samd-atlantis/A-14329-RG-Atlantis-Modem/hardware/easyeda/plug-labels-board-3d.png

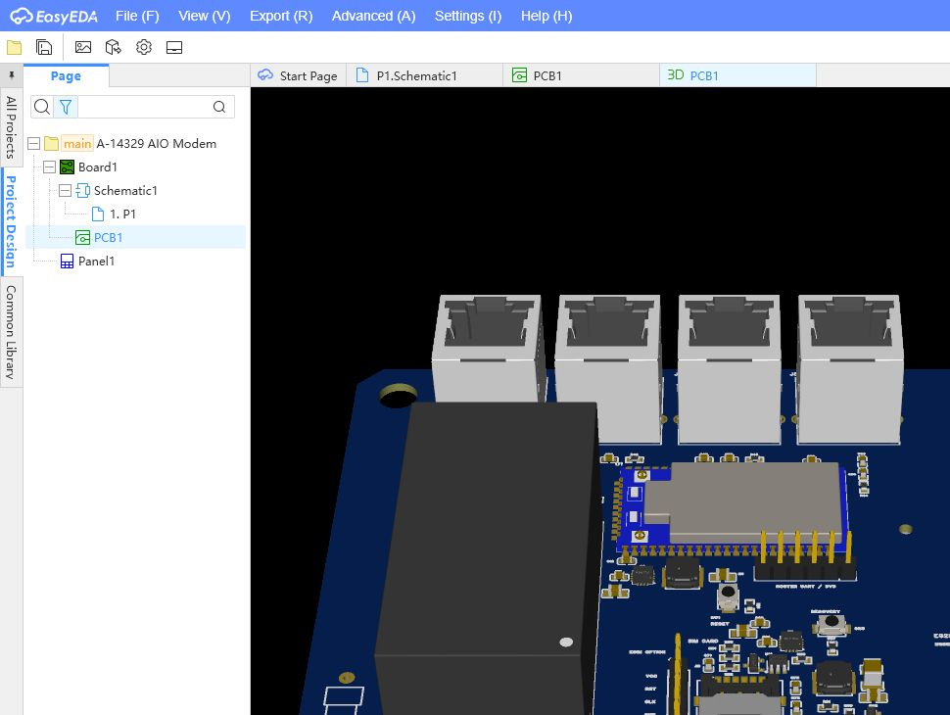
hardware/easyeda/plug-labels-board-3d.png
