samd-atlantis/A-14329-RG-Atlantis-Modem/hardware/rev-a/references/hlk-p11.png

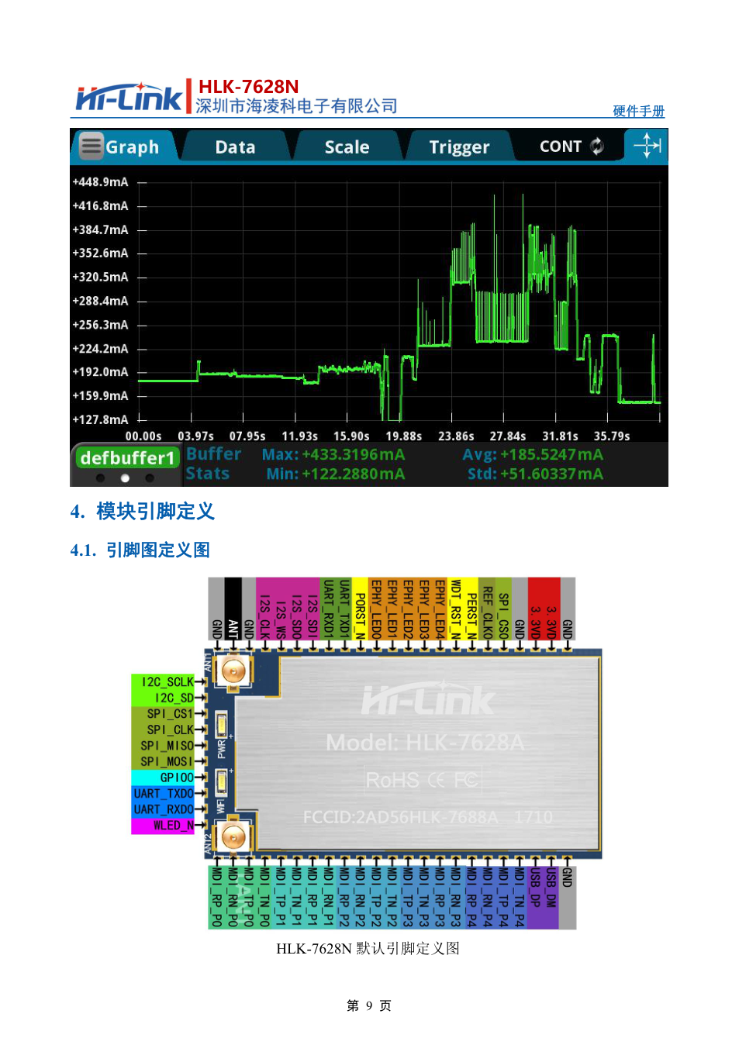
hardware/rev-a/references/hlk-p11.png
