samd-atlantis/A-14329-RG-Atlantis-Modem/firmware/preview/dashboard.png

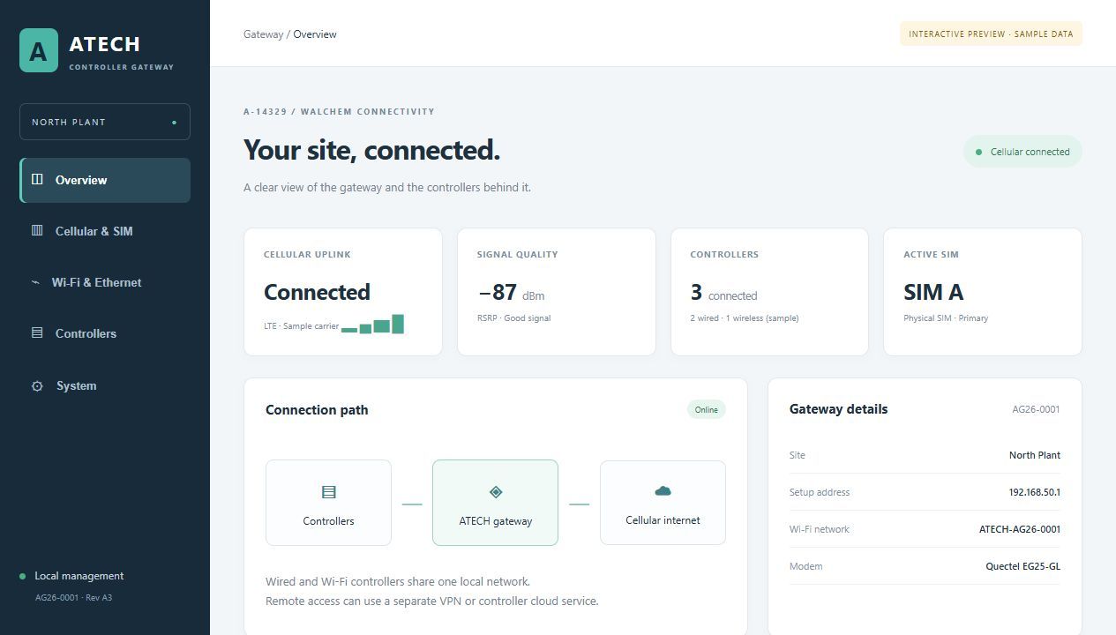
firmware/preview/dashboard.png
