samd-atlantis/A-14329-RG-Atlantis-Modem/hardware/easyeda/C3131-drawing.png

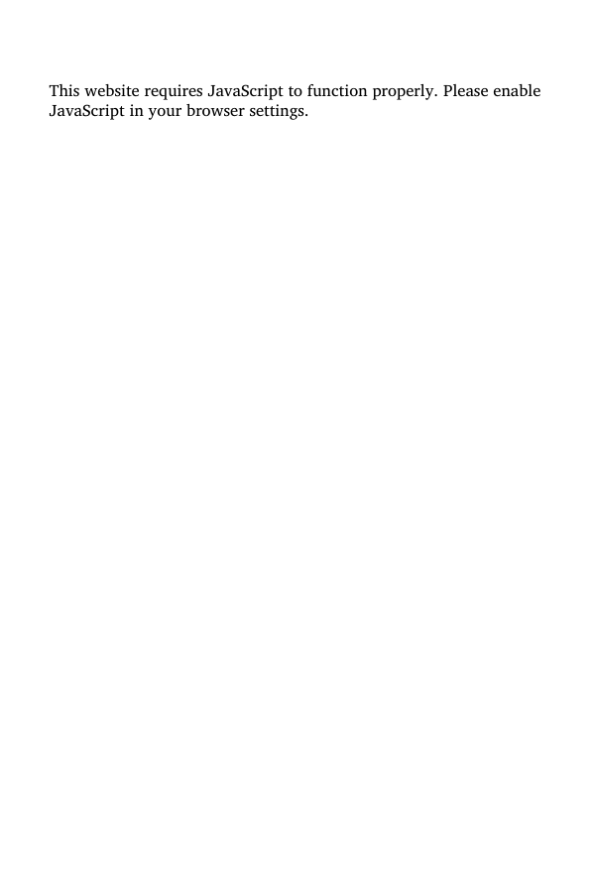
hardware/easyeda/C3131-drawing.png
