samd-atlantis/A-14329-RG-Atlantis-Modem/hardware/easyeda/C5187469-page2.png

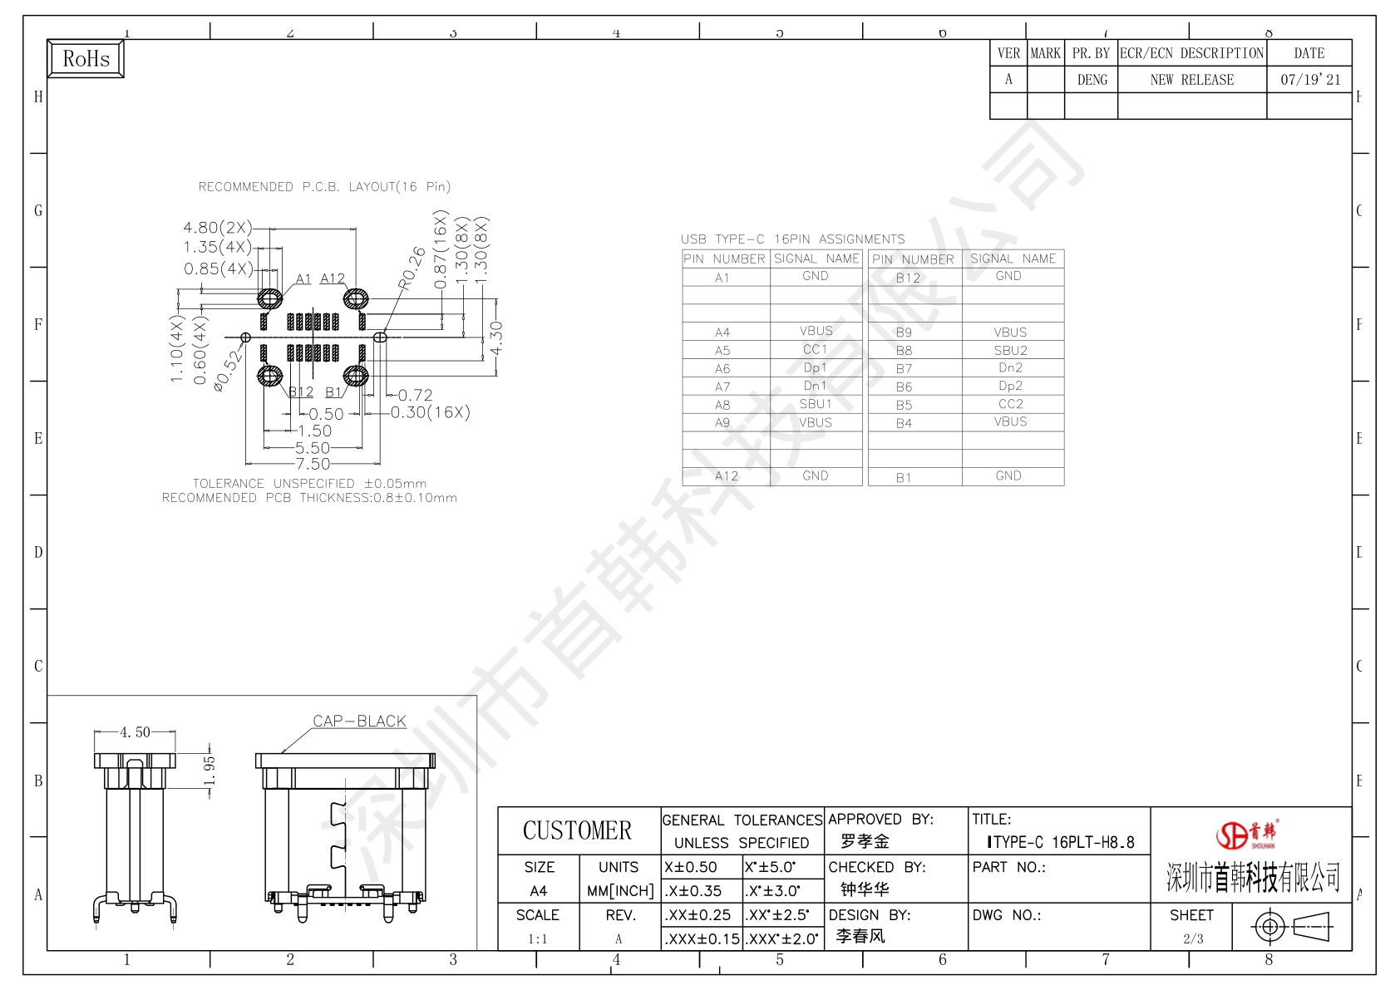
hardware/easyeda/C5187469-page2.png
