samd-atlantis/A-14329-RG-Atlantis-Modem/hardware/easyeda/C32713015-page1.png

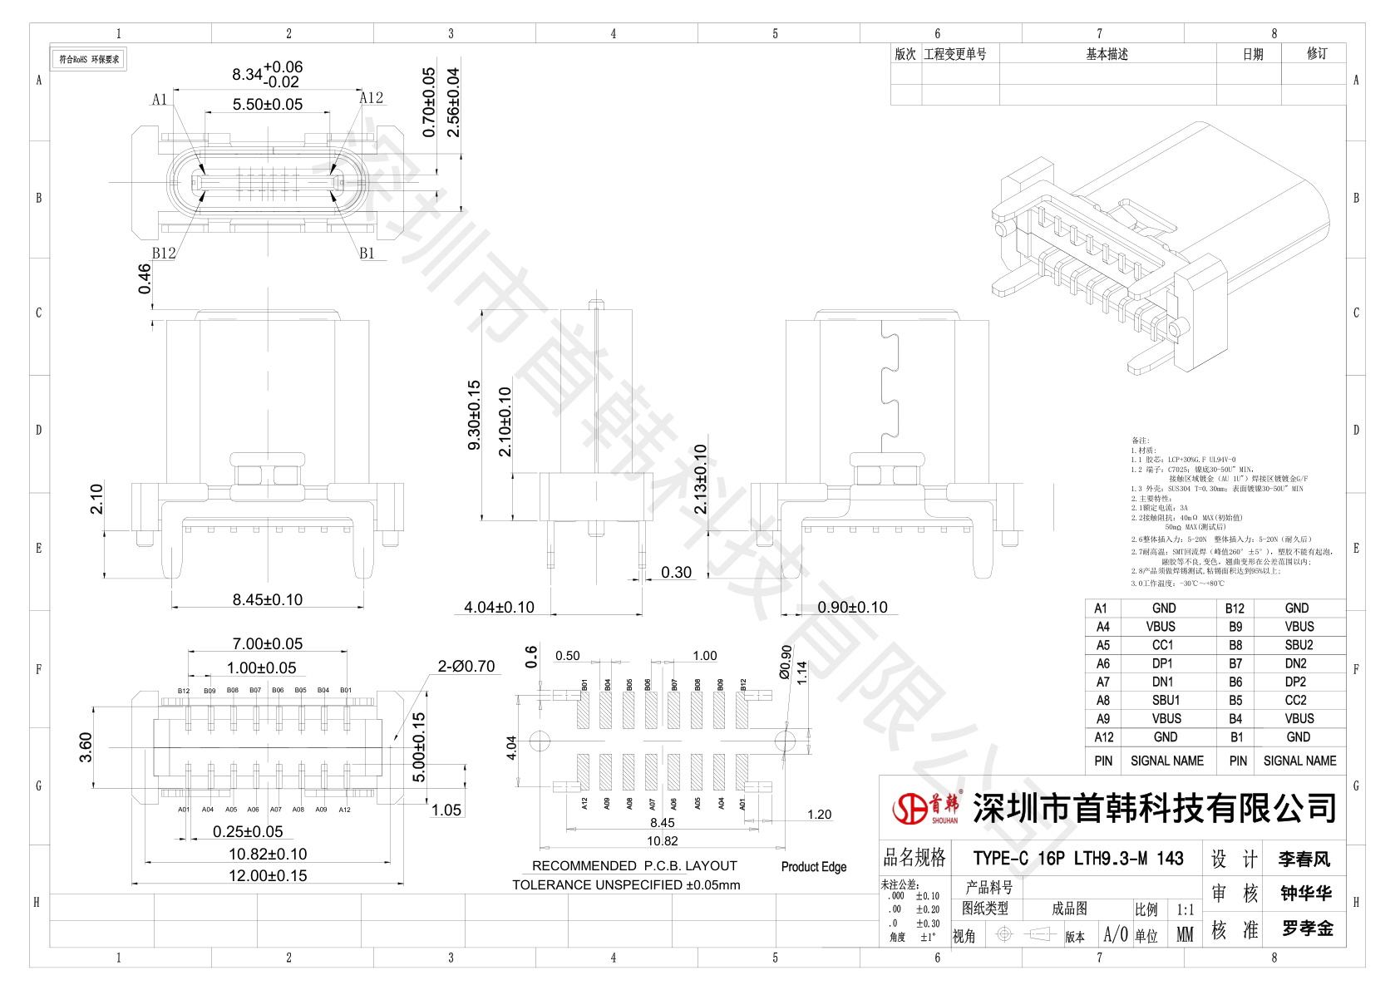
hardware/easyeda/C32713015-page1.png
