samd-atlantis/A-14329-RG-Atlantis-Modem/hardware/easyeda/C51912230-page1.png

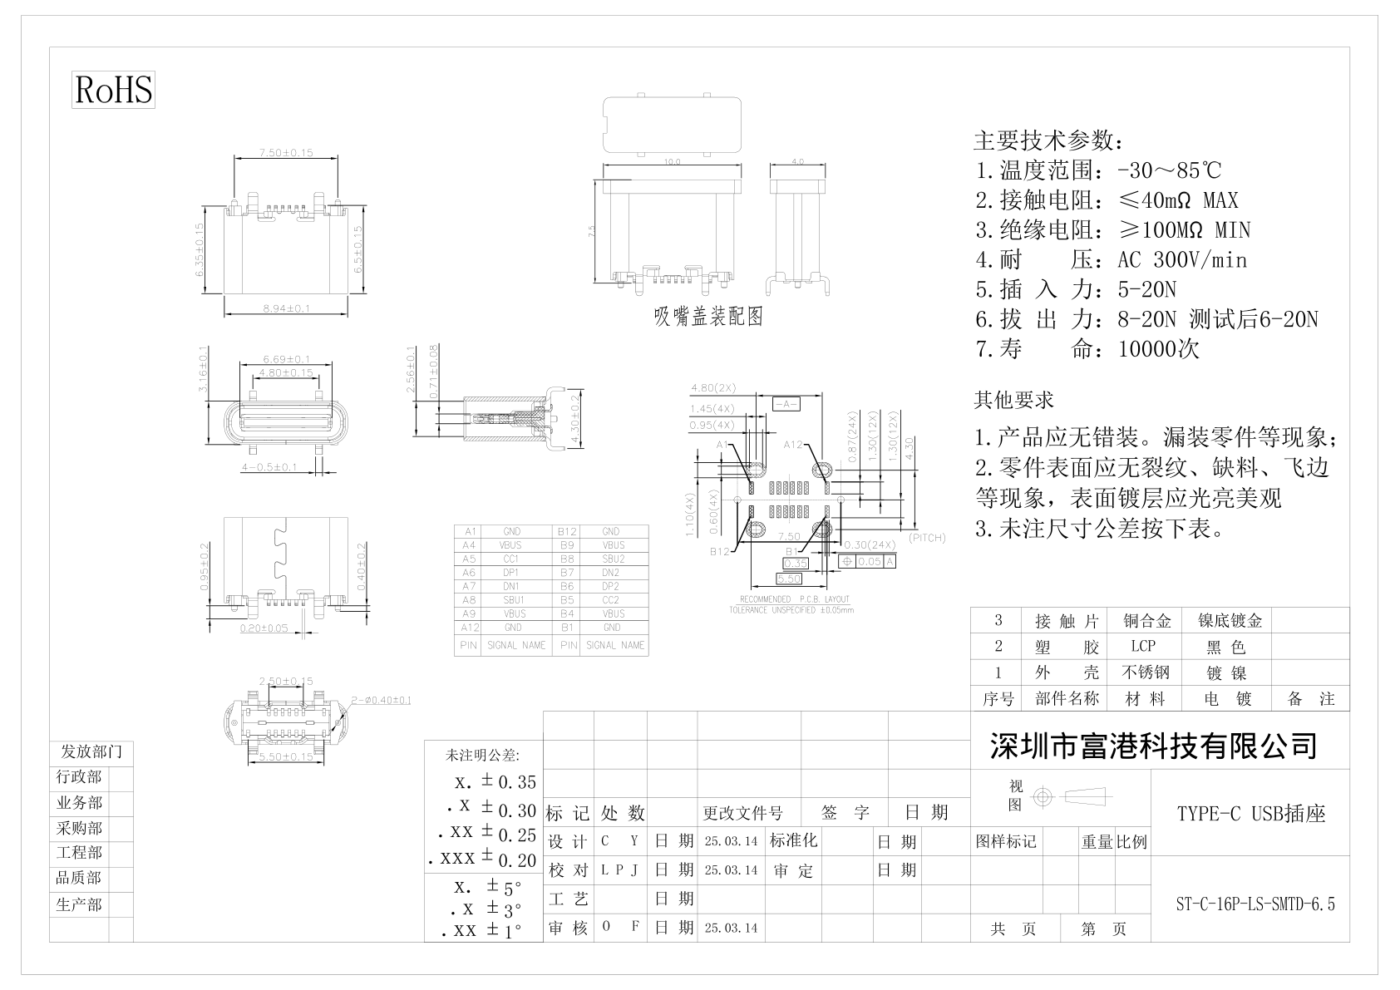
hardware/easyeda/C51912230-page1.png
