samd-atlantis/A-14329-RG-Atlantis-Modem/hardware/easyeda/drc-final42.png

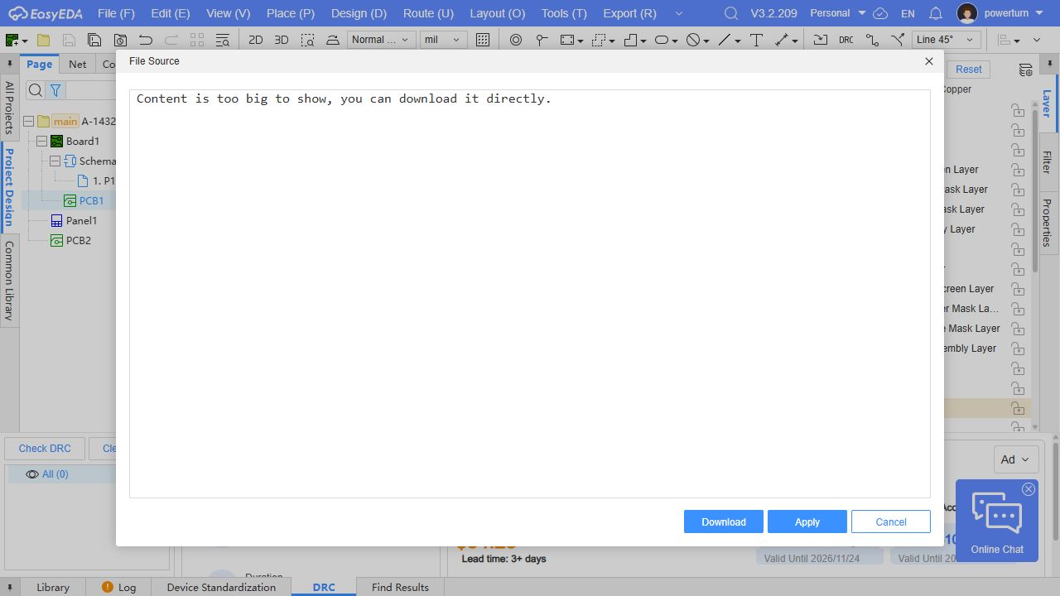
hardware/easyeda/drc-final42.png
