samd-atlantis/A-14329-RG-Atlantis-Modem/hardware/easyeda/drc-final43.png

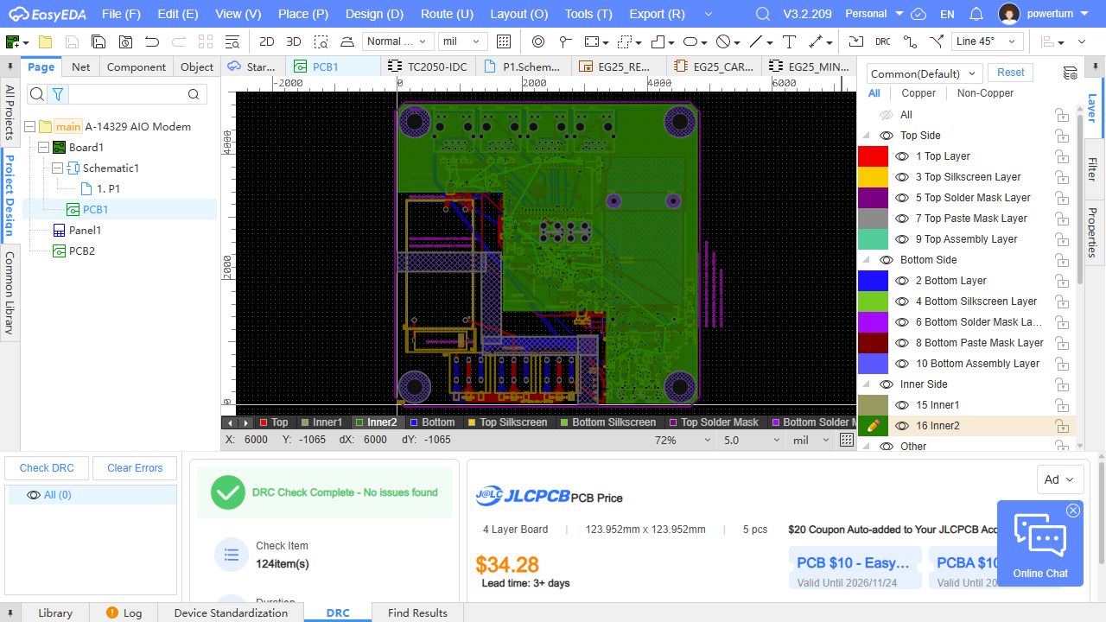
hardware/easyeda/drc-final43.png
