samd-atlantis/A-14329-RG-Atlantis-Modem/hardware/easyeda/dual-usbc-placement.png

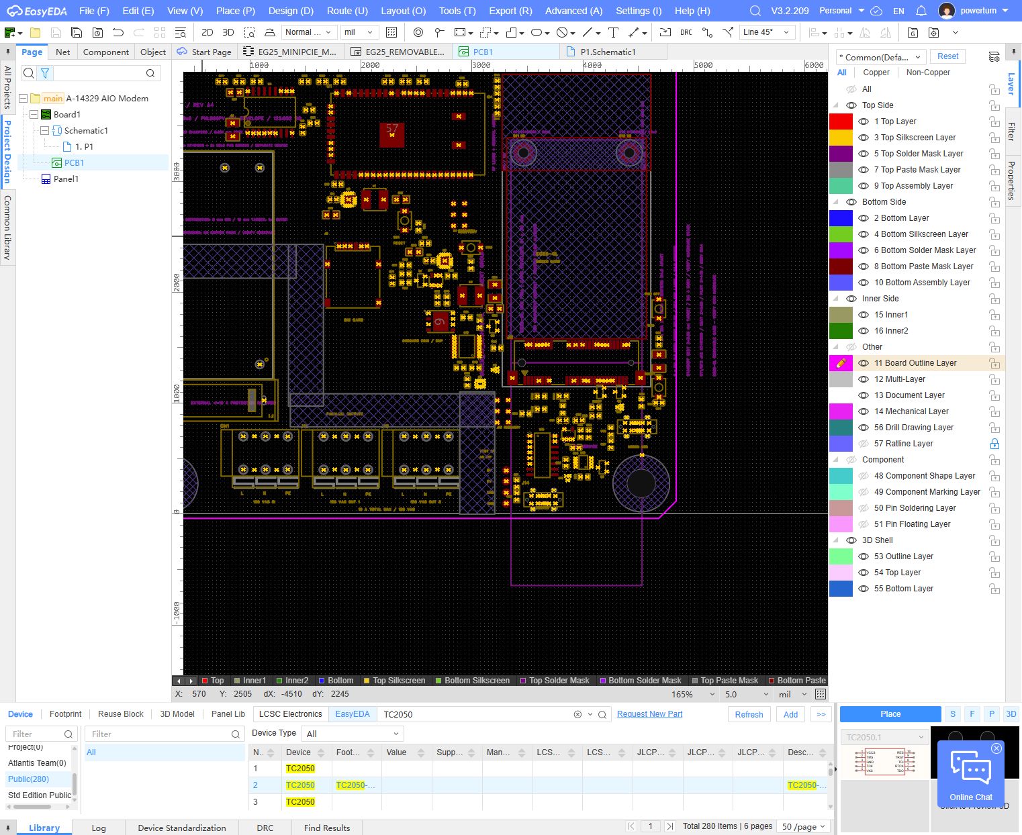
hardware/easyeda/dual-usbc-placement.png
