samd-atlantis/A-14329-RG-Atlantis-Modem/hardware/easyeda/ethernet-schematic-proof.png

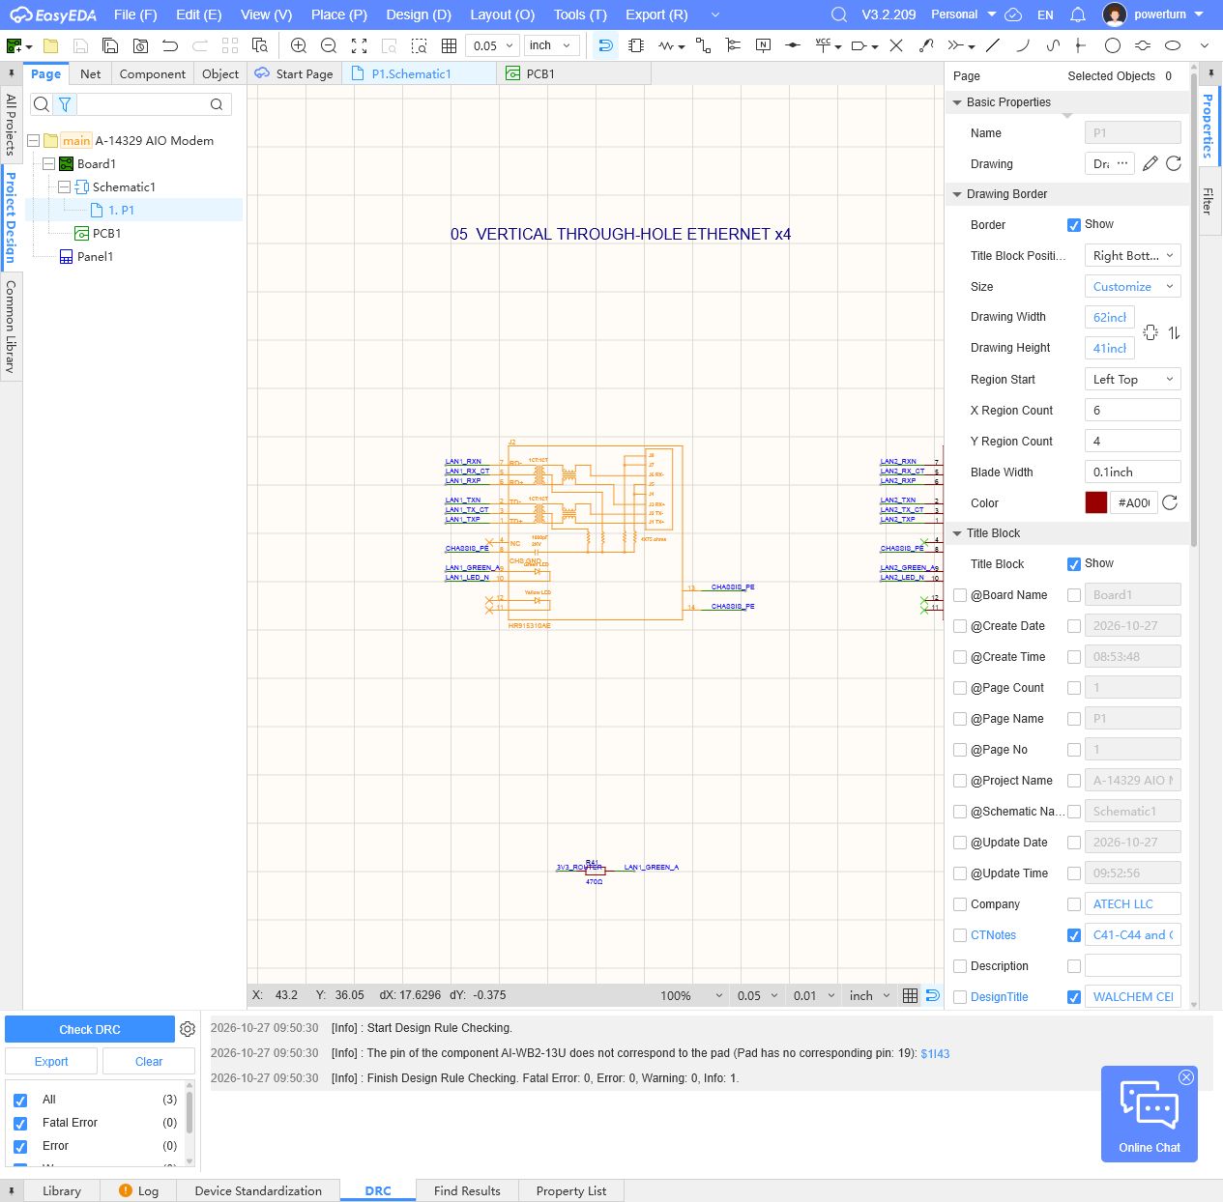
hardware/easyeda/ethernet-schematic-proof.png
