samd-atlantis/A-14329-RG-Atlantis-Modem/hardware/easyeda/hammond-a4-board-3d.png

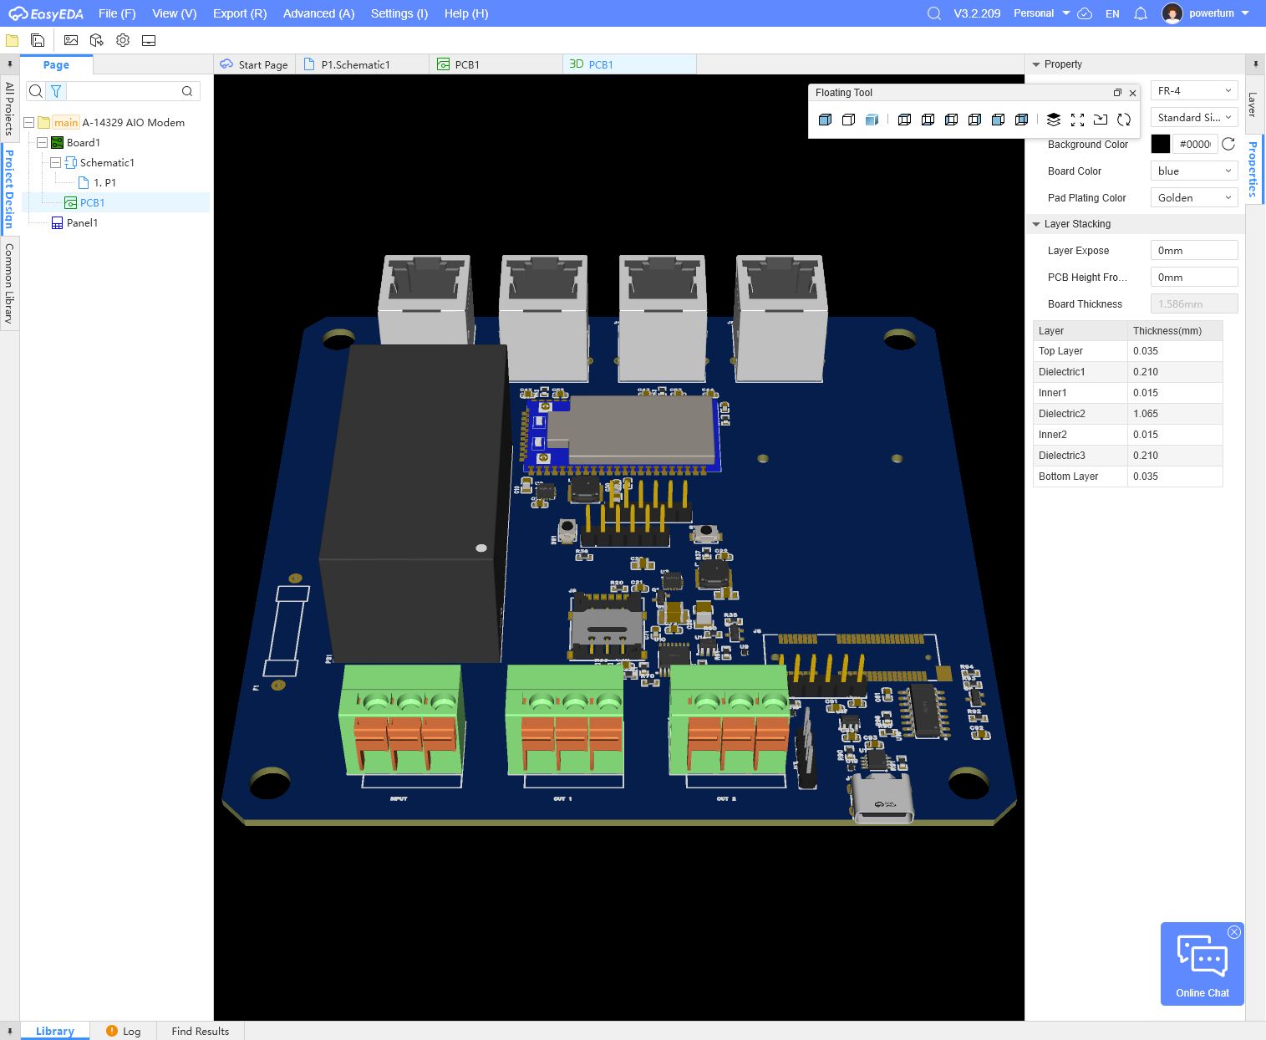
hardware/easyeda/hammond-a4-board-3d.png
