samd-atlantis/A-14329-RG-Atlantis-Modem/hardware/easyeda/hlk-center-tap-reference48.png

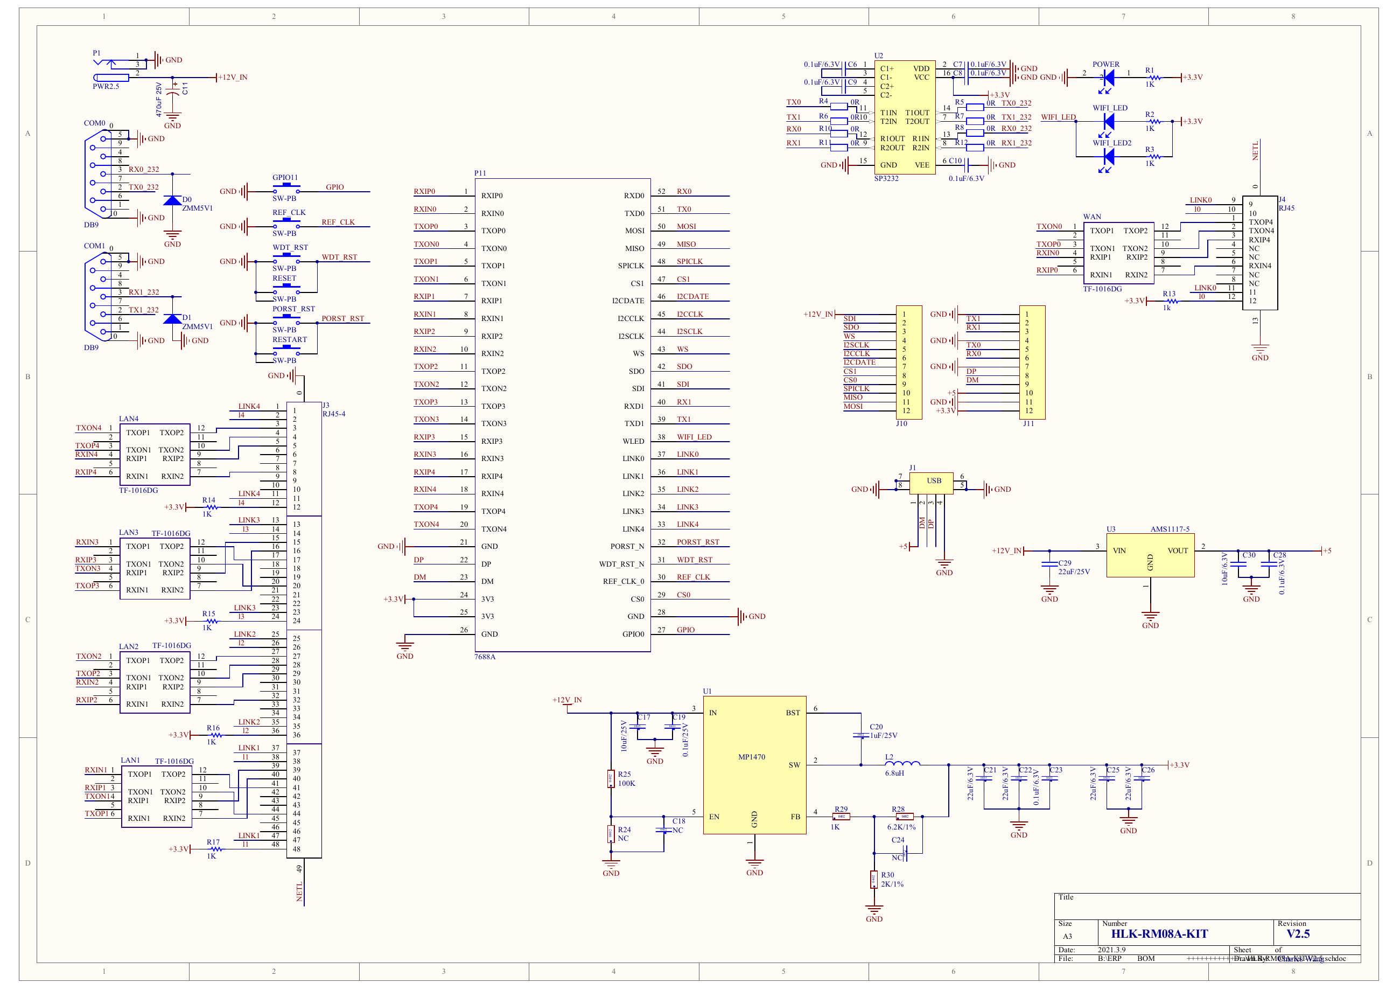
hardware/easyeda/hlk-center-tap-reference48.png
