samd-atlantis/A-14329-RG-Atlantis-Modem/hardware/easyeda/HR915310AE-review48.png

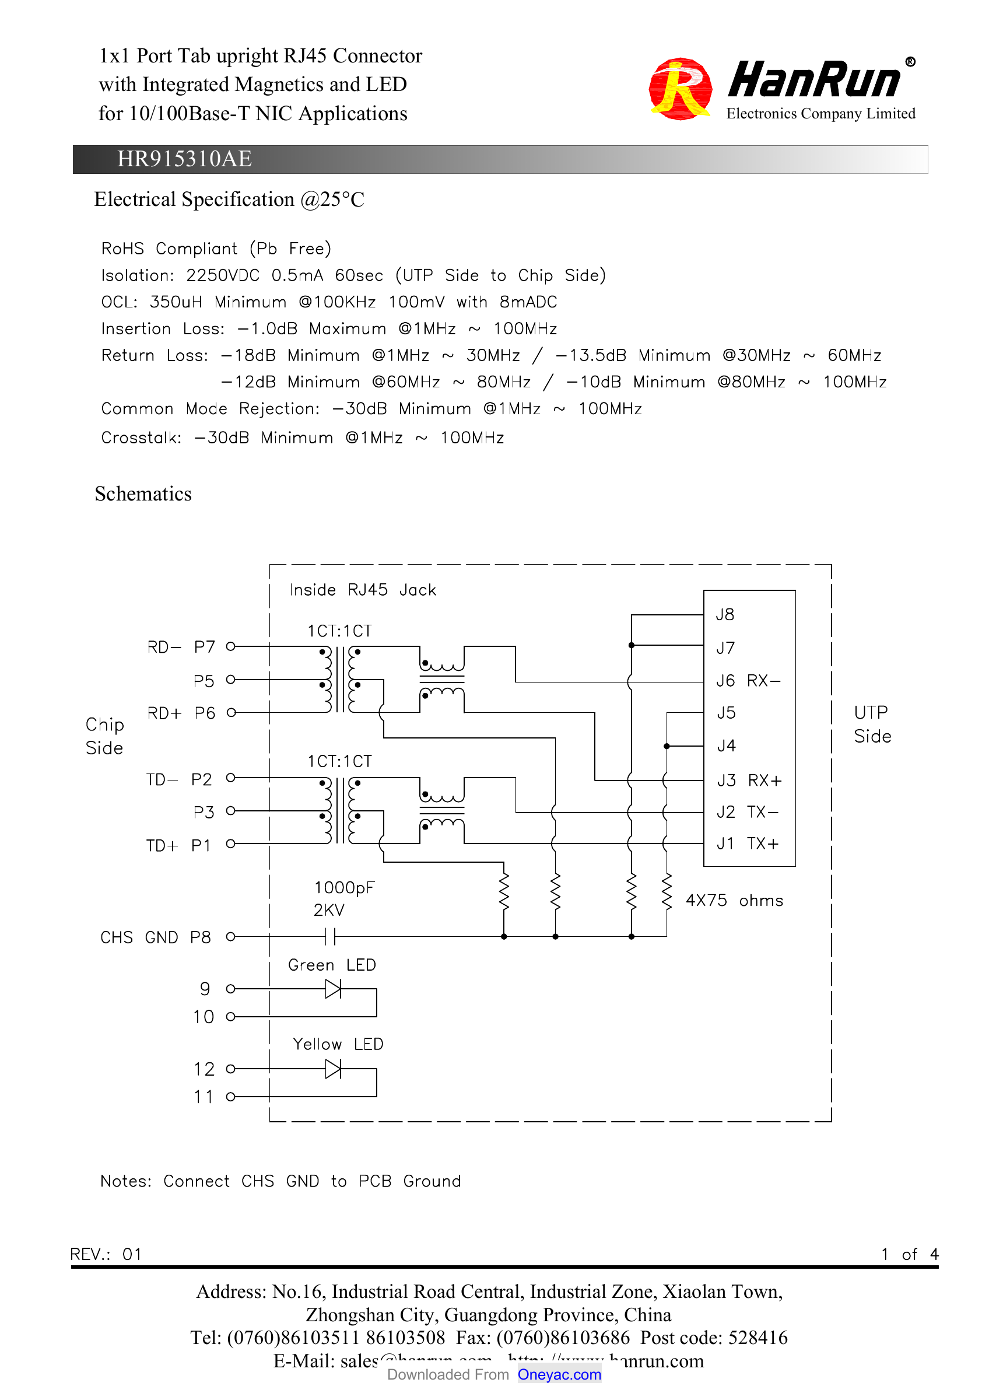
hardware/easyeda/HR915310AE-review48.png
