samd-atlantis/A-14329-RG-Atlantis-Modem/hardware/easyeda/impedance-jlc-7628-calculator.png

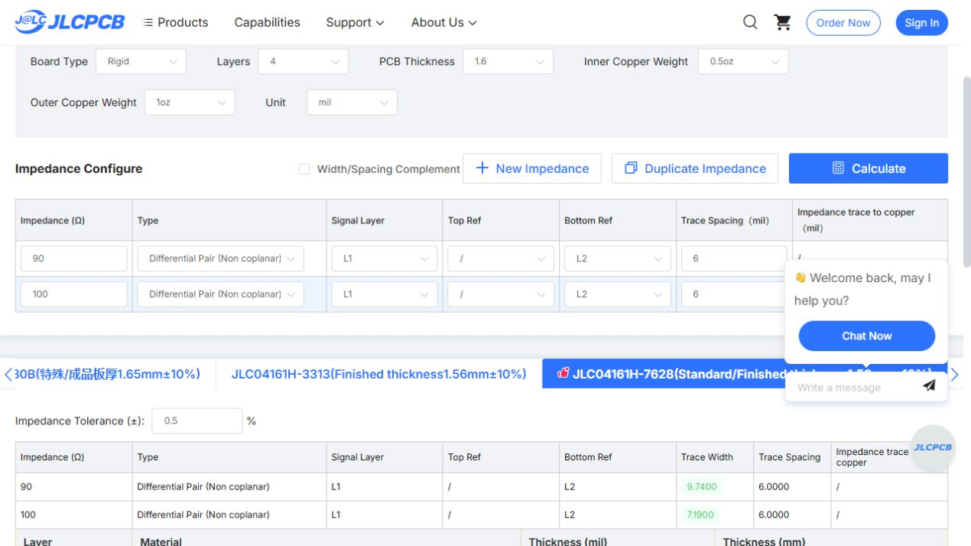
hardware/easyeda/impedance-jlc-7628-calculator.png
