samd-atlantis/A-14329-RG-Atlantis-Modem/hardware/easyeda/integra-6x6-outline.png

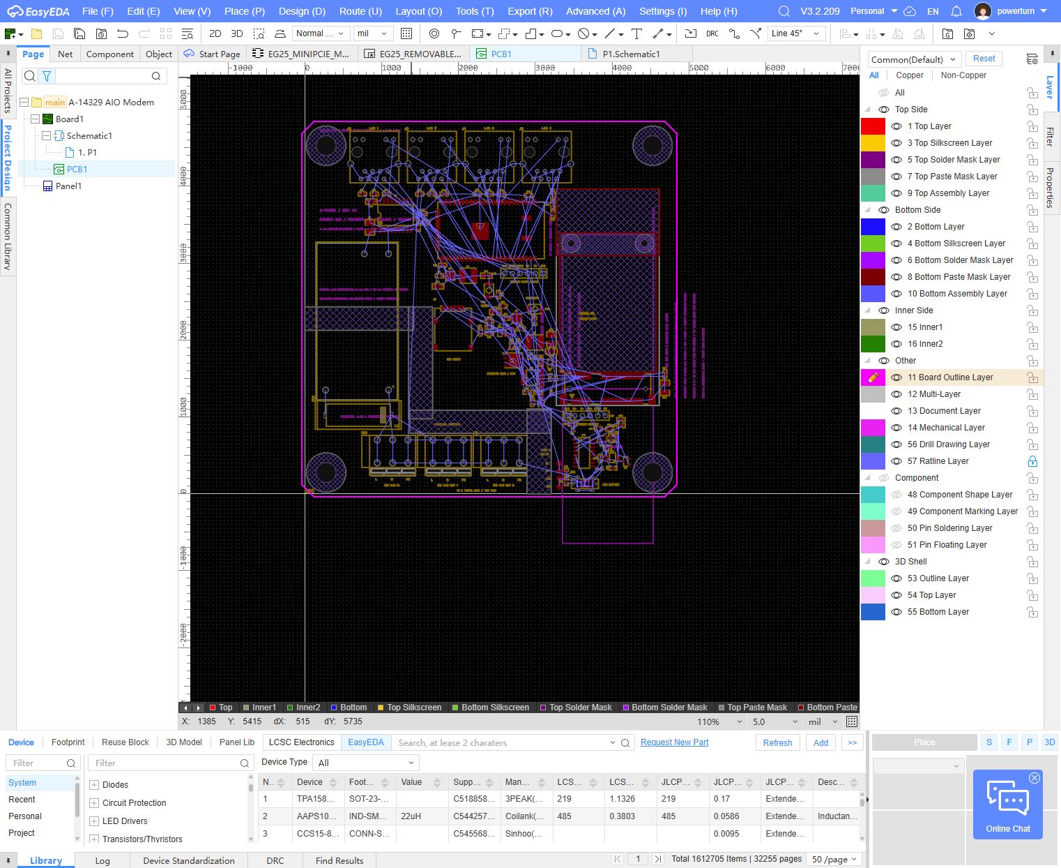
hardware/easyeda/integra-6x6-outline.png
