samd-atlantis/A-14329-RG-Atlantis-Modem/hardware/easyeda/JAE-MM60-E1-drawing.png

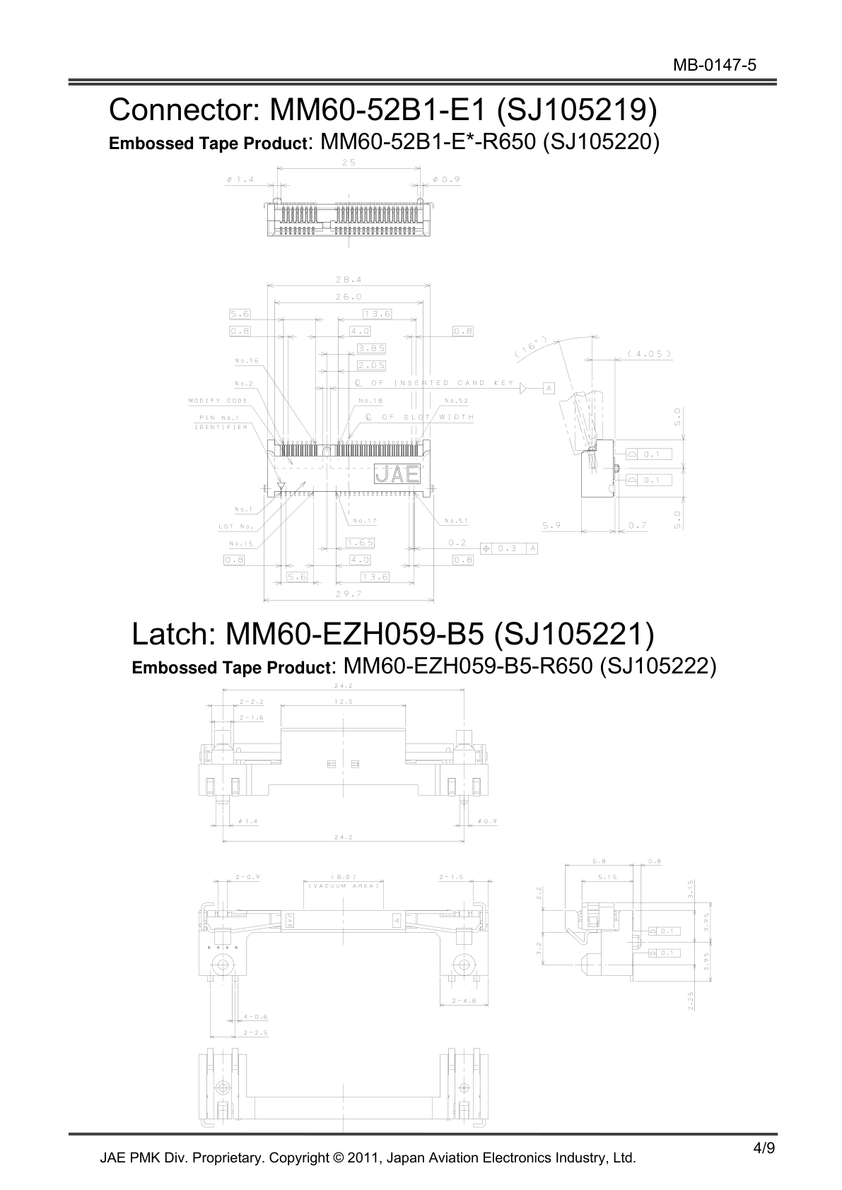
hardware/easyeda/JAE-MM60-E1-drawing.png
