samd-atlantis/A-14329-RG-Atlantis-Modem/hardware/easyeda/jae-mm60-p4.png

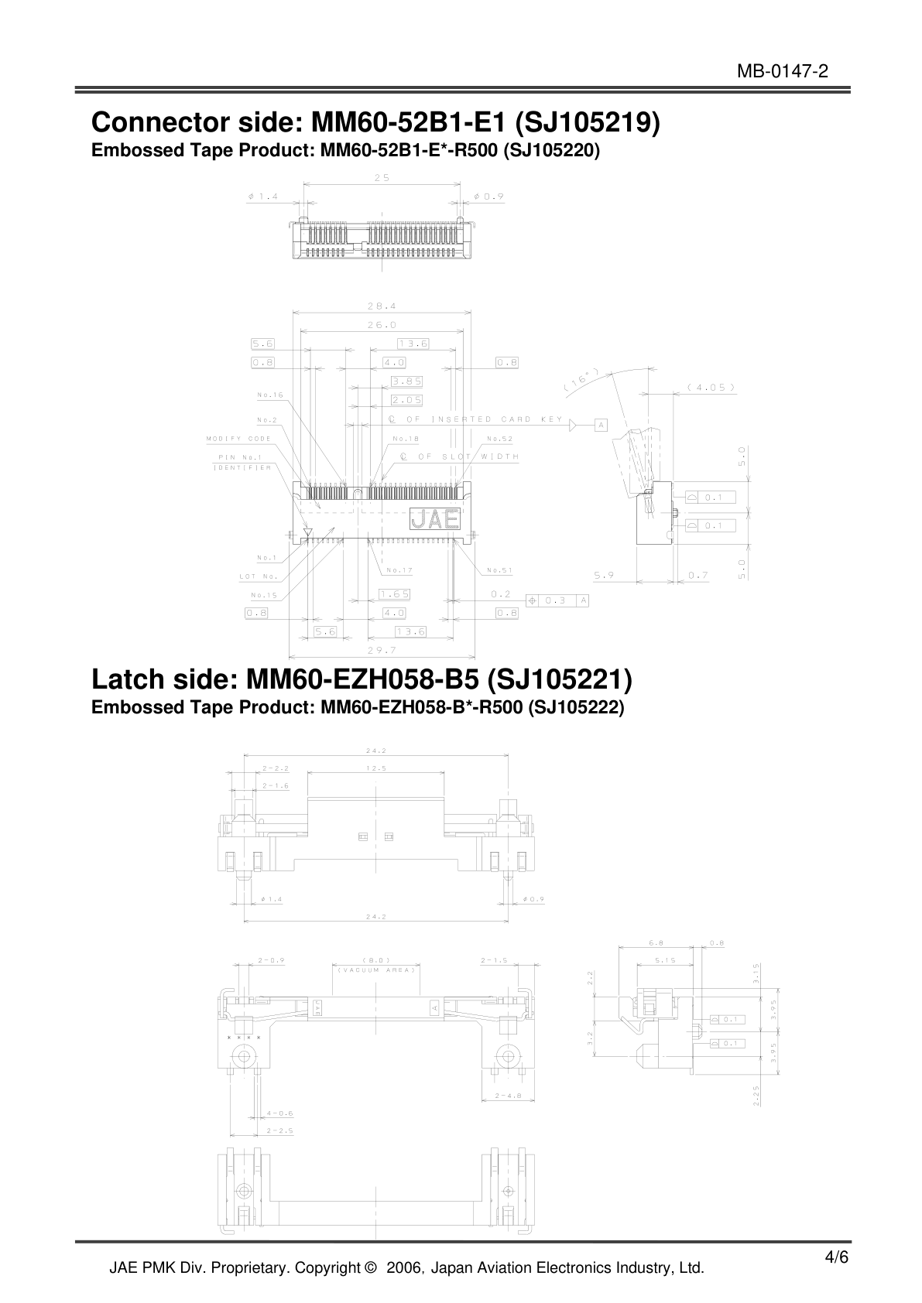
hardware/easyeda/jae-mm60-p4.png
