samd-atlantis/A-14329-RG-Atlantis-Modem/hardware/easyeda/JAE-NT4-drawing.png

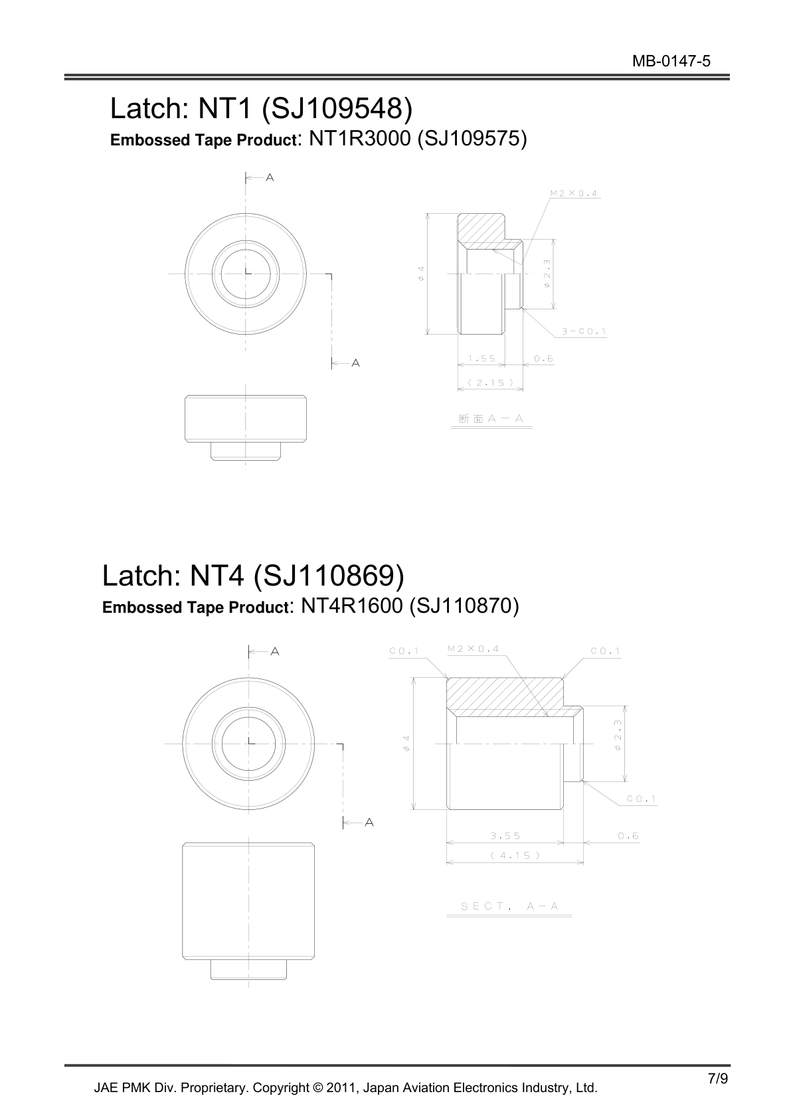
hardware/easyeda/JAE-NT4-drawing.png
