samd-atlantis/A-14329-RG-Atlantis-Modem/hardware/easyeda/jae-seating-detail.png

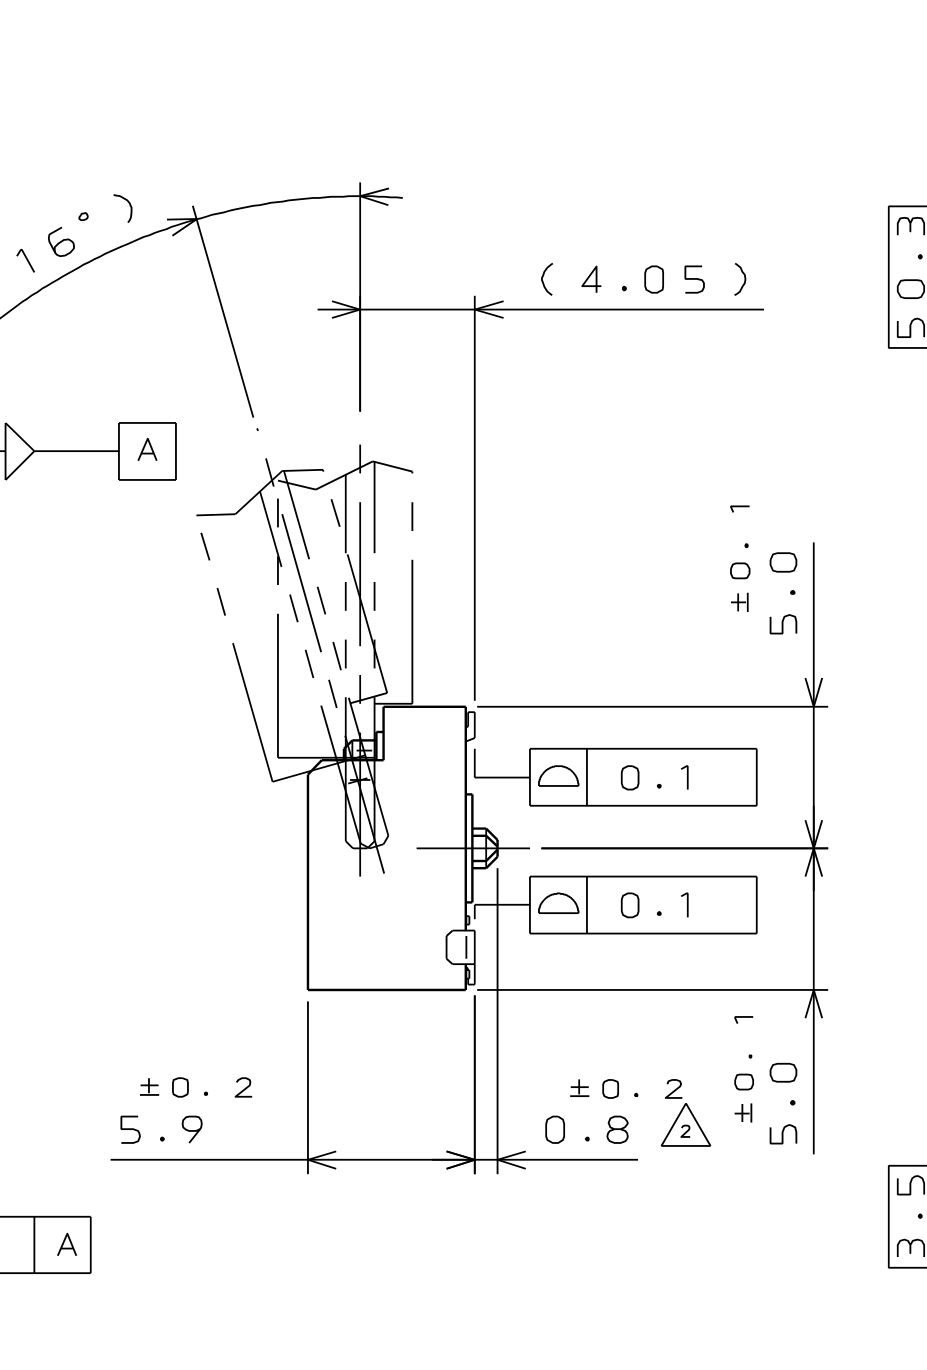
hardware/easyeda/jae-seating-detail.png
