samd-atlantis/A-14329-RG-Atlantis-Modem/hardware/easyeda/mff2-p7.png

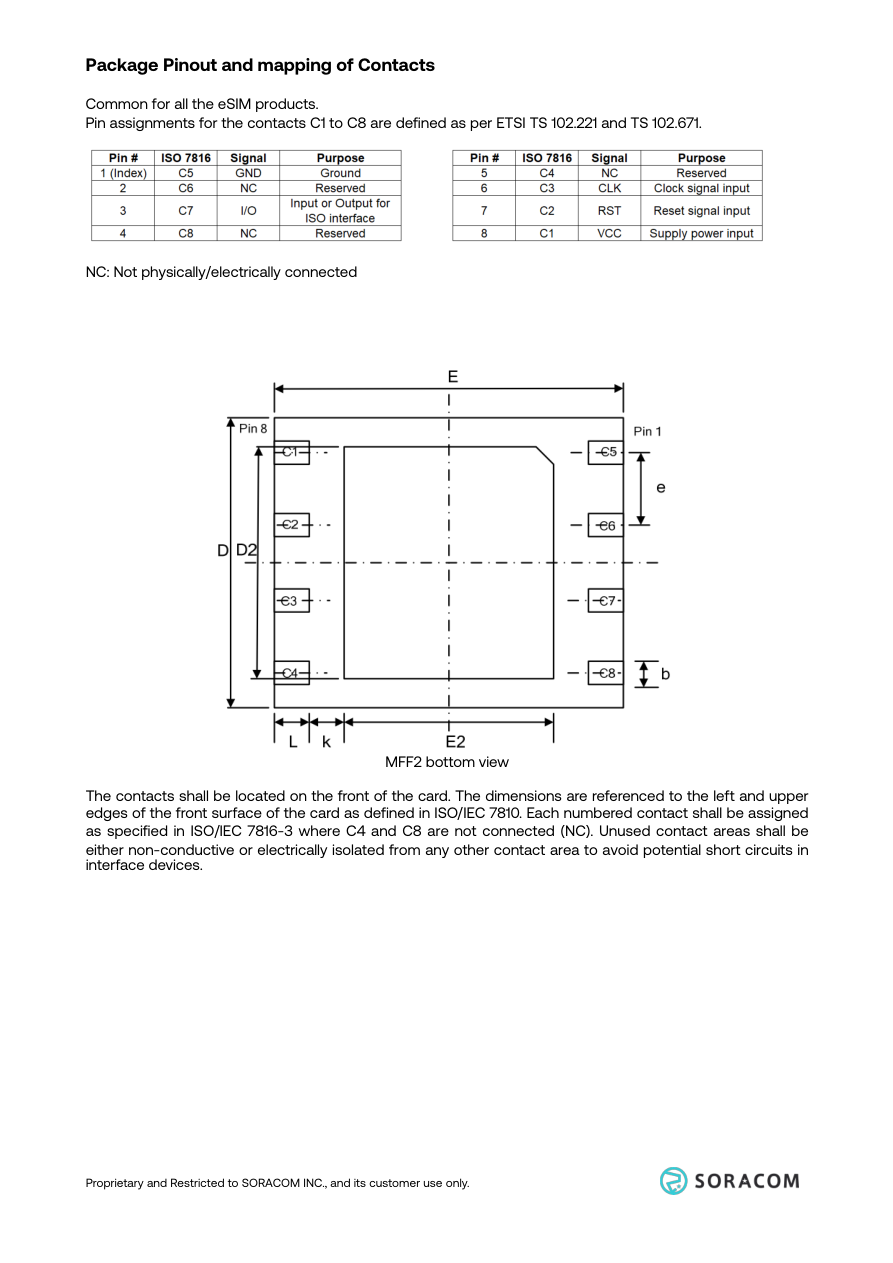
hardware/easyeda/mff2-p7.png
