samd-atlantis/A-14329-RG-Atlantis-Modem/hardware/easyeda/modem-height-corrected46.png

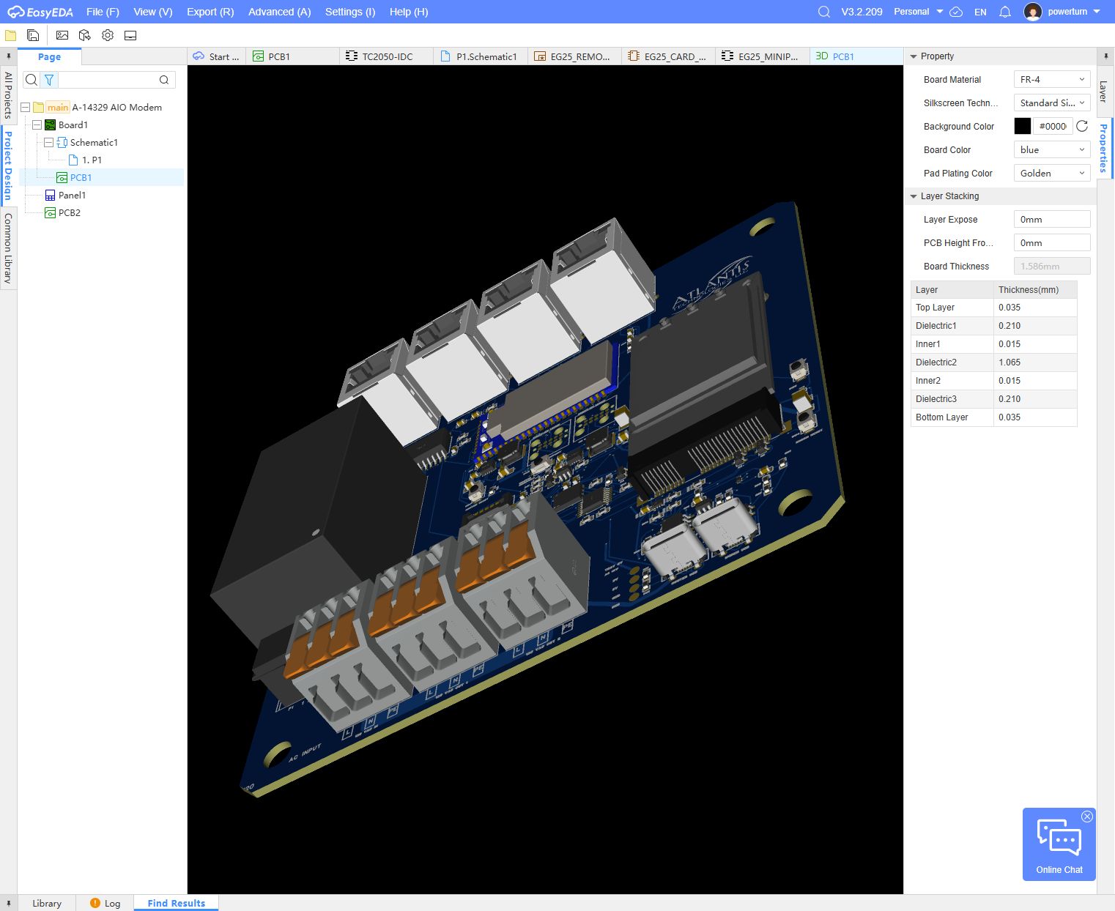
hardware/easyeda/modem-height-corrected46.png
