samd-atlantis/A-14329-RG-Atlantis-Modem/hardware/easyeda/modem-holder-models-corrected-3d.png

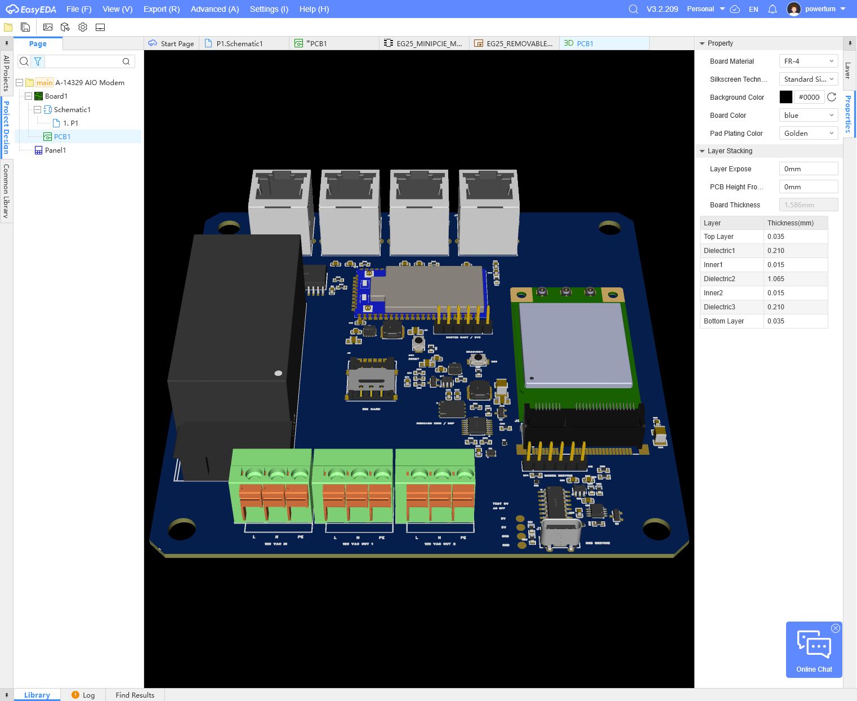
hardware/easyeda/modem-holder-models-corrected-3d.png
