samd-atlantis/A-14329-RG-Atlantis-Modem/hardware/easyeda/modem-mechanical-proof.png

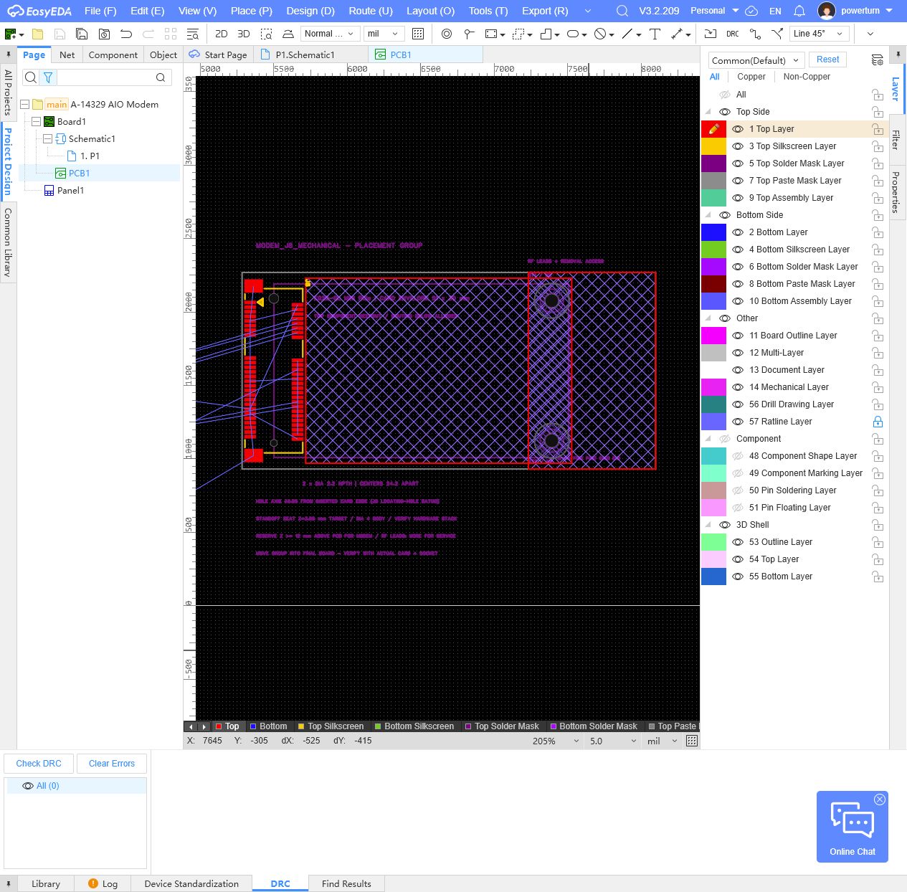
hardware/easyeda/modem-mechanical-proof.png
