samd-atlantis/A-14329-RG-Atlantis-Modem/hardware/easyeda/modem-recovery-controls-schematic.png

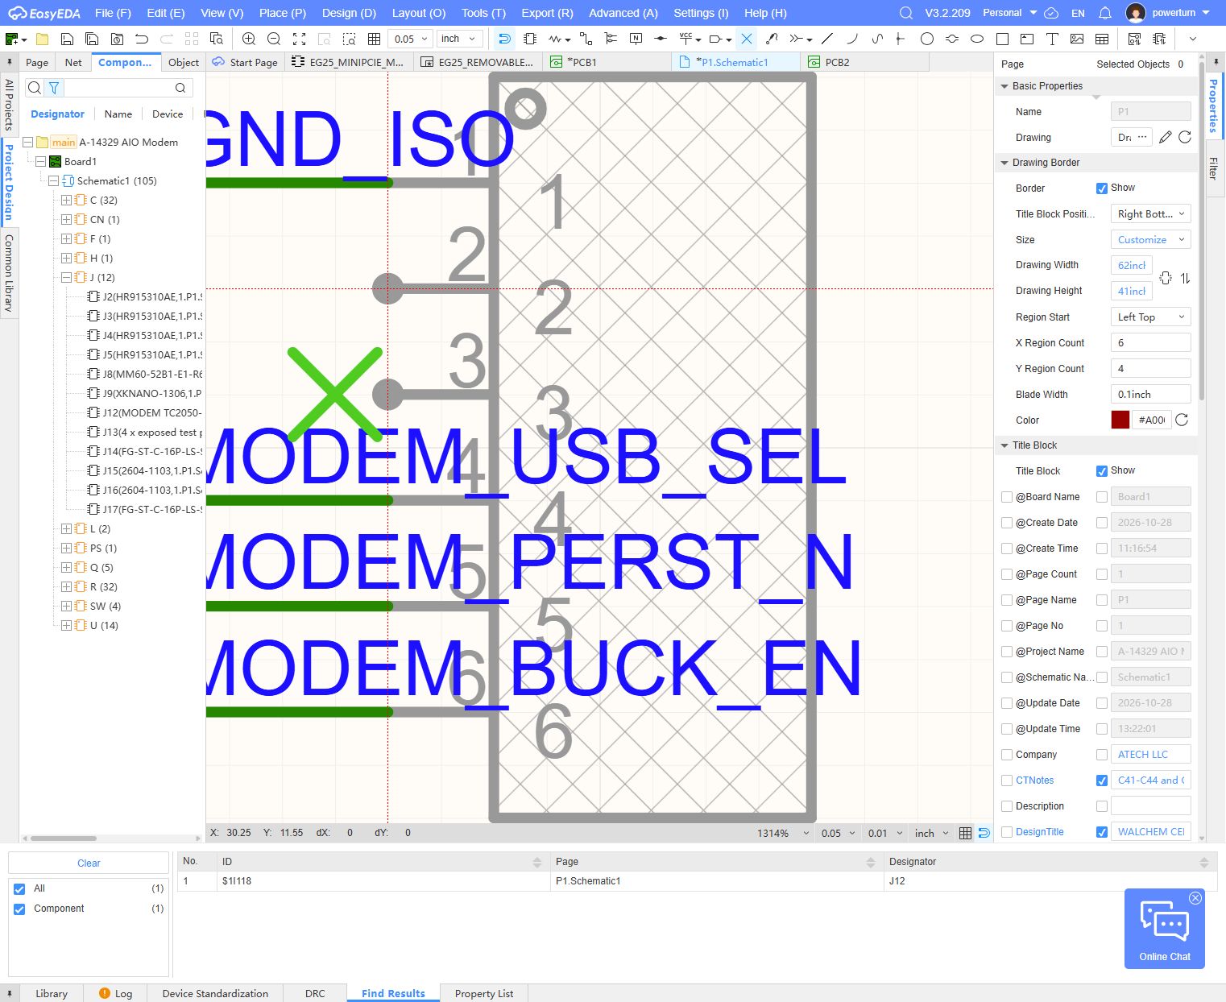
hardware/easyeda/modem-recovery-controls-schematic.png
