samd-atlantis/A-14329-RG-Atlantis-Modem/hardware/easyeda/modem-socket-rotation-corrected44.png

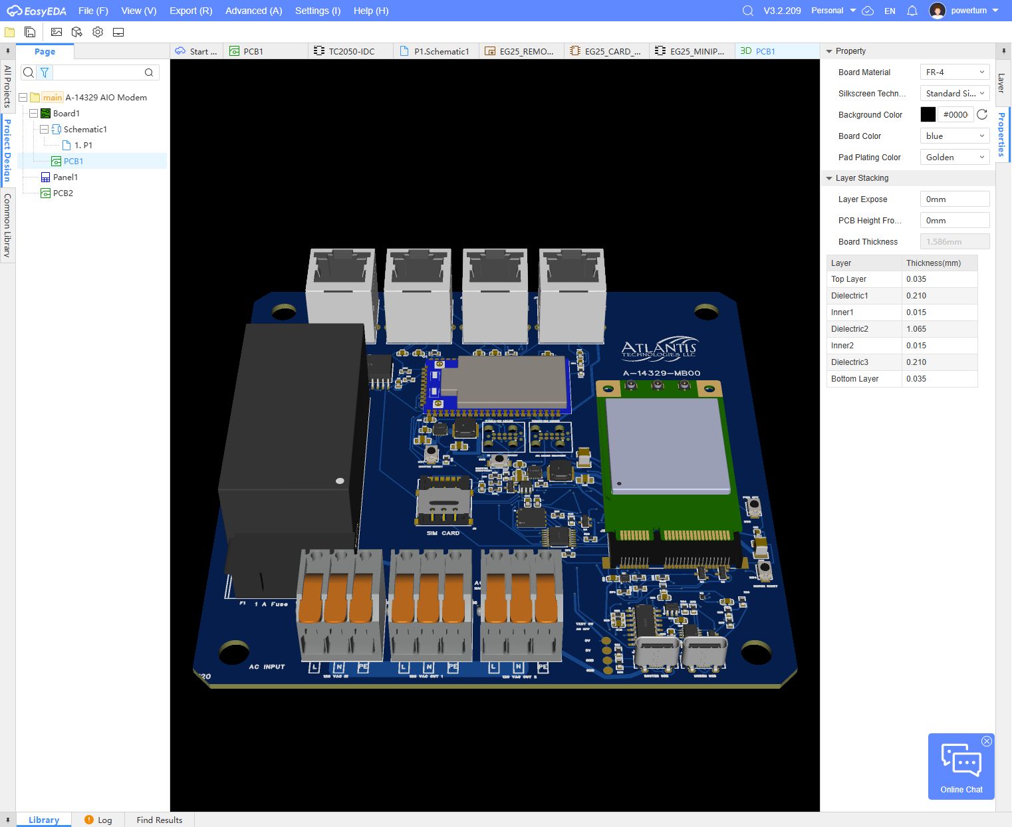
hardware/easyeda/modem-socket-rotation-corrected44.png
