samd-atlantis/A-14329-RG-Atlantis-Modem/hardware/easyeda/Omega2S-reference48-1.png

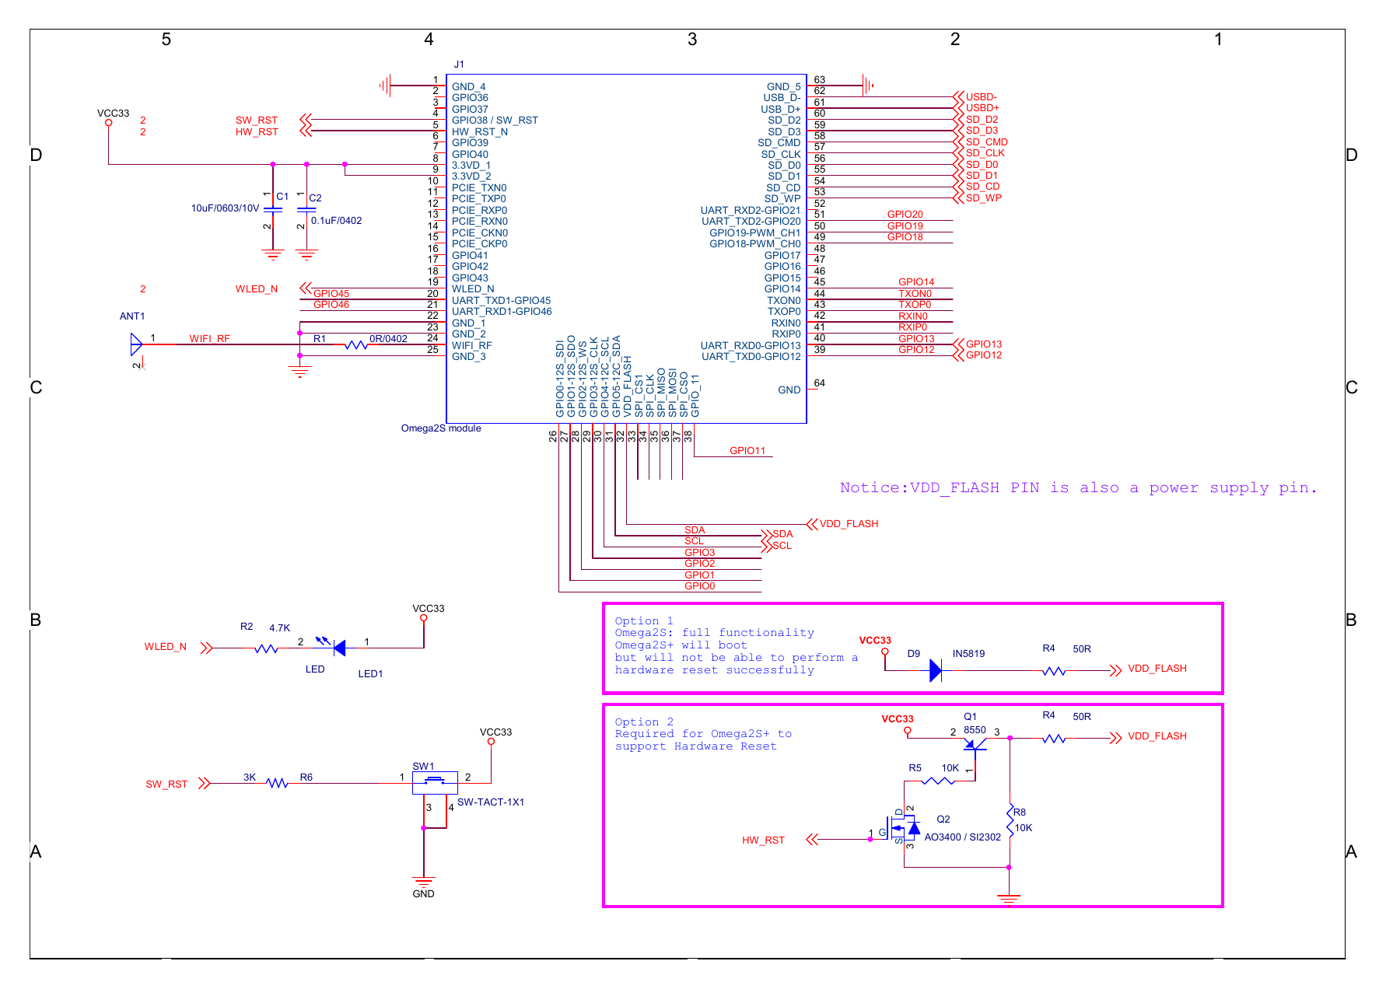
hardware/easyeda/Omega2S-reference48-1.png
