samd-atlantis/A-14329-RG-Atlantis-Modem/hardware/easyeda/plug-labels-proof.png

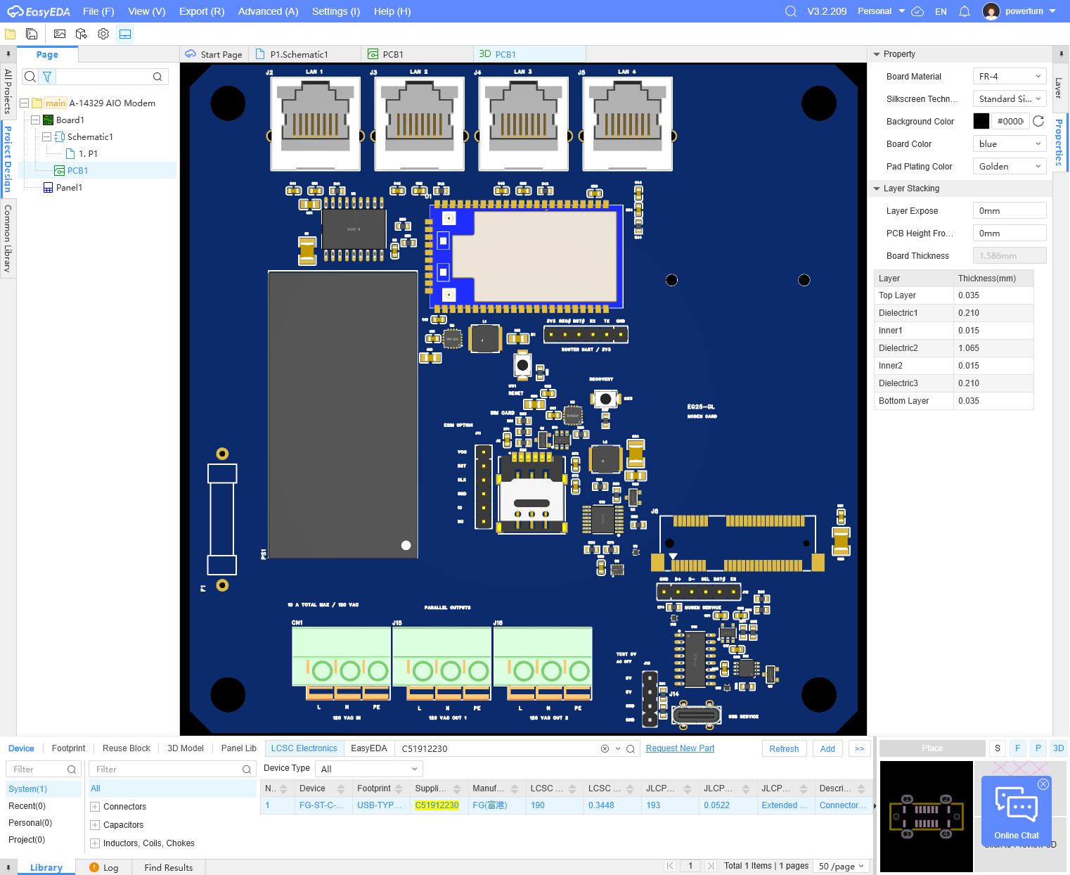
hardware/easyeda/plug-labels-proof.png
