samd-atlantis/A-14329-RG-Atlantis-Modem/hardware/easyeda/plug-labels-top-view.png

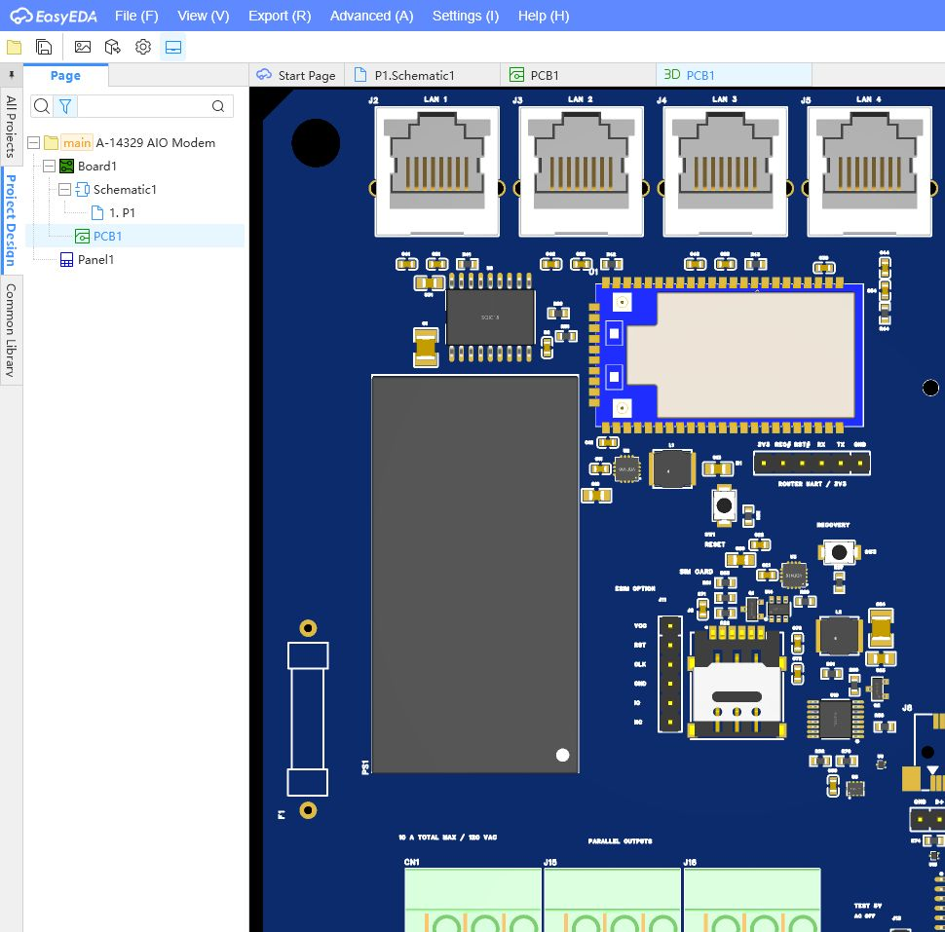
hardware/easyeda/plug-labels-top-view.png
