samd-atlantis/A-14329-RG-Atlantis-Modem/hardware/easyeda/production-routing-rules.png

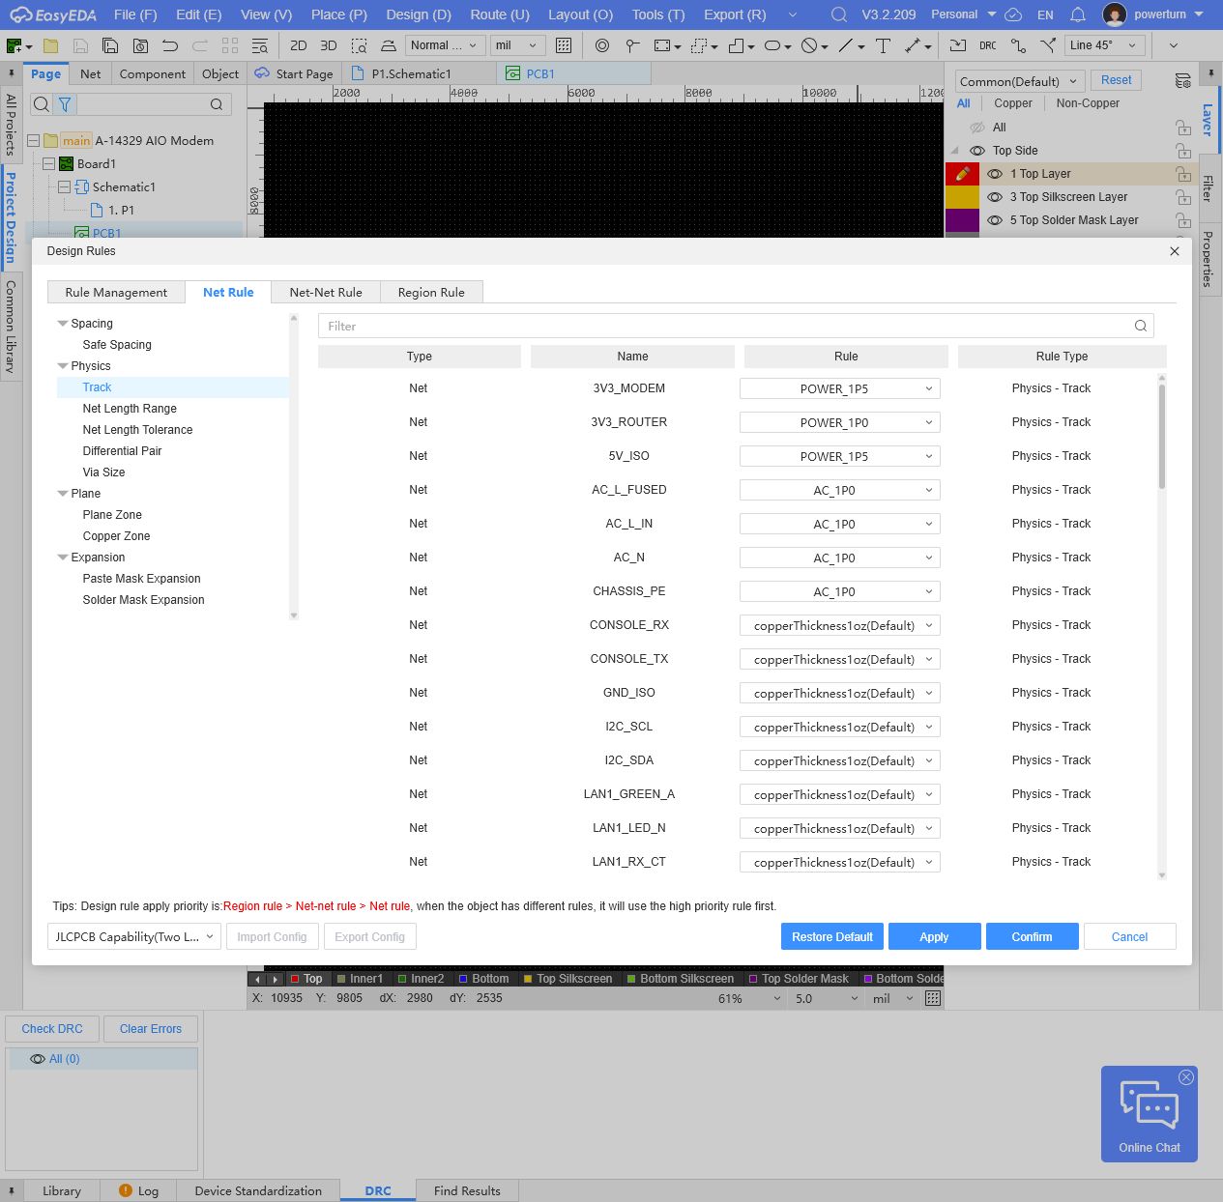
hardware/easyeda/production-routing-rules.png
