samd-atlantis/A-14329-RG-Atlantis-Modem/hardware/easyeda/quectel-mech-p53.png

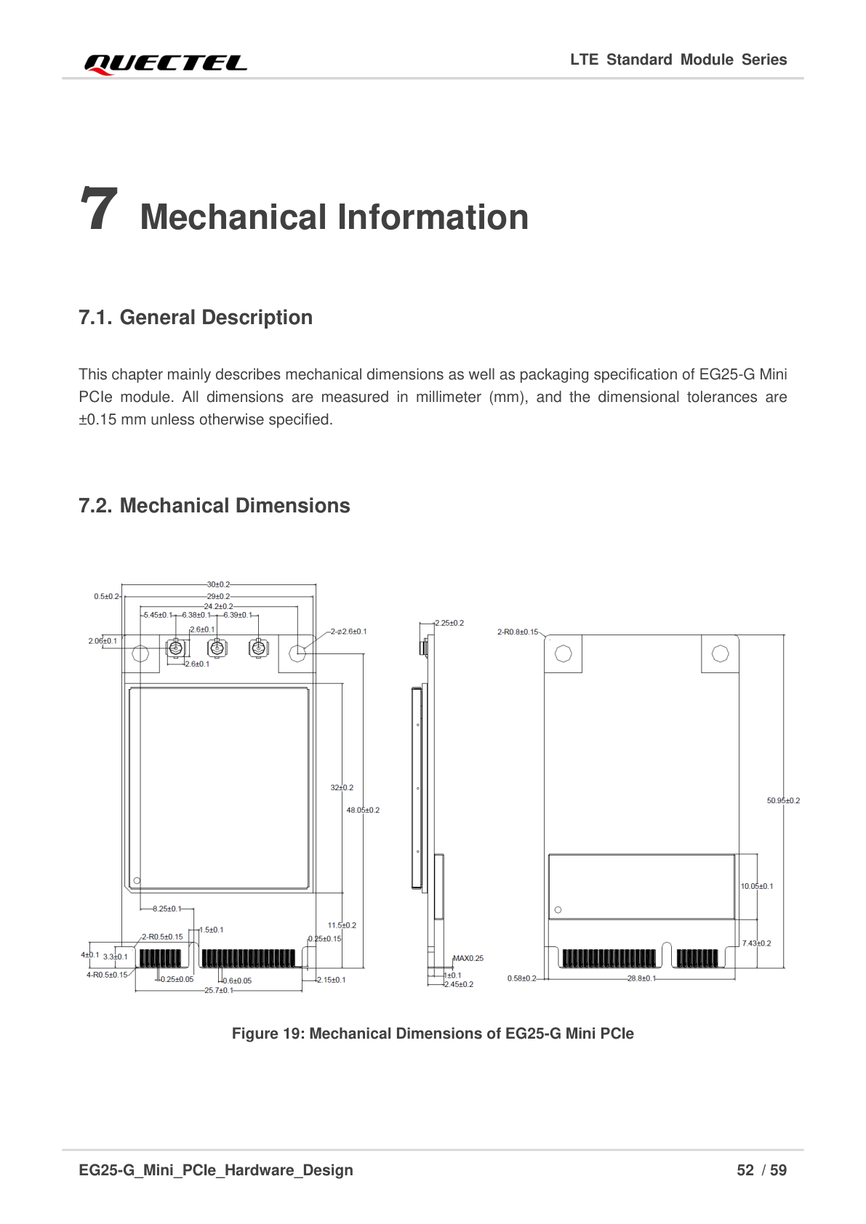
hardware/easyeda/quectel-mech-p53.png
