samd-atlantis/A-14329-RG-Atlantis-Modem/hardware/easyeda/quectel-mech-p54.png

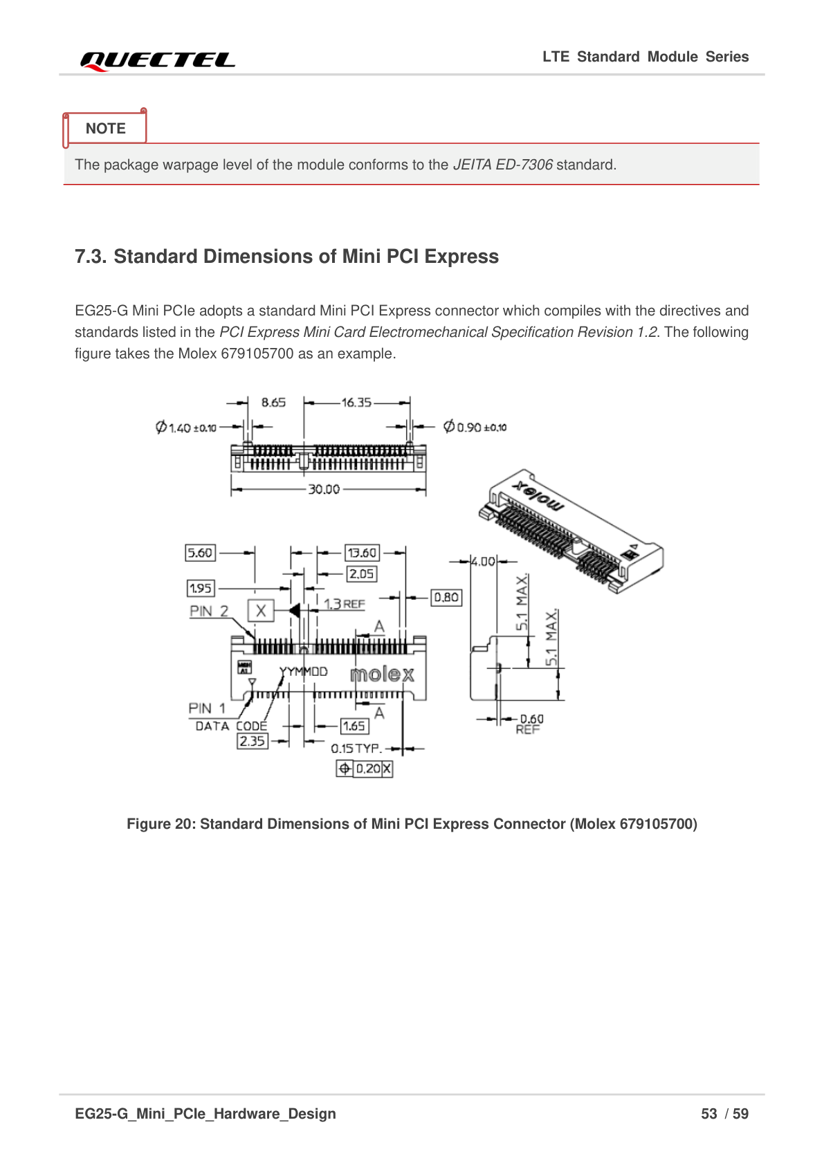
hardware/easyeda/quectel-mech-p54.png
