samd-atlantis/A-14329-RG-Atlantis-Modem/hardware/easyeda/routing-pass1-final.png

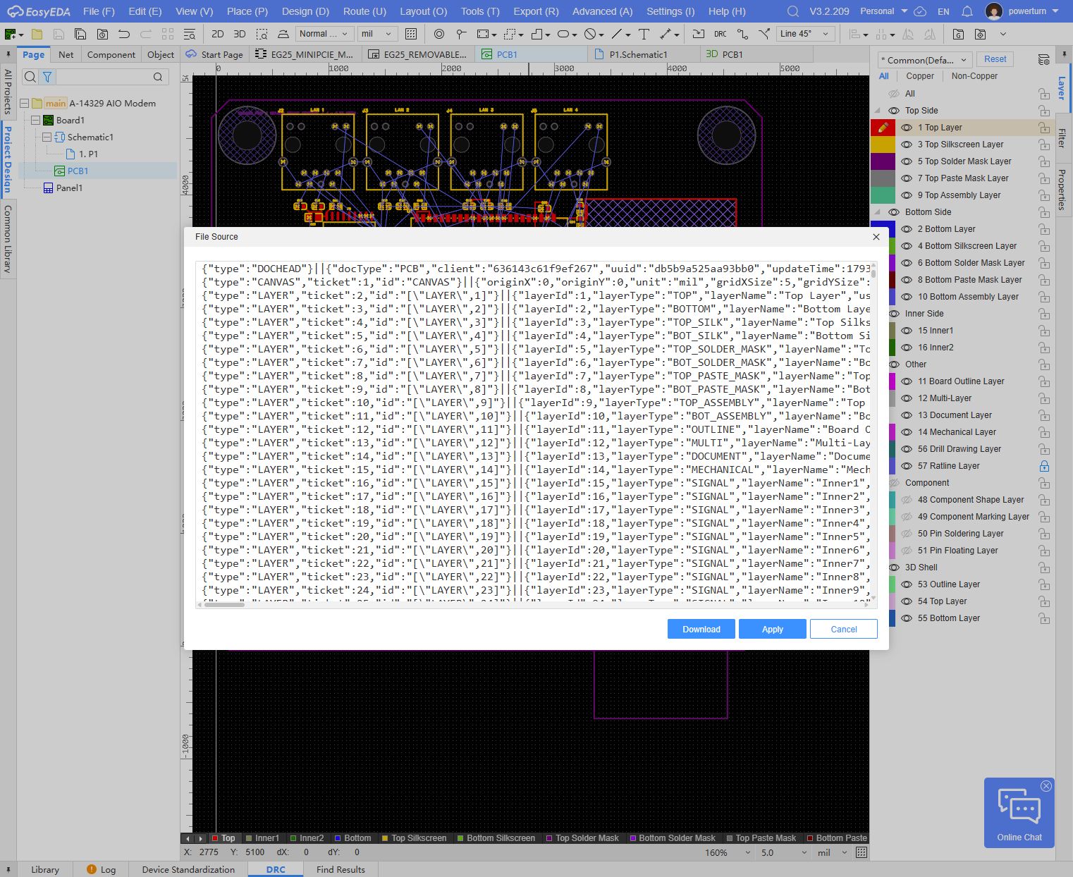
hardware/easyeda/routing-pass1-final.png
