samd-atlantis/A-14329-RG-Atlantis-Modem/hardware/easyeda/routing-pass3-board.png

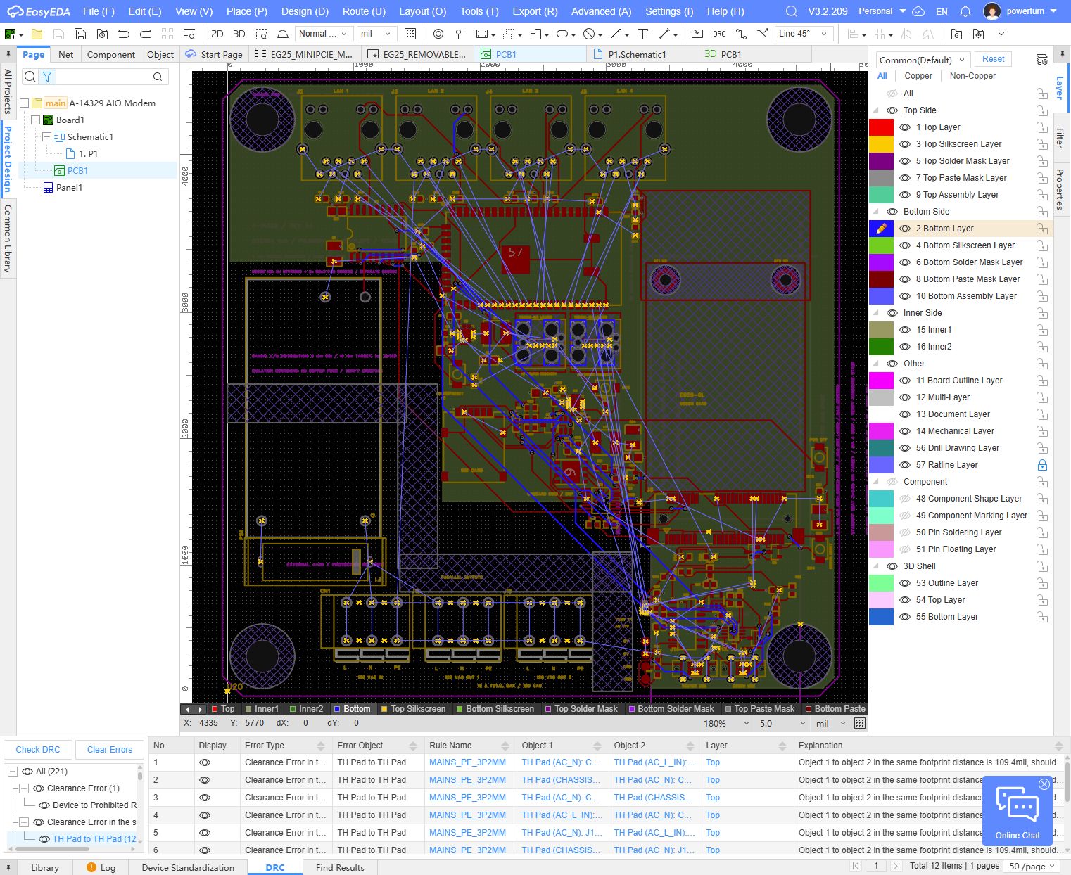
hardware/easyeda/routing-pass3-board.png
