samd-atlantis/A-14329-RG-Atlantis-Modem/hardware/easyeda/sj105219-p1.png

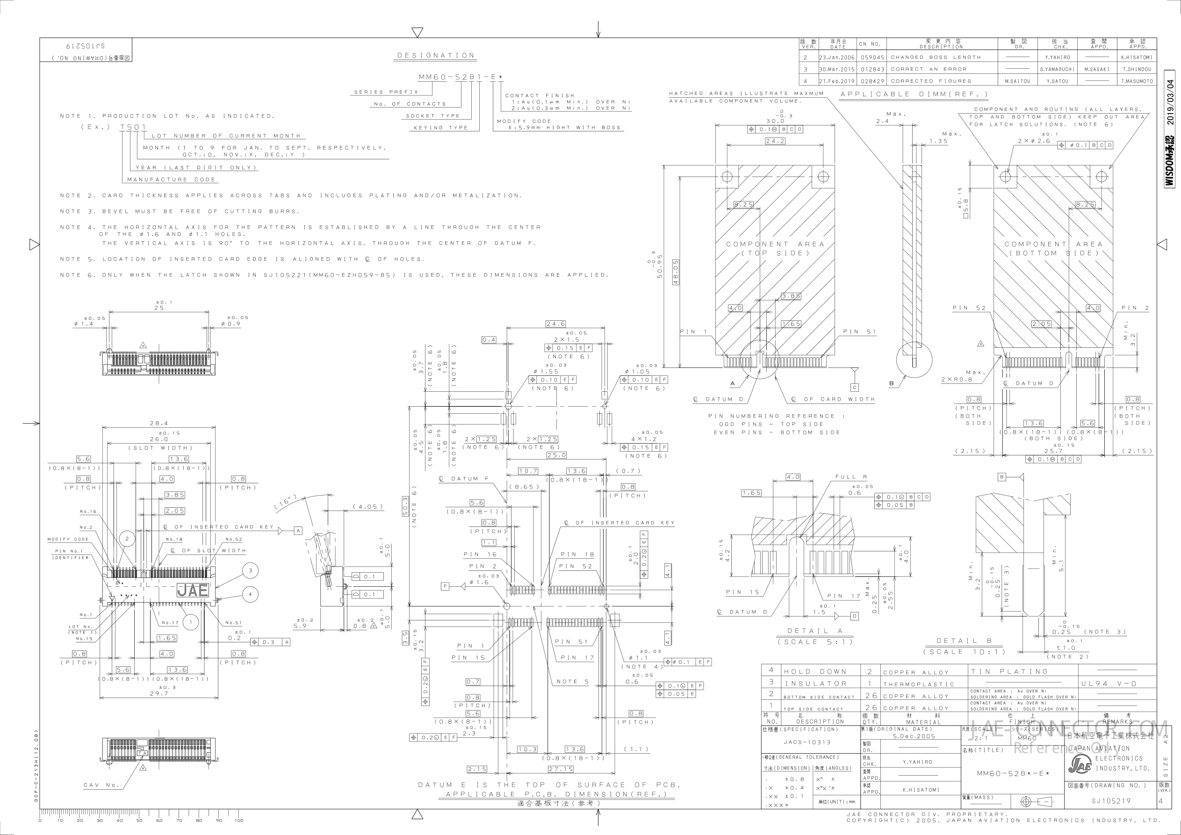
hardware/easyeda/sj105219-p1.png
