samd-atlantis/A-14329-RG-Atlantis-Modem/hardware/easyeda/tc2050-device-labels.png

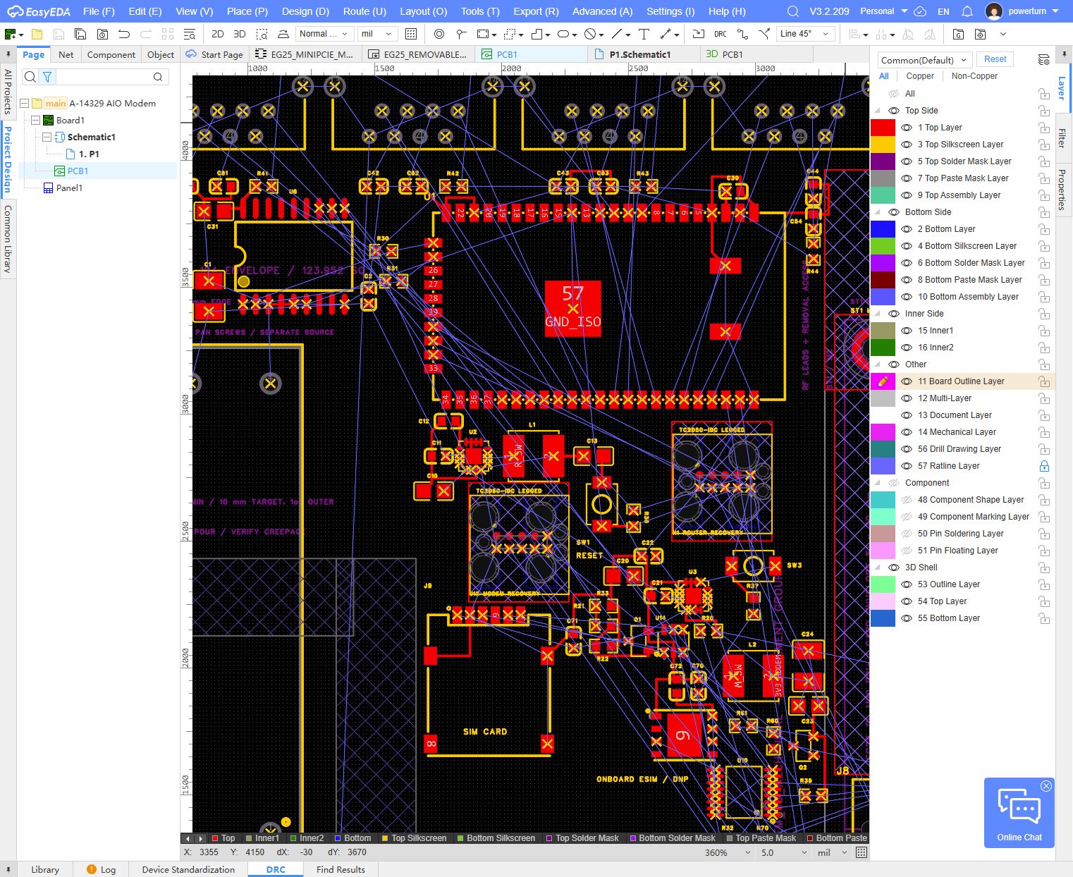
hardware/easyeda/tc2050-device-labels.png
