samd-atlantis/A-14329-RG-Atlantis-Modem/hardware/easyeda/tc2050-groups.png

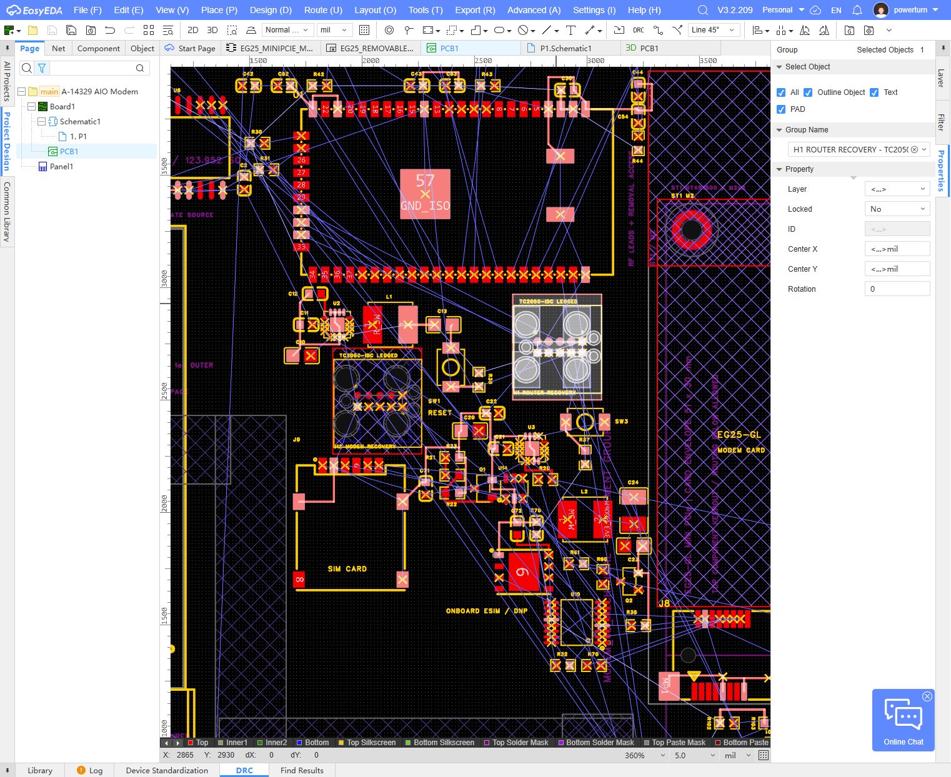
hardware/easyeda/tc2050-groups.png
