samd-atlantis/A-14329-RG-Atlantis-Modem/hardware/easyeda/usb-host-pair-placed.png

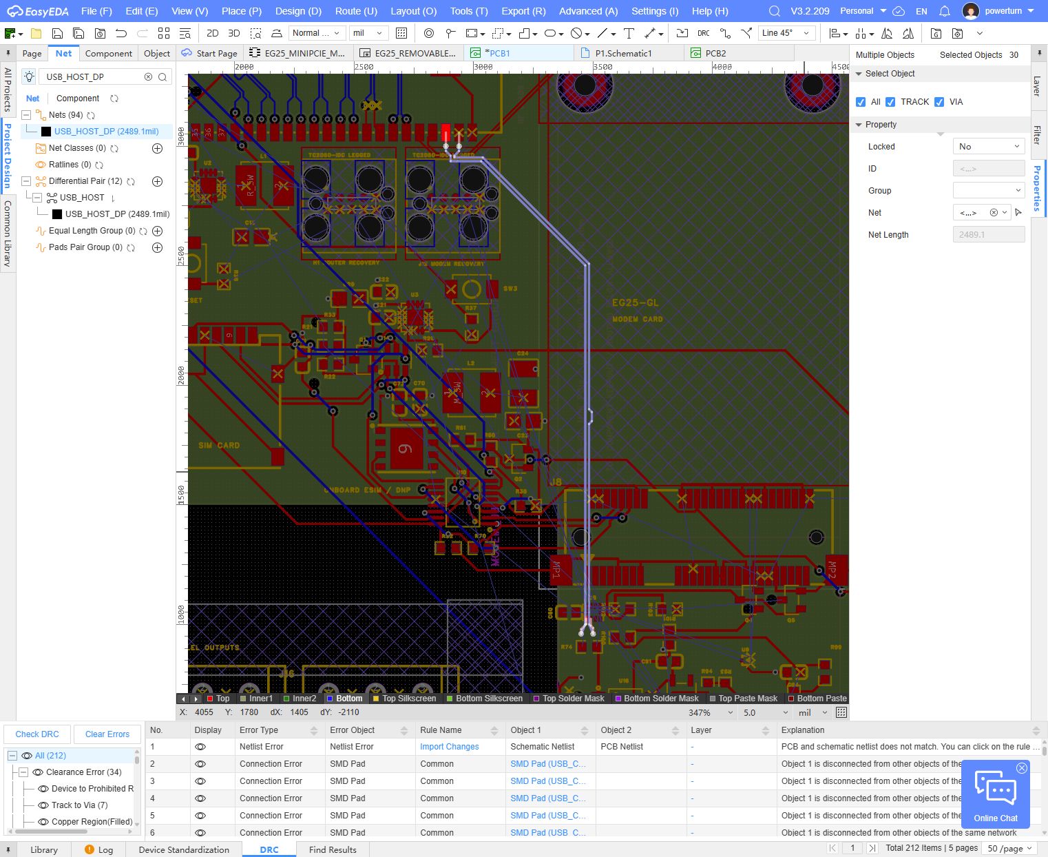
hardware/easyeda/usb-host-pair-placed.png
