samd-atlantis/A-14329-RG-Atlantis-Modem/hardware/easyeda/usb-modem-pair-placed.png

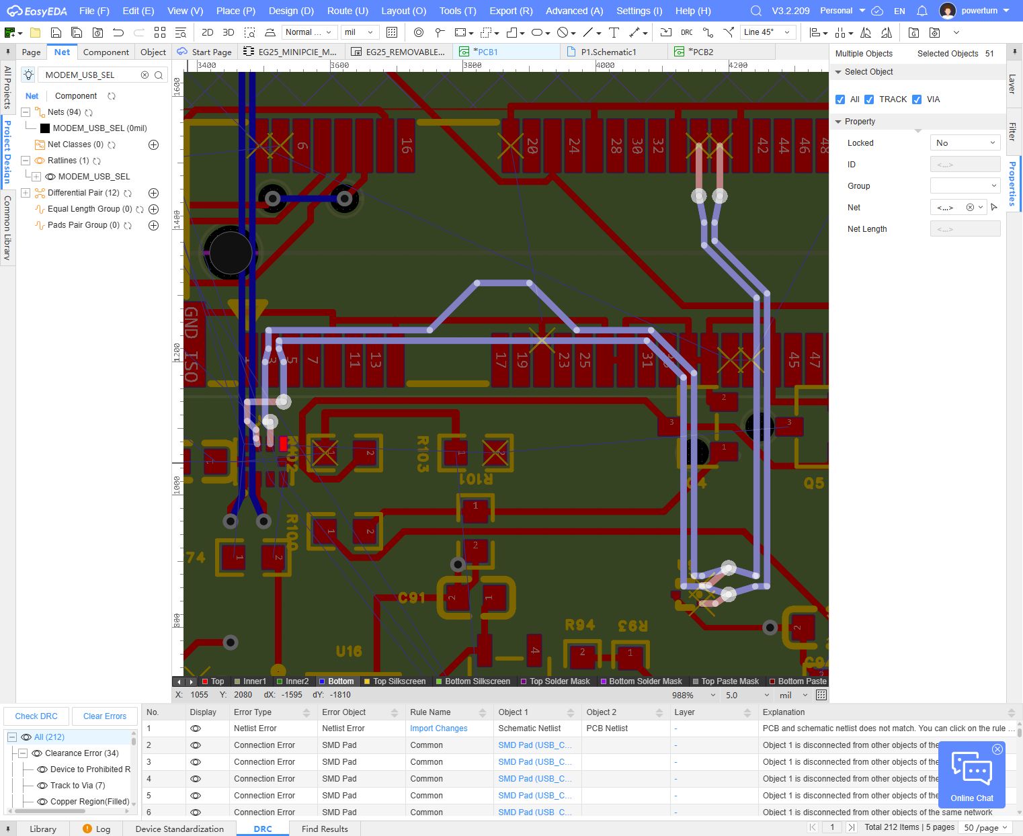
hardware/easyeda/usb-modem-pair-placed.png
