samd-atlantis/A-14329-RG-Atlantis-Modem/hardware/easyeda/usb-service-pair-placed.png

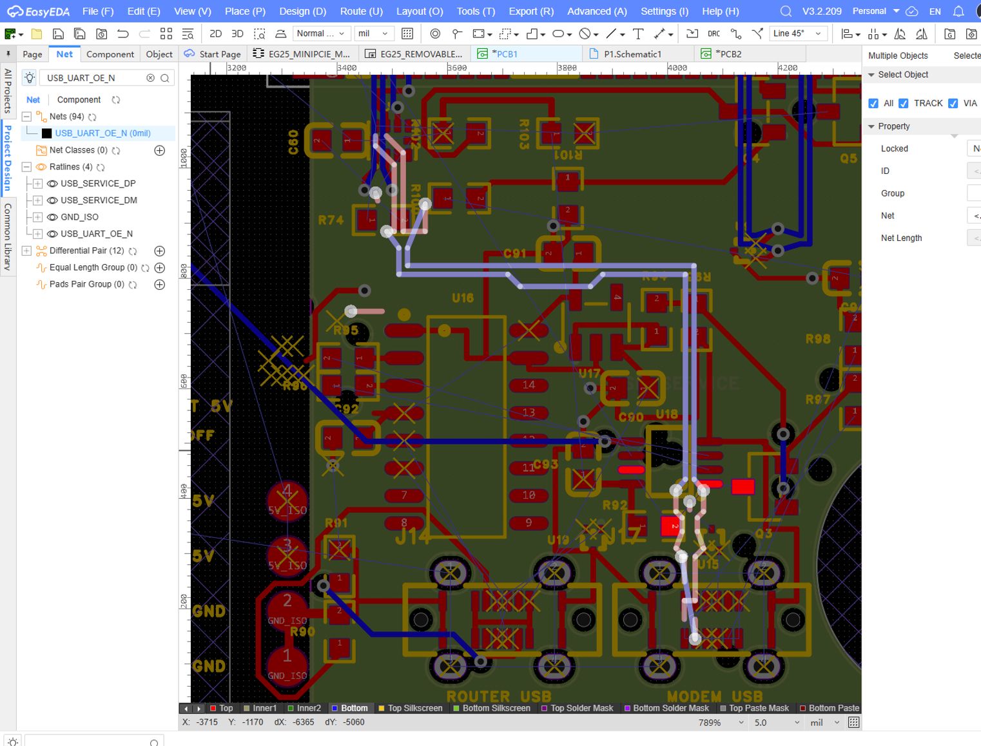
hardware/easyeda/usb-service-pair-placed.png
