samd-atlantis/A-14329-RG-Atlantis-Modem/hardware/enclosure/PCJ664NL-page1.png

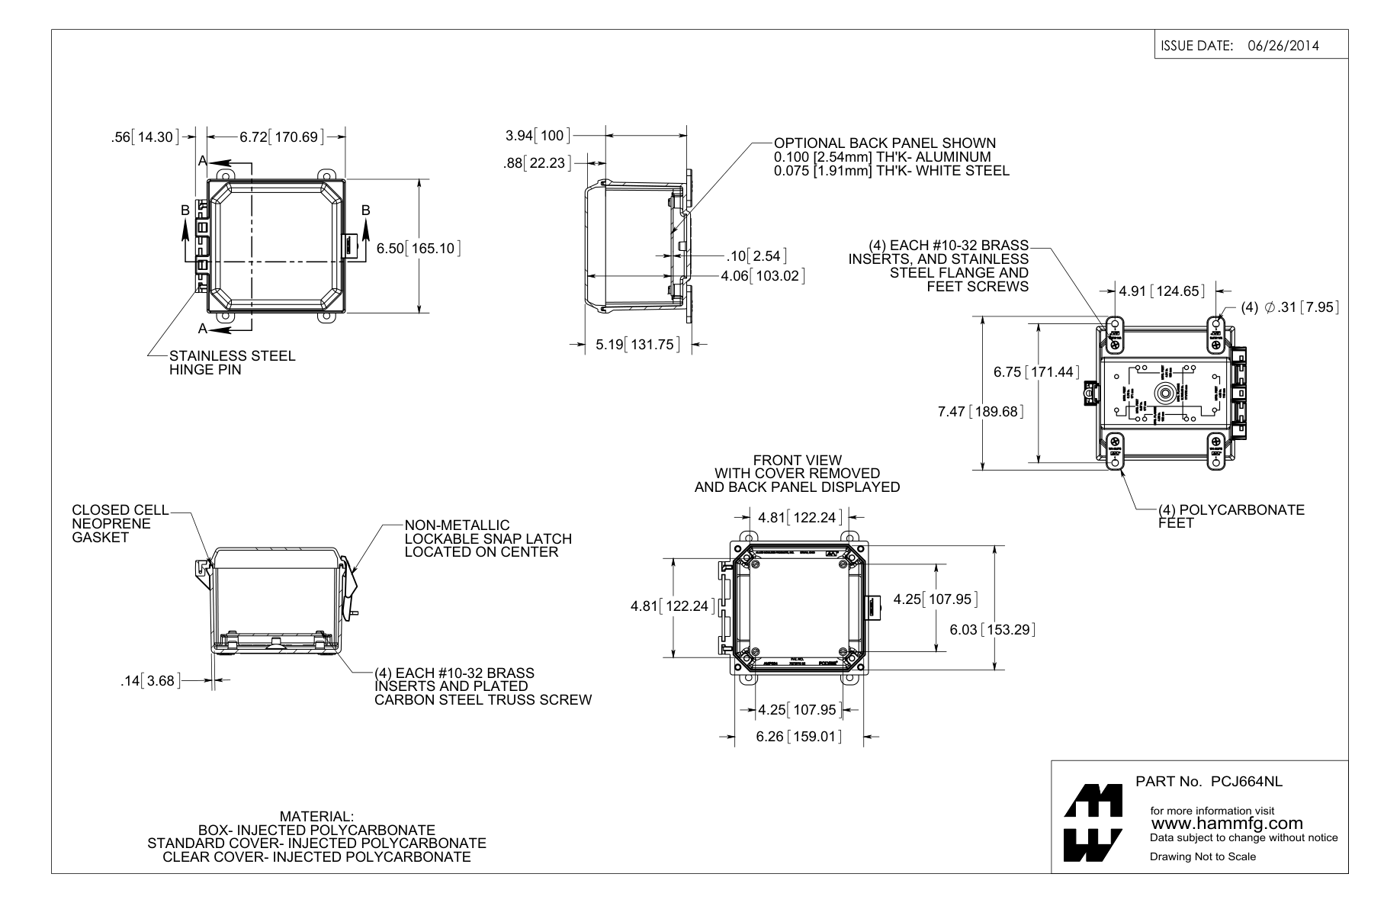
hardware/enclosure/PCJ664NL-page1.png
