samd-atlantis/A-14329-RG-Atlantis-Modem/hardware/enclosure/PCJR0505.png

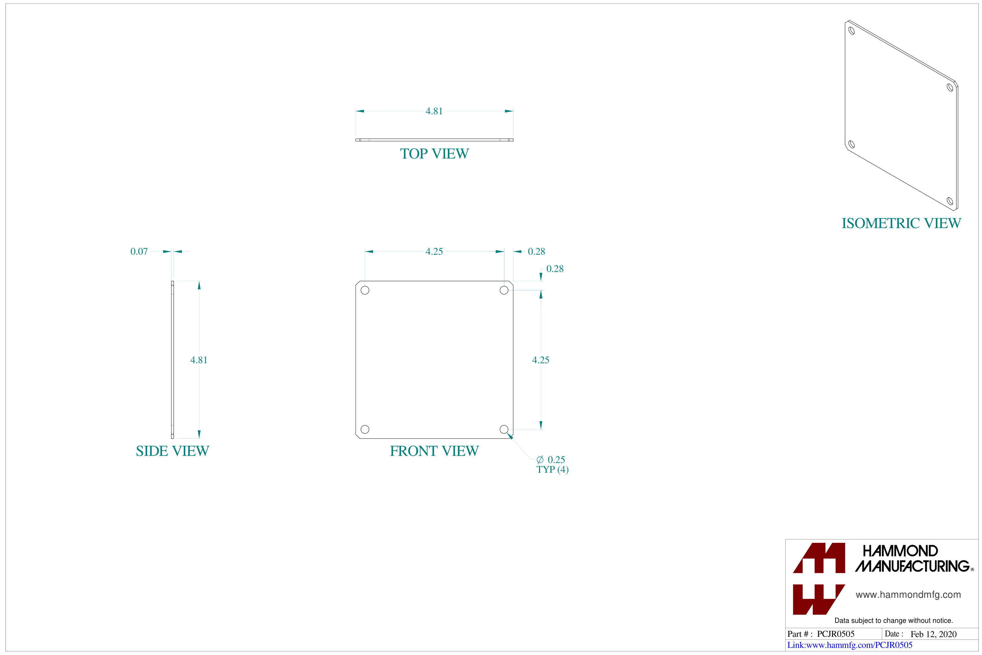
hardware/enclosure/PCJR0505.png
