samd-atlantis/A-14329-RG-Atlantis-Modem/hardware/releases/A-14329-MB00/drc-zero.png

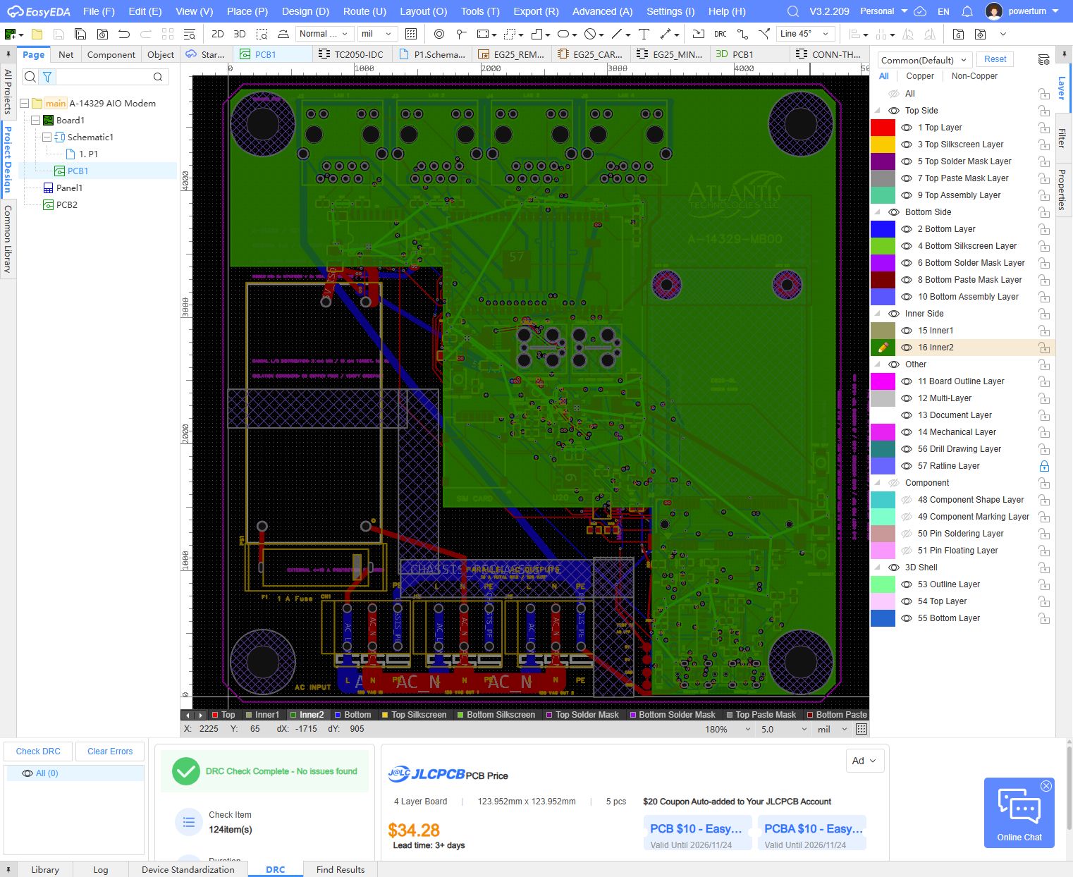
hardware/releases/A-14329-MB00/drc-zero.png
