samd-atlantis/A-14329-RG-Atlantis-Modem/hardware/rev-a/kicad/exports/walchem_gateway-01 - 120 VAC input and isolated 5 V supply.png

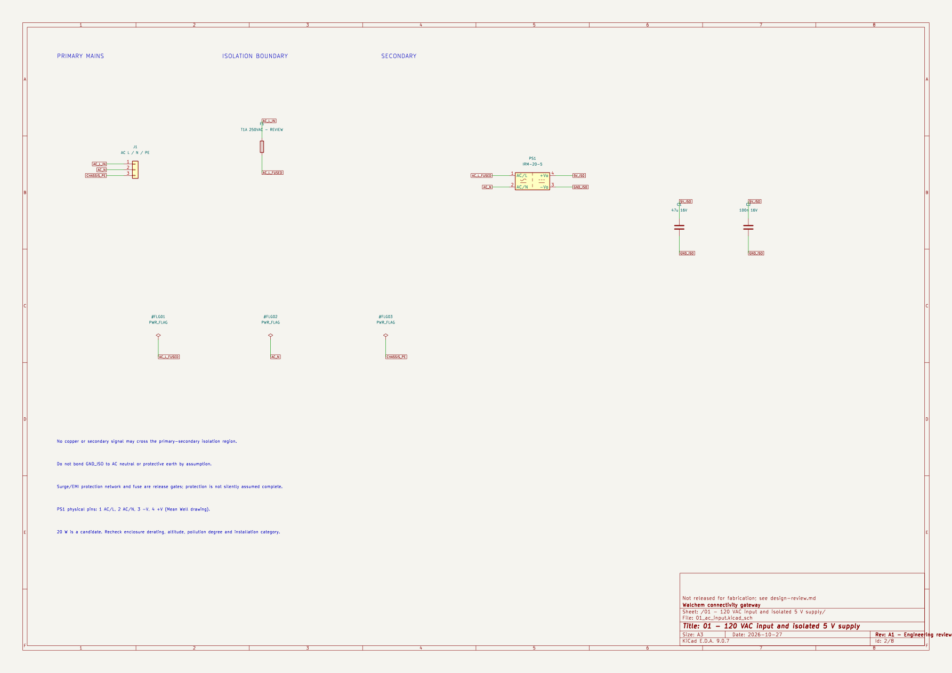
hardware/rev-a/kicad/exports/walchem_gateway-01 - 120 VAC input and isolated 5 V supply.png
