samd-atlantis/A-14329-RG-Atlantis-Modem/hardware/rev-a/kicad/exports/walchem_gateway-02 - Separate 3.3 V router and modem supplies.png

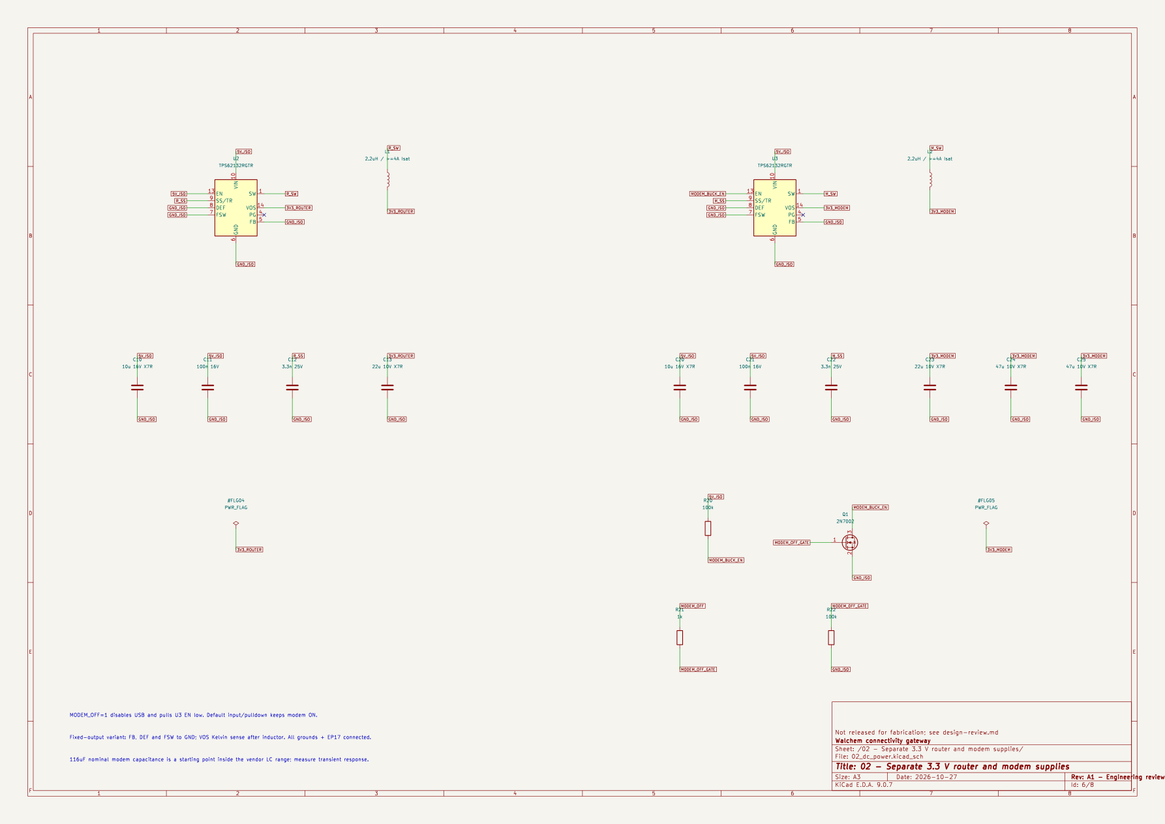
hardware/rev-a/kicad/exports/walchem_gateway-02 - Separate 3.3 V router and modem supplies.png
