samd-atlantis/A-14329-RG-Atlantis-Modem/hardware/rev-a/kicad/exports/walchem_gateway-03 - Router module and I2C management.png

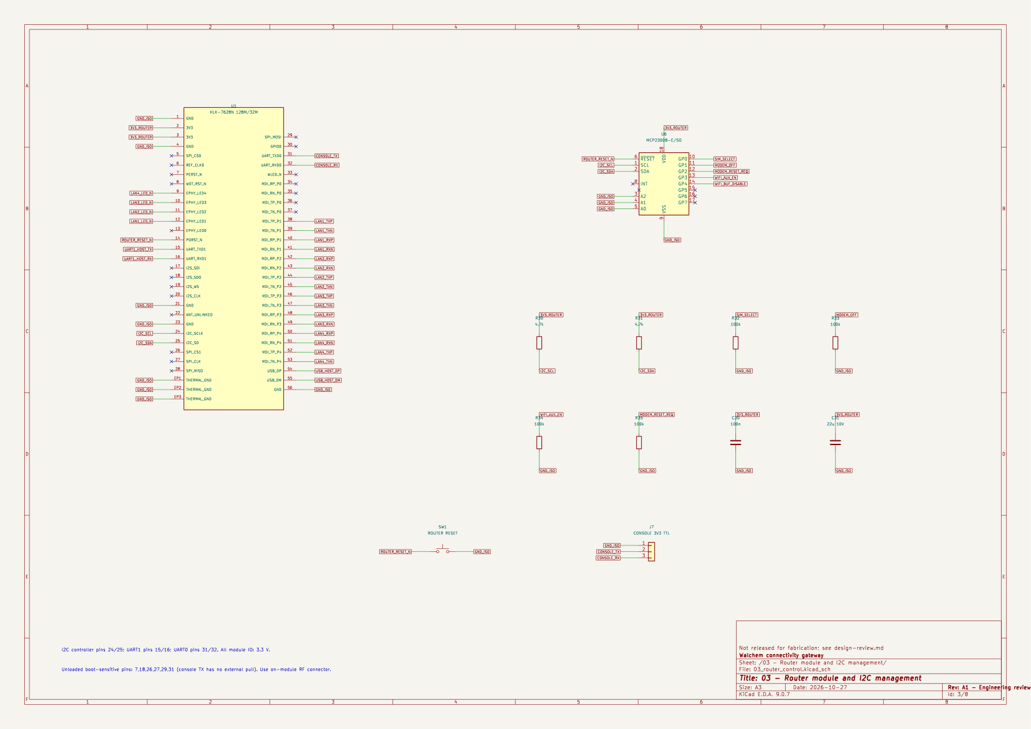
hardware/rev-a/kicad/exports/walchem_gateway-03 - Router module and I2C management.png
