samd-atlantis/A-14329-RG-Atlantis-Modem/hardware/rev-a/kicad/exports/walchem_gateway-04 - Four 10_100 LAN ports with integrated magnetics.png

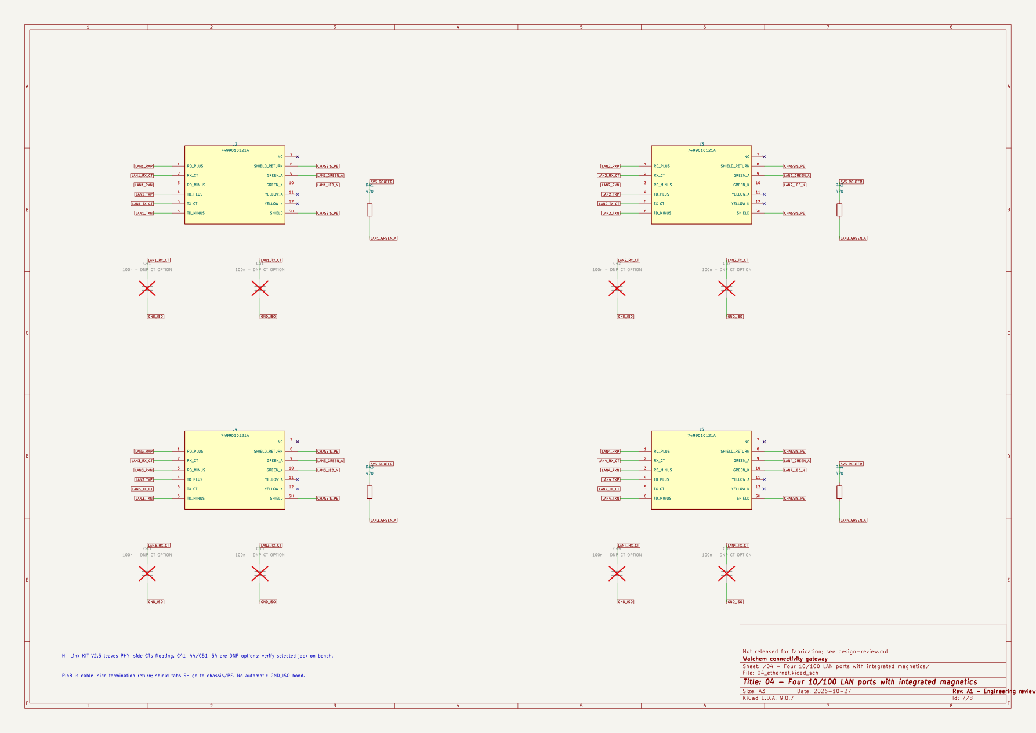
hardware/rev-a/kicad/exports/walchem_gateway-04 - Four 10_100 LAN ports with integrated magnetics.png
