samd-atlantis/A-14329-RG-Atlantis-Modem/hardware/rev-a/kicad/exports/walchem_gateway-05 - EG25-GL socket, USB isolation and reset.png

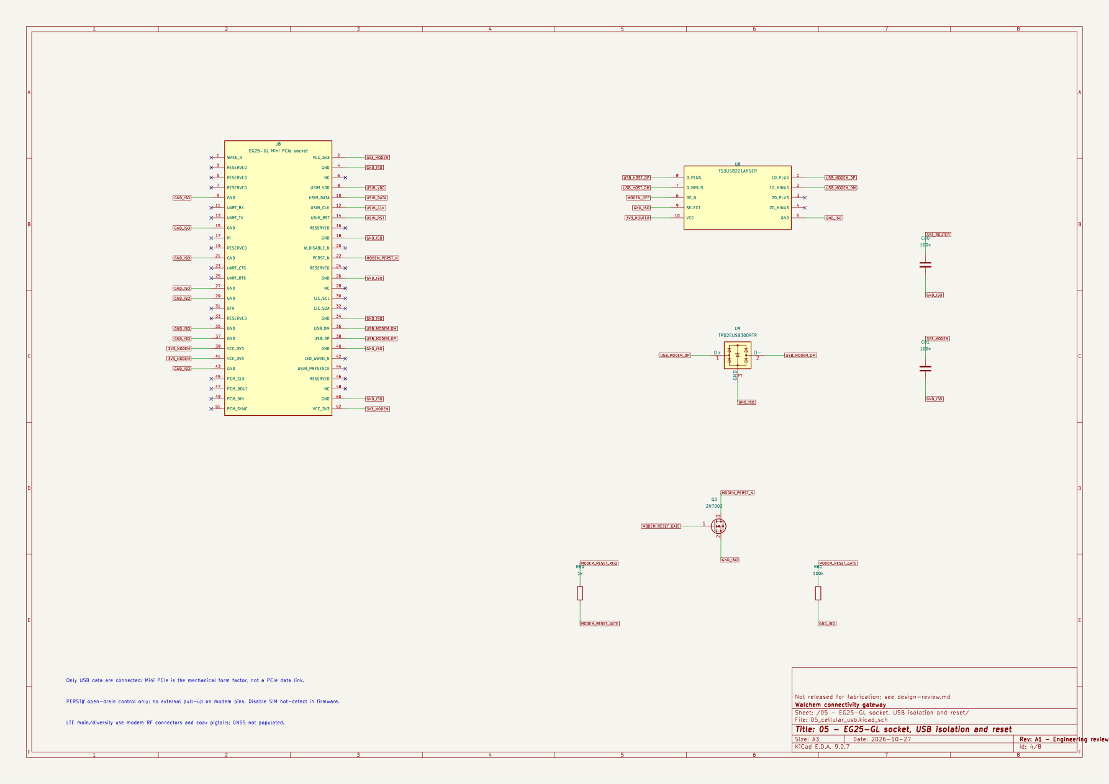
hardware/rev-a/kicad/exports/walchem_gateway-05 - EG25-GL socket, USB isolation and reset.png
