samd-atlantis/A-14329-RG-Atlantis-Modem/hardware/rev-a/kicad/exports/walchem_gateway-06 - Switched physical SIM and eUICC (one active).png

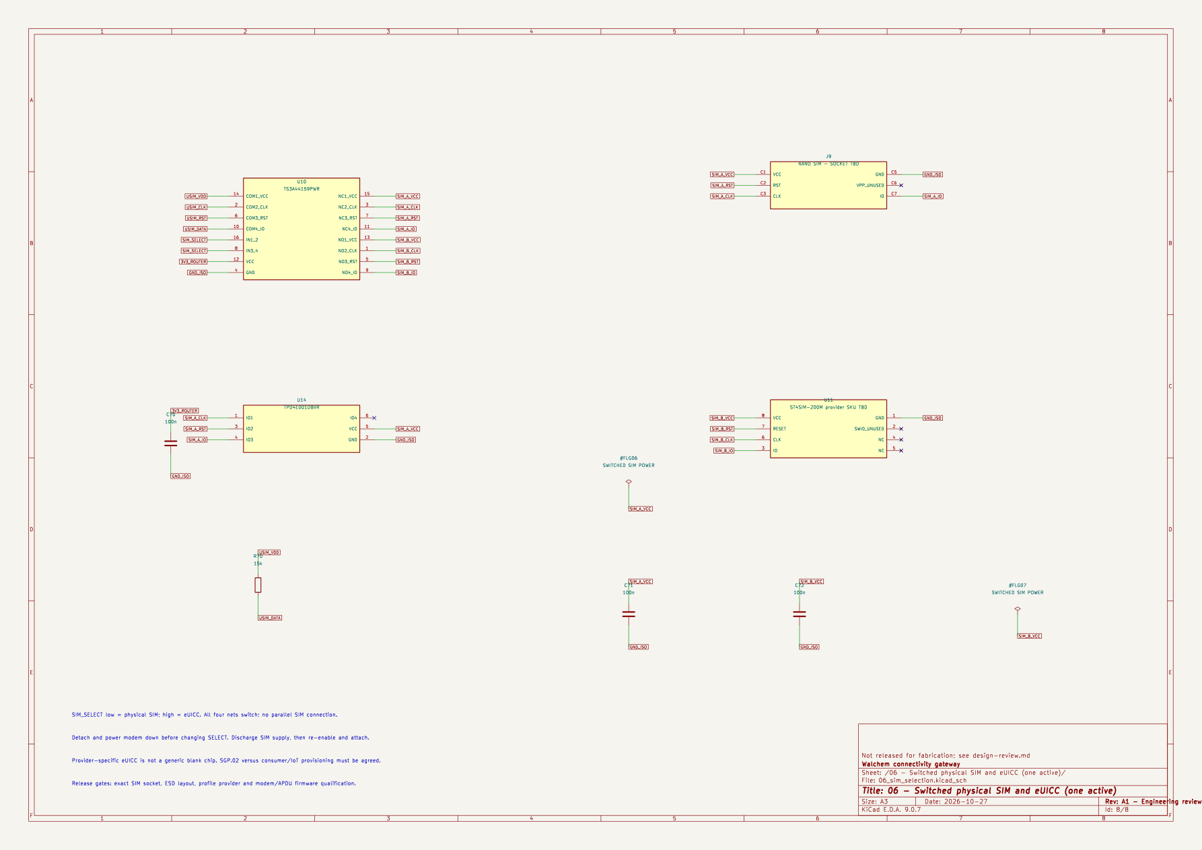
hardware/rev-a/kicad/exports/walchem_gateway-06 - Switched physical SIM and eUICC (one active).png
