samd-atlantis/A-14329-RG-Atlantis-Modem/hardware/rev-a/kicad/exports/walchem_gateway-07 - Ai-WB2-13 Wi-Fi_BLE and isolated UART.png

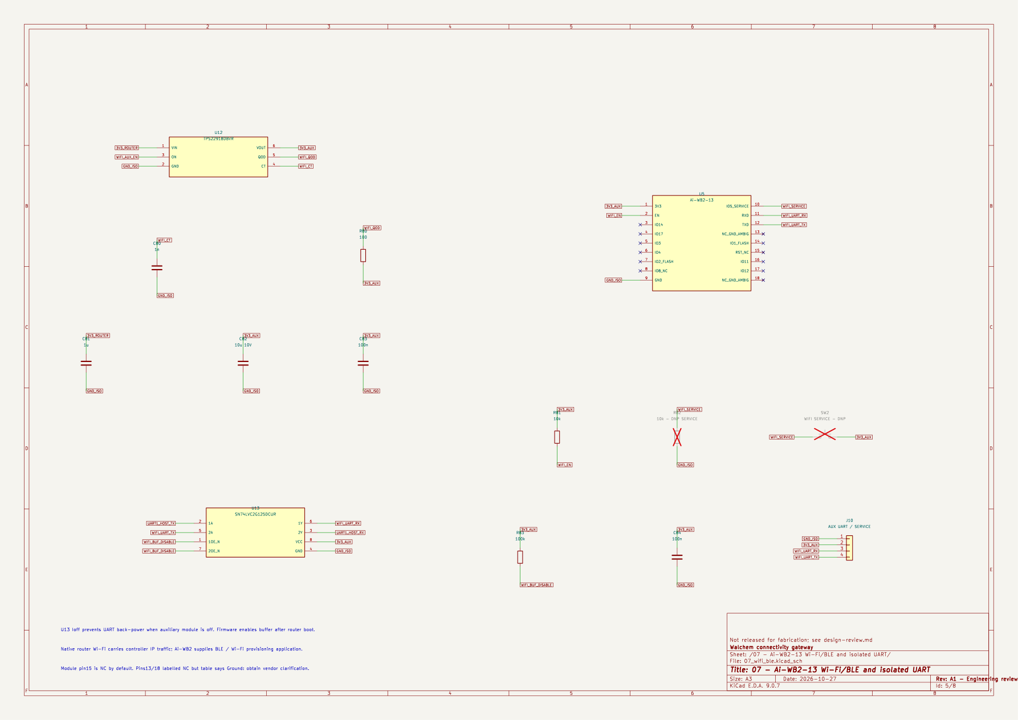
hardware/rev-a/kicad/exports/walchem_gateway-07 - Ai-WB2-13 Wi-Fi_BLE and isolated UART.png
