samd-atlantis/A-14329-RG-Atlantis-Modem/hardware/rev-a/kicad/exports/walchem_gateway.png

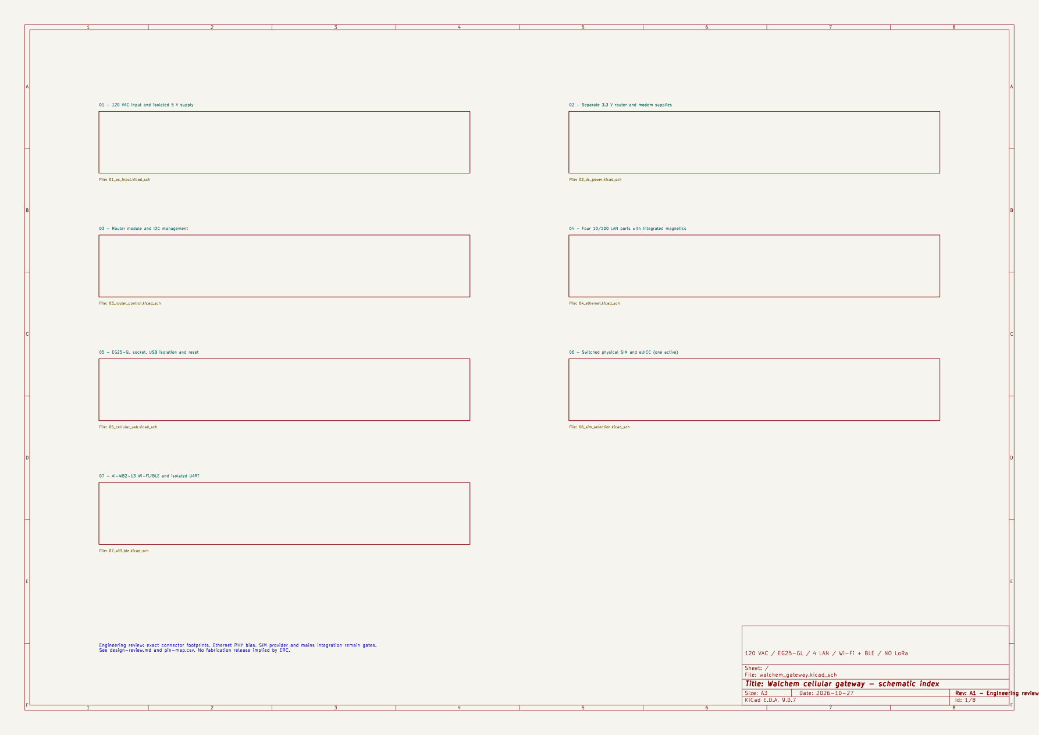
hardware/rev-a/kicad/exports/walchem_gateway.png
