samd-atlantis/A-14329-RG-Atlantis-Modem/hardware/rev-a/references/acdc-dimensions.png

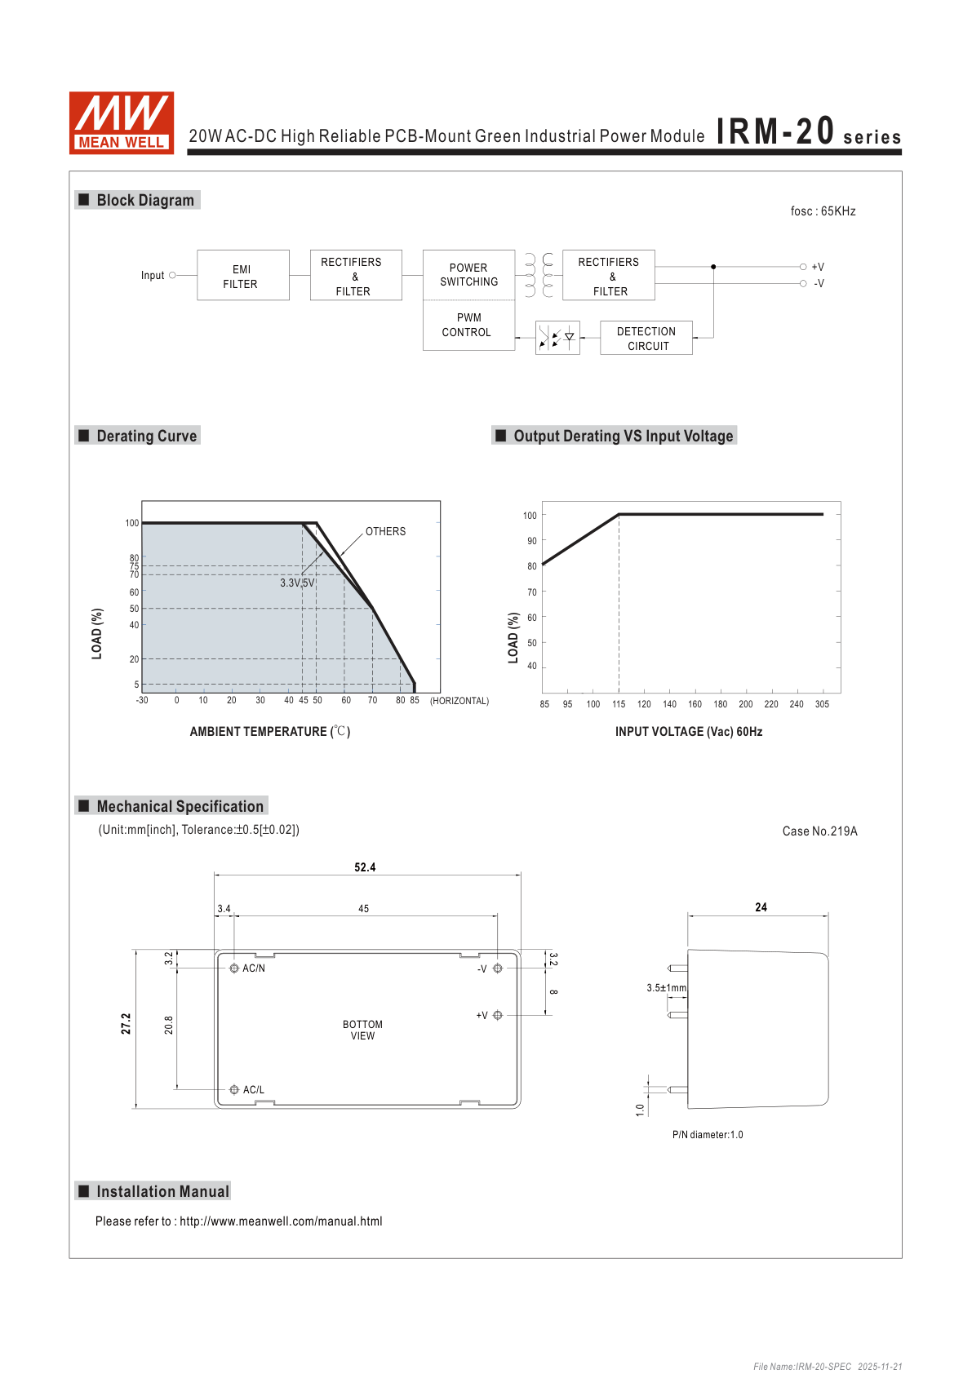
hardware/rev-a/references/acdc-dimensions.png
