samd-atlantis/A-14329-RG-Atlantis-Modem/hardware/rev-a/references/acdc-p2.png

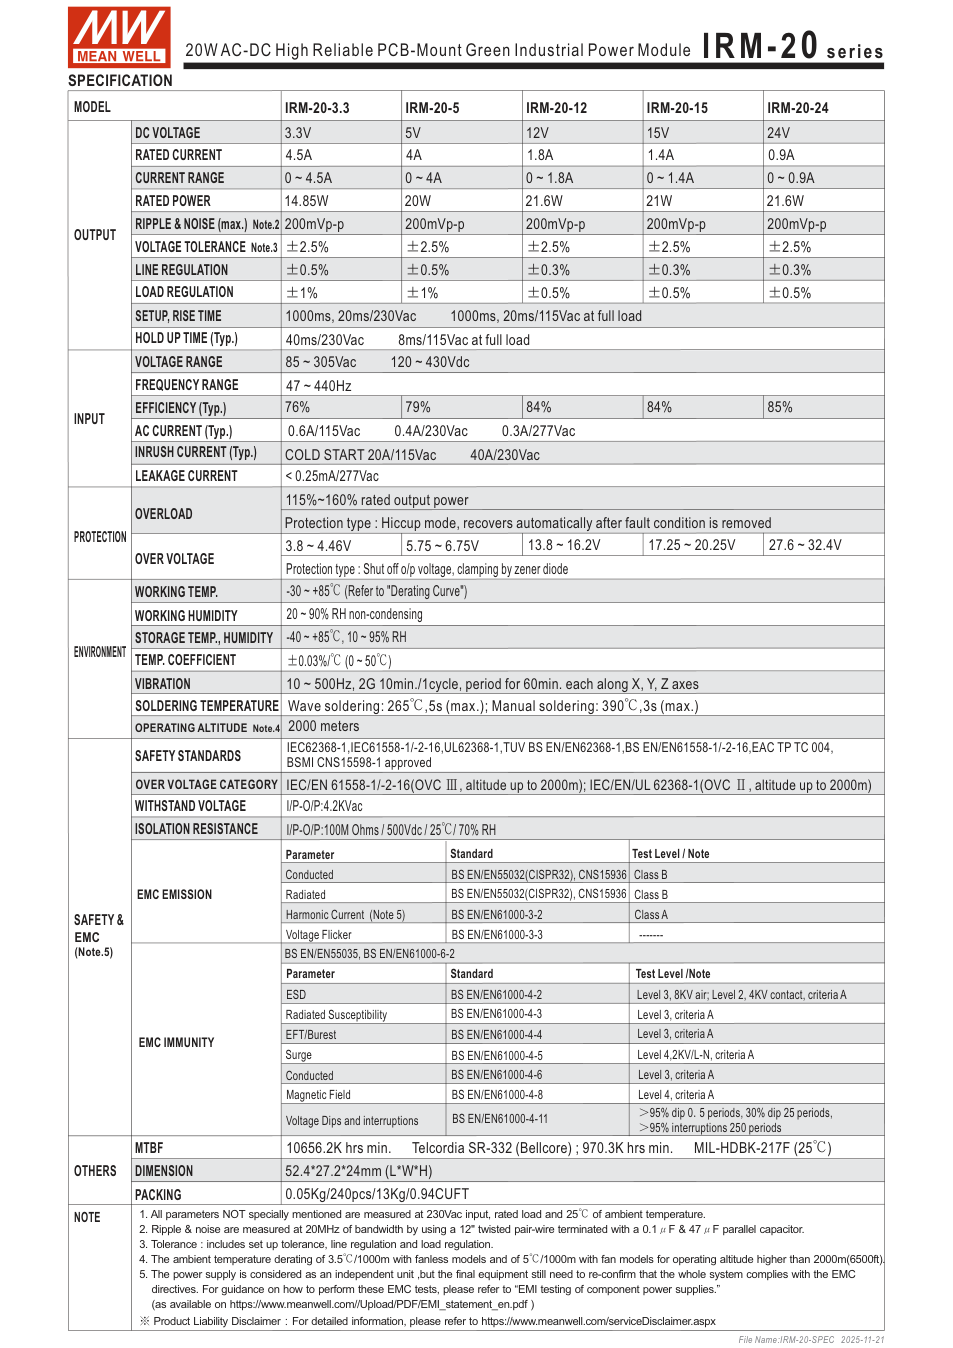
hardware/rev-a/references/acdc-p2.png
