samd-atlantis/A-14329-RG-Atlantis-Modem/hardware/rev-a/references/ai-dimensions.png

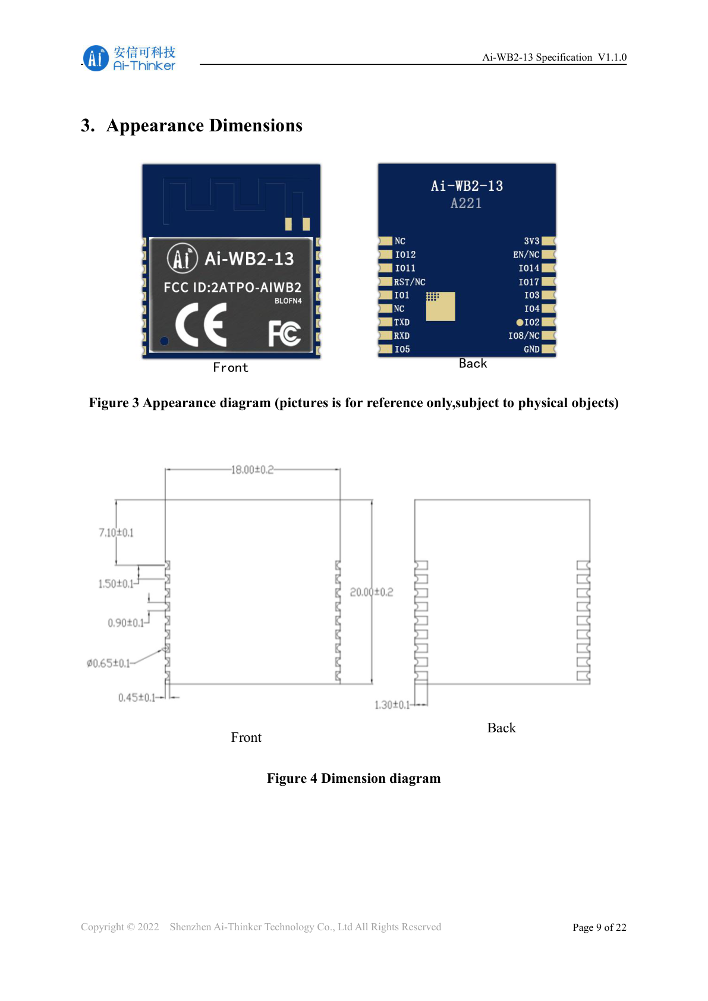
hardware/rev-a/references/ai-dimensions.png
