samd-atlantis/A-14329-RG-Atlantis-Modem/hardware/rev-a/references/ai-wb2-p16.png

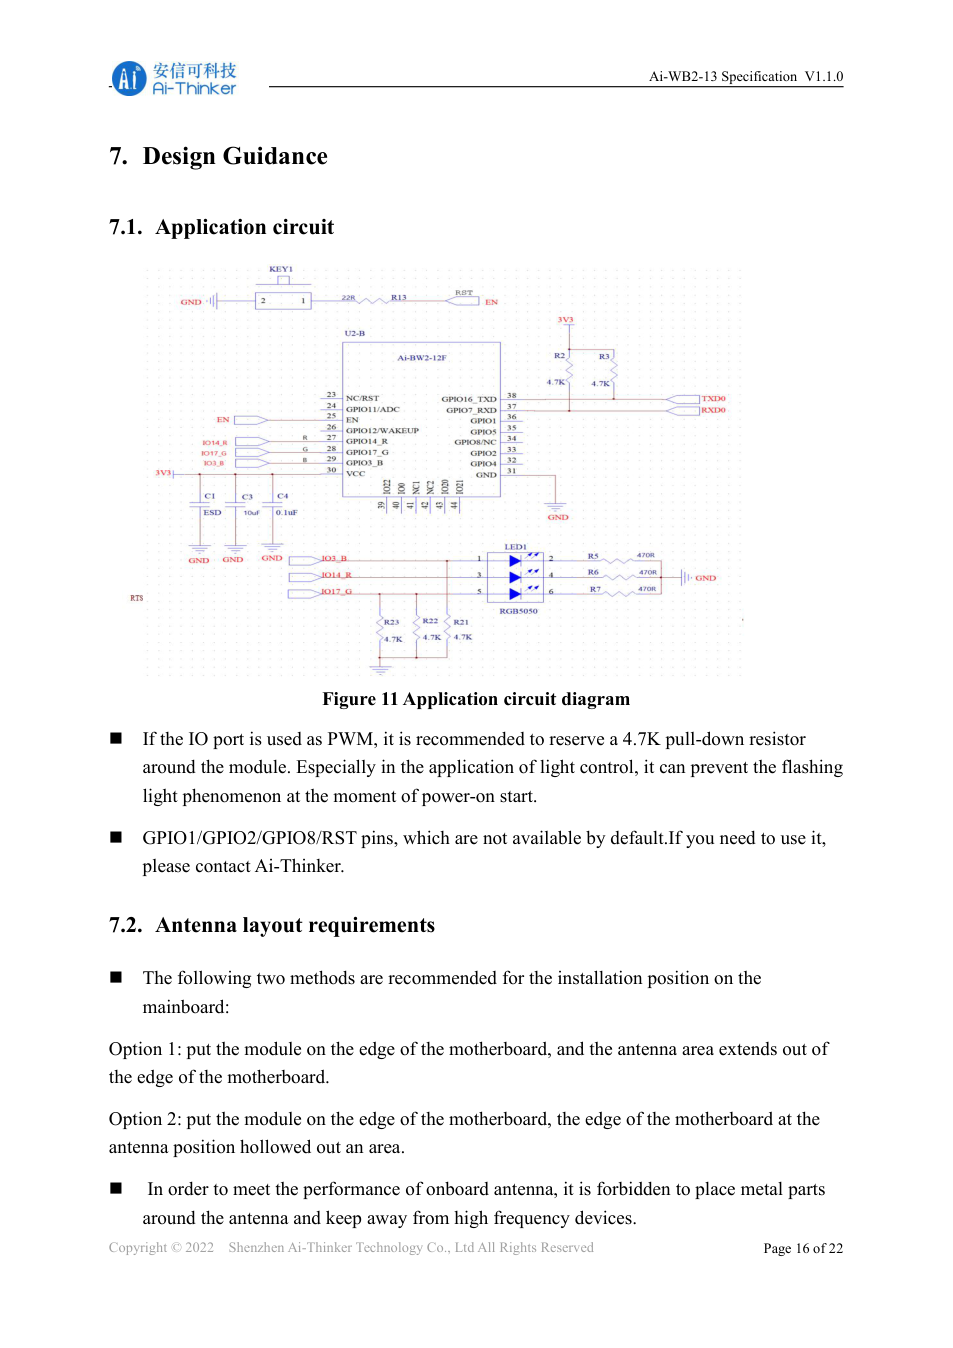
hardware/rev-a/references/ai-wb2-p16.png
