samd-atlantis/A-14329-RG-Atlantis-Modem/hardware/rev-a/references/hlk-p16.png

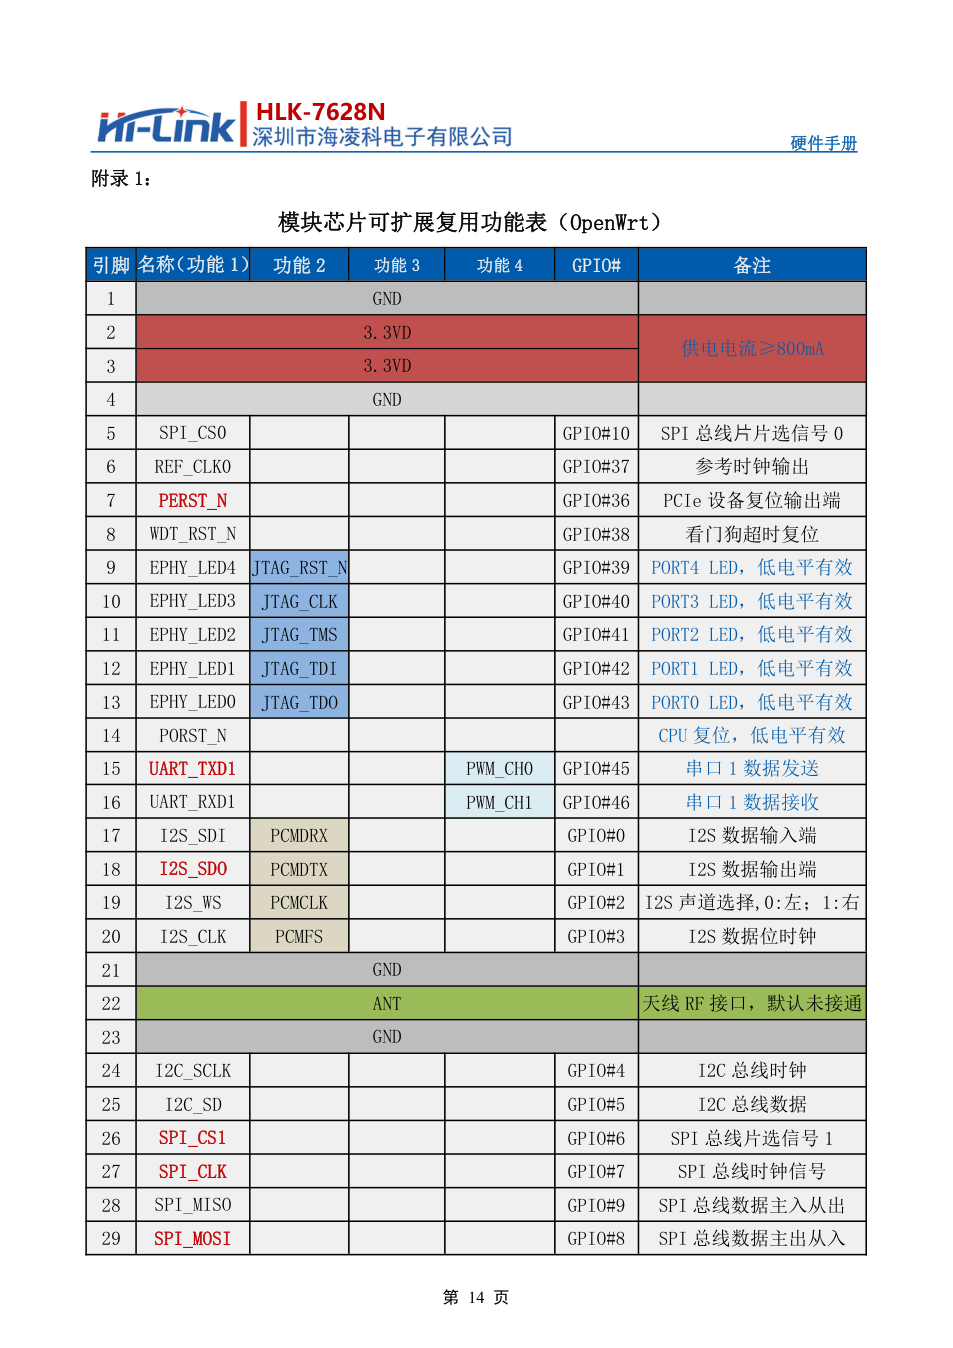
hardware/rev-a/references/hlk-p16.png
