samd-atlantis/A-14329-RG-Atlantis-Modem/hardware/easyeda/A14329_BOM_raw47.csv

No. | Quantity | Comment | Designator | Footprint | Value | Manufacturer Part | Manufacturer | Supplier Part | Supplier
1 | 3 | 47uF | C1,C24,C25 | C1210 | 47uF | GRM32ER61C476KE15L | muRata(村田) | C77101 | LCSC
2 | 11 | 100nF | C2,C11,C21,C30,C60,C61,C70,C71,C72,C92,C93 | C0603 | 100nF | CC0603KRX7R9BB104 | YAGEO(国巨) | C14663 | LCSC
3 | 2 | 10uF | C10,C20 | C0805 | 10uF | GRM21BR61C106KE15L | muRata(村田) | C77075 | LCSC
4 | 2 | 3.3nF | C12,C22 | C0603 | 3.3nF | 0603B332K500CT | Walsin(华新科) | C302028 | LCSC
5 | 3 | 22uF | C13,C23,C31 | C0805 | 22uF | GRM21BR61A226ME51L | muRata(村田) | C77074 | LCSC
6 | 3 | 1uF | C90,C91,C94 | C0603 | 1uF | CL10A105KB8NNNC | SAMSUNG(三星) | C15849 | LCSC
7 | 3 | 2604-1103 | CN1,J15,J16 | CONN-TH_2604-1103 |  | 2604-1103 | WAGO(万可) | C3309758 | LCSC
8 | 1 | 5x20 BLX-A型 保险丝支架 XC-7 | F1 | FUSE-TH_L22.6-W9.0 |  | 5x20 BLX-A型 保险丝支架 XC-7 | xcfuse(旭程) | C3131 | LCSC
9 | 4 | HR915310AE | J2,J3,J4,J5 | RJ45-TH_HR915310AE |  | HR915310AE | HANRUN(汉仁) | C19724785 | LCSC
10 | 1 | MM60-52B1-E1-R650 | J8 | PCIE-SMD_MM60-52B1-E1-R650 |  | MM60-52B1-E1-R650 | JAE(日本航空电子) | C4634556 | LCSC
11 | 1 | XKNANO-1306 | J9 | SIM-SMD_XKNANO-1306 |  | XKNANO-1306 | XKB Connection(中国星坤) | C381072 | LCSC
12 | 2 | FG-ST-C-16P-LS-SMTD-6.5 | J14,J17 | USB-TYPEC-SMD_FG-ST-C-16P-LS-SMTD-6.5 |  | FG-ST-C-16P-LS-SMTD-6.5 | FG(富港) | C51912230 | LCSC
13 | 2 | 2.2uH | L1,L2 | IND-SMD_L5.0-W5.0 | 2.2uH | SWPA5040S2R2NT | Sunlord(顺络) | C96923 | LCSC
14 | 1 | IRM-20-5 | PS1 | PWRM-TH_IRM-20-XX |  | IRM-20-5 | MW(明纬) | C6280121 | LCSC
15 | 5 | 2N7002 | Q1,Q2,Q3,Q4,Q5 | SOT-23-3_L2.9-W1.3-P1.90-LS2.4-BR |  | 2N7002 | CJ(江苏长电/长晶) | C8545 | LCSC
16 | 10 | 100kΩ | R20,R22,R32,R33,R35,R61,R74,R93,R99,R101 | R0603 | 100kΩ | 0603WAF1003T5E | UNI-ROYAL(厚声) | C25803 | LCSC
17 | 2 | 1kΩ | R21,R60 | R0603 | 1kΩ | 0603WAF1001T5E | UNI-ROYAL(厚声) | C21190 | LCSC
18 | 2 | 4.7kΩ | R30,R31 | R0603 | 4.7kΩ | 0603WAF4701T5E | UNI-ROYAL(厚声) | C23162 | LCSC
19 | 7 | 10kΩ | R36,R37,R92,R94,R100,R102,R103 | R0603 | 10kΩ | 0603WAF1002T5E | UNI-ROYAL(厚声) | C25804 | LCSC
20 | 6 | 470Ω | R41,R42,R43,R44,R95,R96 | R0603 | 470Ω | 0603WAF4700T5E | UNI-ROYAL(厚声) | C23179 | LCSC
21 | 1 | 15kΩ | R70 | R0603 | 15kΩ | 0603WAF1502T5E | UNI-ROYAL(厚声) | C22809 | LCSC
22 | 4 | 5.1kΩ | R90,R91,R97,R98 | R0603 | 5.1kΩ | 0603WAF5101T5E | UNI-ROYAL(厚声) | C23186 | LCSC
23 | 4 | TS-1088-AR02016 | SW1,SW3,SW4,SW5 | SW-SMD_L3.9-W3.0-P4.45 |  | TS-1088-AR02016 | XUNPU(讯普) | C720477 | LCSC
24 | 1 | HLK-7628N | U1 | WIRELM-SMD_HLK-7628N |  | HLK-7628N | HI-LINK(海凌科) | C209920 | LCSC
25 | 2 | TPS62132RGTR | U2,U3 | VQFN-16_L3.0-W3.0-P0.50-TL-EP |  | TPS62132RGTR | TI(德州仪器) | C81563 | LCSC
26 | 1 | MCP23008-E/SO | U6 | SOIC-18_L11.6-W7.5-P1.27-LS10.3-BL |  | MCP23008-E/SO | MICROCHIP(美国微芯) | C92253 | LCSC
27 | 1 | TS3USB221ARSER | U8 | UQFN-10_L2.0-W1.5-P0.50-BL |  | TS3USB221ARSER | TI(德州仪器) | C128396 | LCSC
28 | 3 | TPD2EUSB30DRTR | U9,U15,U19 | SOT-9X3-3_L1.0-W0.8-P0.35-LS1.0-BR |  | TPD2EUSB30DRTR | TI(德州仪器) | C97502 | LCSC
29 | 1 | TS3A44159PWR | U10 | TSSOP-16_L5.0-W4.4-P0.65-LS6.4-BL |  | TS3A44159PWR | TI(德州仪器) | C151886 | LCSC
30 | 1 | TPD4E001DBVR | U14 | SOT-23-6_L2.9-W1.6-P0.95-LS2.8-BL |  | TPD4E001DBVR | TI(德州仪器) | C465736 | LCSC
31 | 1 | CH340C | U16 | SOP-16_L10.0-W3.9-P1.27-LS6.0-BL |  | CH340C | WCH(南京沁恒) | C84681 | LCSC
32 | 1 | ME6211C33M5G-N | U17 | SOT-23-5_L3.0-W1.7-P0.95-LS2.8-BL |  | ME6211C33M5G-N | MICRONE(南京微盟) | C82942 | LCSC
33 | 1 | SN74LVC2G125DCTR | U18 | SM8_L3.2-W2.9-P0.65-LS4.3-BR |  | SN74LVC2G125DCTR | TI(德州仪器) | C206035 | LCSC
