samd-atlantis/A-14329-RG-Atlantis-Modem/hardware/easyeda/small-component-tidy-board-3d.png

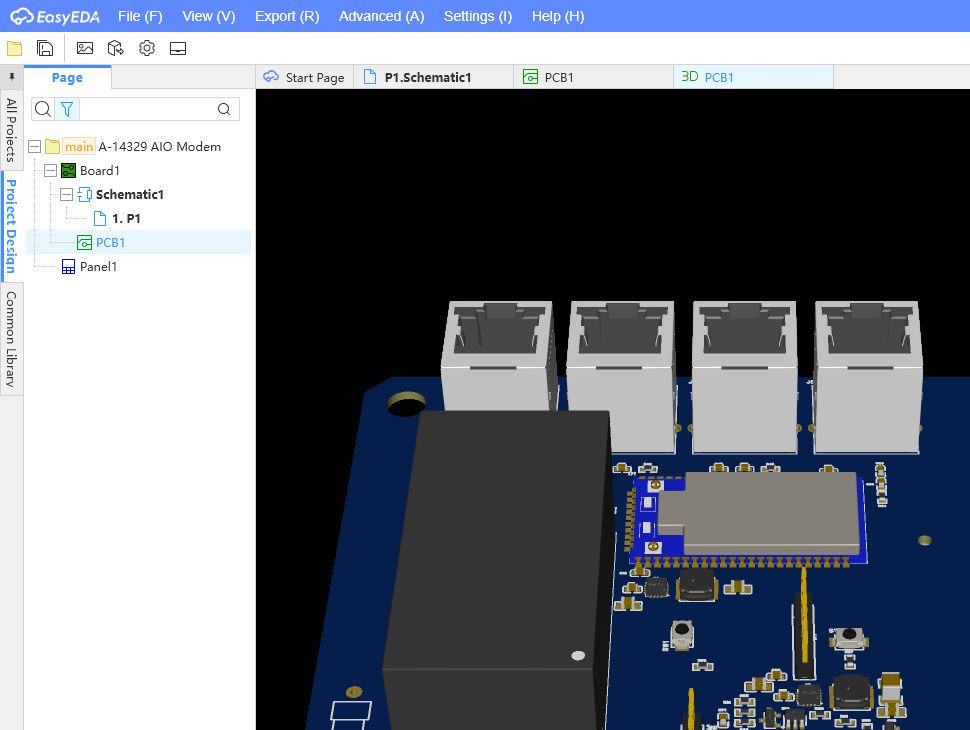
hardware/easyeda/small-component-tidy-board-3d.png
