samd-atlantis/A-14329-RG-Atlantis-Modem/hardware/easyeda/small-component-tidy-proof.png

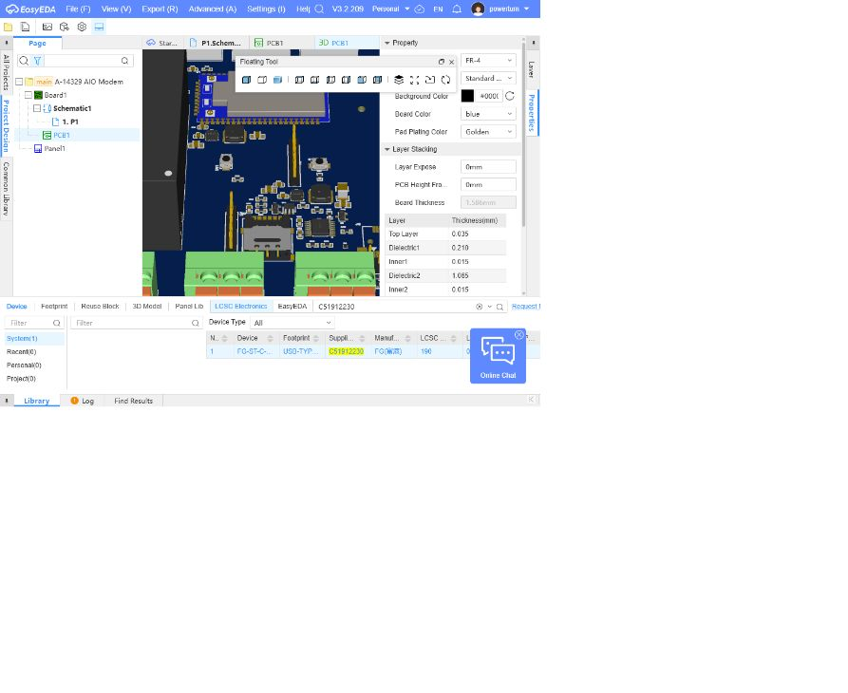
hardware/easyeda/small-component-tidy-proof.png
