samd-atlantis/A-14329-RG-Atlantis-Modem/hardware/easyeda/EG25_NT4_assembly.obj

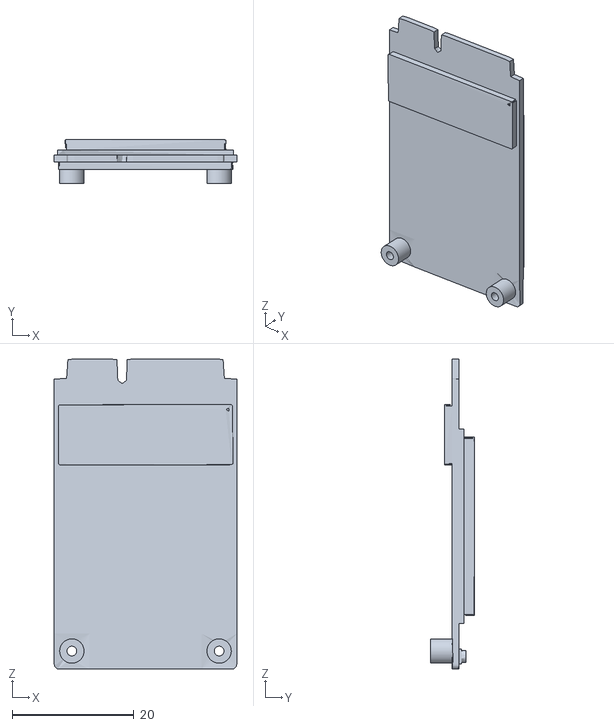
[picture p74: CAD file, 2026-10-29]
hardware/easyeda/EG25_NT4_assembly.obj
30.0 x 7.20 x 51.0
