samd-atlantis/A-14329-RG-Atlantis-Modem/hardware/easyeda/mesh-check46/modem-height-check46.obj

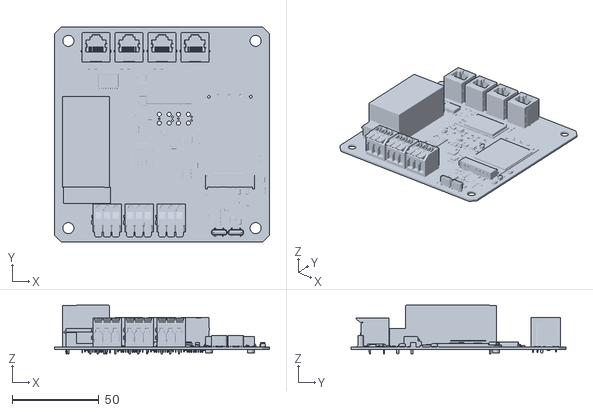
[picture p75: CAD file, 2026-10-29]
hardware/easyeda/mesh-check46/modem-height-check46.obj
123.9 x 123.9 x 28.1
