samd-atlantis/A-14329-RG-Atlantis-Modem/(list of files, cad)

Other CAD files:
hardware/easyeda/mesh-datum45/modem-height-datum-before45.obj
