samd-atlantis/A-14329-RG-Atlantis-Modem/firmware/preview/wifi-setup.png

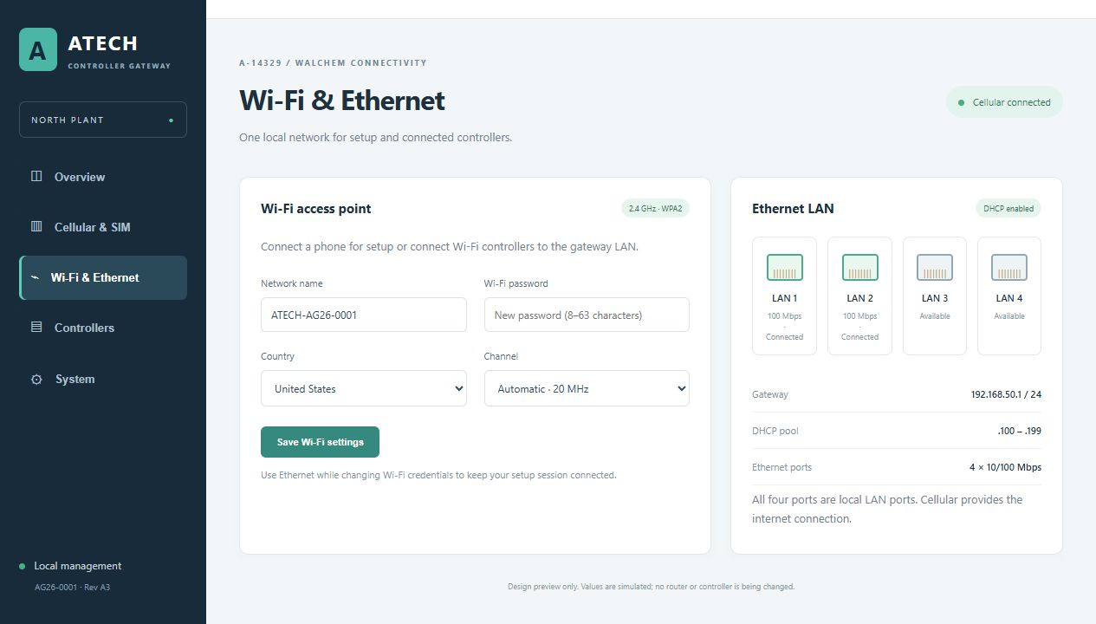
firmware/preview/wifi-setup.png
