samd-atlantis/A-14329-RG-Atlantis-Modem/hardware/easyeda/C3131-manufacturer-p2.png

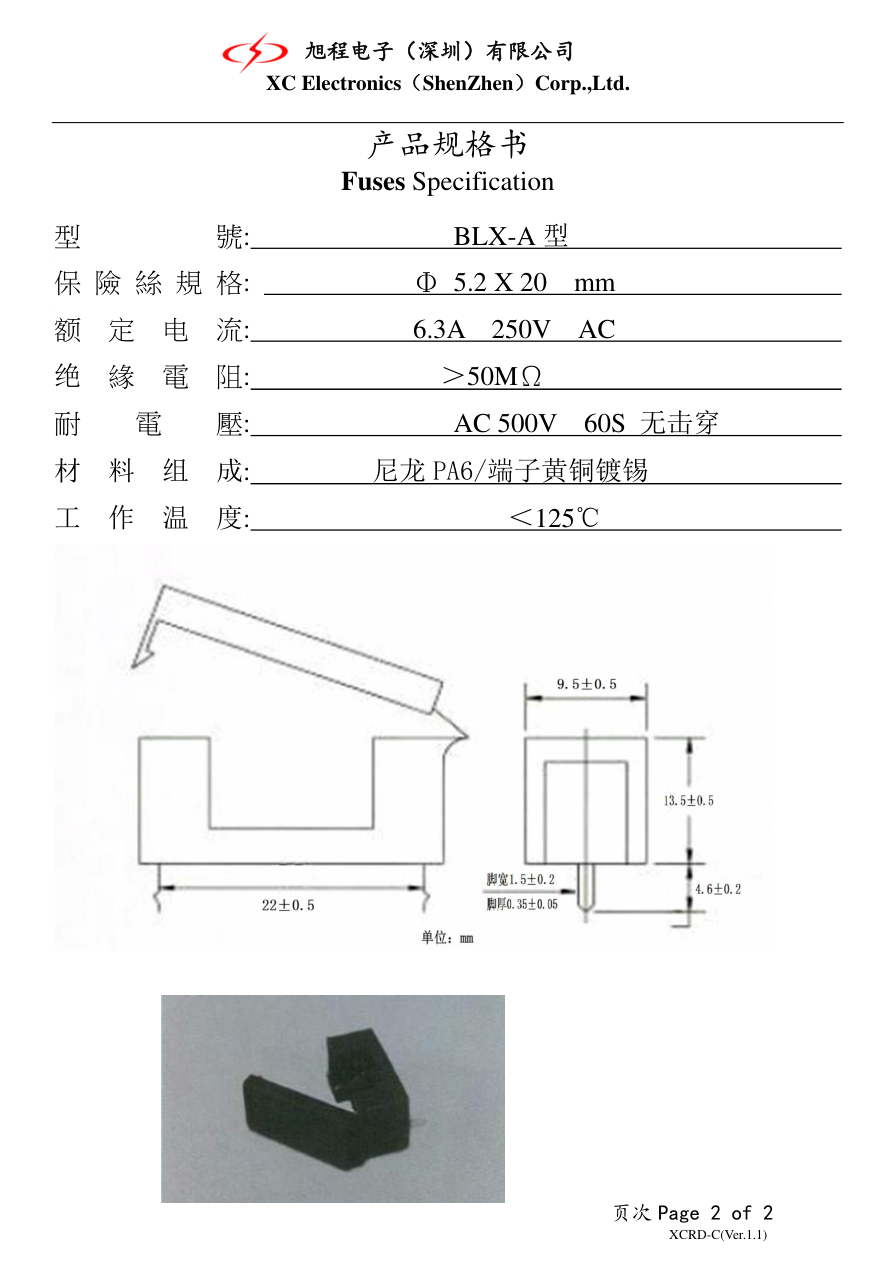
hardware/easyeda/C3131-manufacturer-p2.png
