samd-atlantis/A-14329-RG-Atlantis-Modem/firmware/VALIDATION-MB00.txt

A-14329-MB00 validation record - 2026-10-29

2026-10-30 CURRENT CANDIDATE r10 - OFFLINE VALIDATION PASSED
Cross-build 41067820915 from 8a2519687a32ab4e683d93b74662811606761bbf completed
successfully at 15:19 UTC; compiled-image run 41079703855 passed at 15:20 UTC.
https://github.com/samd-atlantis/A-14329-RG-Atlantis-Modem/actions/runs/41067820915
https://github.com/samd-atlantis/A-14329-RG-Atlantis-Modem/actions/runs/41079703855
Independent local inspect_image.py and inspect_rootfs.py also passed, with zero
failures/warnings, against package files from that exact build revision. Both
binary hashes/sizes match the manifest and SHA256SUMS; unit_record_schema is
atlantis-mac4-v1. The actual rootfs has 170 packages, 79 modules and all 13 custom
files byte-matched, including the supplied logo and remote-support marker.
Actual DTB enables USB/PHY/Ethernet/Wi-Fi/I2C with expected carrier pin/partition
settings. QMI/USB serial, Wi-Fi, I2C and WireGuard drivers/autoload/services are
present; remote access and hardware/eSIM control gates remain disabled.
The packaged first-boot file has the requested LAN .7/23, DHCP .150-.199,
HTTP controller .101-.104, permanent-MAC SSID/BSSID and fail-closed checks.
This is static content/source verification, not execution on the carrier.
Host/source revision eda260259e2accfde74e52ebce115c6b9f70f549 passed all 104 Python
and 33 JS checks on Linux; its published portal passed all 14 proxy fixture tests.
https://github.com/samd-atlantis/A-14329-RG-Atlantis-Modem/actions/runs/41076974981
https://github.com/samd-atlantis/A-14329-RG-Atlantis-Modem/actions/runs/41076974751
Compact independent evidence: validation/2026-10-30-8a25196/. Prior r7 evidence
is preserved unchanged. HANDOFF-MB00.txt now gives the r10 downloads/hashes and
permanent-serial programming/label procedure. Entries below are development history;
older pending-build statements and r7 image hashes do not identify today's image.
No actual router was programmed, production ID issued, physical print sent, or
SAP/Telnyx/DNS/server change made. Portal/server feature work stays paused and
its unfinished local edits remain uncommitted. The permanent public URL is selected
but NOT LIVE. hardware_tested, programming_authorization and production_approved
remain false. Modem power/capacitor disposition, actual memory/bootloader, own
backups/recovery, physical label/login and all first-board functions still require
hardware acceptance. This completes the authorized offline firmware candidate.

2026-10-30 PERMANENT ADDRESS: user selected https://connect.atlantisllc.com.
Commissioning assigns /u/<serial>, records that exact URL immutably, and renders
it as readable text and a QR on the public enclosure label. The private setup
label also shows the remote address and distinguishes LOCAL LOGIN. DNS/HTTPS
hosting and live remote access have not been deployed; portal/server work remains
paused. This is an address/label preparation change, not a working remote service.
All 15 focused commissioning/label tests and three CellModemInput adapter tests
passed, including actual decode of the default permanent-address QR and explicit
selection of the public label through a mocked printer. No actual print job ran.

2026-10-30 HOST COMMISSIONING: permanent serial allocation/import, private unit
records and captured post-boot identity checks are implemented in tools/commission.py.
The source also matches the supplied ESP Rev 2 setup-label/Label 1 print workflow
and the CellModemInput 260924 serial/IMEI/LAN-MAC positional QR parser. Actual QR
images were decoded in tests, including rotated setup labels. Physical printing,
application scanner entry, router boot/login, flash/recovery and cellular tests
are not claimed. No SAP/API call, actual print job or production ID allocation
was performed. See commissioning/README.txt for exact procedure and provenance.
The full local firmware suite passed 101 Python tests plus 33 JavaScript checks;
the added imported-number regression also passed in the focused 9-test
commissioning suite. The resulting full source suite contains 102 Python tests.
These are host-only changes; firmware/package and build.sh still match the r10
candidate source below. Do not restart its running cross-build for these tools.
Portal/server feature development is paused at the user's request. Its unfinished
local edits are preserved separately and are not part of this commissioning work.

2026-10-30 CURRENT DEVELOPMENT: package 0.1.0-r10 adds kmod-wireguard,
wireguard-tools and luci-proto-wireguard, disabled remote defaults, a remote
feature marker and remote-aware controller bookmarks. All r9 LAN/SSID and
Atlantis branding changes are retained. The local portal prototype is in
../portal/README.md; hosting is deferred by the user. Staged per-unit configs
restrict gateway HTTPS and four controller mappings to the authenticated hub.
No actual router/server/public access was enabled. The r9 build below is
superseded to include this requested feature; a new cross-build is required.
Local checks passed 85 firmware Python tests, 33 interface/ACL checks and
14 portal tests including actual Caddy HTTP/TLS proxy fixtures. They verify
tenant filtering, spoofed-header rejection, original device login challenges,
POST/Authorization preservation, SSO-cookie removal, private-IP redirects,
log redaction and rejection of a gateway with the wrong TLS certificate.
Actual Authelia account/MFA deployment, a real WireGuard handshake, hardware
boot and real-controller UI behavior remain untested.
Current r10 cross-build: 41067820915, source 8a2519687a32ab4e683d93b74662811606761bbf.
https://github.com/samd-atlantis/A-14329-RG-Atlantis-Modem/actions/runs/41067820915
Portal Linux/proxy checks: 41067819639; firmware source checks: 41067819432.
The r9 build 41062300294 was deliberately cancelled to include WireGuard.

2026-10-30 CURRENT SOURCE: package 0.1.0-r9 incorporates the Atlantis dashboard,
MAC-derived SSID Atlantis-XXXX, and corrected Walchem LAN defaults. Gateway is
10.0.100.7/23 (255.255.254.0), controller HTTP bookmarks .101-.104, DHCP .150-.199.
Unit records use Atlantis-AUTO or a verified Atlantis-<MAC4>; actual SSID/AP MAC
comes from the permanent internal phy0 MAC. New manifests identify the required
atlantis-mac4-v1 provisioning schema; the bundle tool rejects earlier images.
The earlier r8 build 41059927653 was cancelled to include these user changes.
Local checks passed 85 Python tests and 31 JavaScript/form/ACL checks. Coverage
includes radio MAC validation/matching and DHCP exclusion of all four controller
addresses. These are mocked/source checks; first-board Wi-Fi/traffic tests remain.
Current rebuild: 41062300294, source bdfa1d718684602ea6f9def5bbfe3447e462e3ff.
https://github.com/samd-atlantis/A-14329-RG-Atlantis-Modem/actions/runs/41062300294

2026-10-30 UI revision: package 0.1.0-r8 adds the supplied Atlantis SVG and a
home dashboard using short labels, icons and large actions. Preview branding is
updated too. The source change requires a replacement firmware build; the r7
binary and archived evidence below remain the previously validated candidate.
The revised dashboard preserves the existing modem-control validation gates.
Rebuild 41059927653 uses source fc5e330e7ba6e2a57f0d17e5cac3e287b7d05840.
It was started at 2026-10-30 13:02 UTC. Local validation passed 76 Python tests,
31 JavaScript/form/ACL checks and preview JavaScript syntax. The browser preview
was visually checked; the large Controllers action was exercised. Both copied
SVGs match the original SHA256:
1c6146cef66498b1ff2b2e334c283591ae1d354fe69a2d550c2b3c21390e1389.
https://github.com/samd-atlantis/A-14329-RG-Atlantis-Modem/actions/runs/41059927653

76 Python tests and 31 JavaScript/form/ACL checks passed on Linux for commit
62b465179c766924cc7306eebf1fdfbb9906cb28; shell syntax checks passed too.
https://github.com/samd-atlantis/A-14329-RG-Atlantis-Modem/actions/runs/40946542009
Coverage includes provisioning, first boot, carrier-control interlocks, image
preflight, private factory bundles, binary parsing and static filesystem checks.
These are source/mocked/parser tests, not router execution or hardware tests.
Local Windows checks also passed using Git Bash/OpenSSL outside the sandbox
because of its process-launch limitations.
Coverage includes direct and OpenWrt-style conditional
sourcing cases, including failed JSON/settings/final commits and console recovery.

CURRENT CANDIDATE
Run 40946542802 builds 62b465179c766924cc7306eebf1fdfbb9906cb28, carrier package
0.1.0-r7, with all review fixes below. Compilation and artifact upload PASSED at
2026-10-29 21:28 UTC. The resulting common development image is now available.
https://github.com/samd-atlantis/A-14329-RG-Atlantis-Modem/actions/runs/40946542802
Compiled-image inspection PASSED on attempt 2 at 21:35 UTC:
https://github.com/samd-atlantis/A-14329-RG-Atlantis-Modem/actions/runs/40958079191/attempts/2
The initial inspection rejected legitimate lib/network/wwan/VID:PID filenames.
Checker e37ee3be915d63fe99d0af5ad697e68307e10f54 permits only that exact USB-ID
filename pattern while retaining traversal/drive/stream rejection. The same
firmware binary passed after this inspector-only correction; no rebuild was needed.
The corrected checker also passed the Linux source suite:
https://github.com/samd-atlantis/A-14329-RG-Atlantis-Modem/actions/runs/40958997907

Independent local image and filesystem inspections also passed, with no failures
or warnings. Both binary sizes and SHA256 hashes match the build manifest; all
11 custom package files match the exact built source, verified unchanged since
62b4651. The filesystem inventory contains 158 packages and 71 kernel modules.
Compact manifest/kernel/filesystem evidence is committed under
validation/2026-10-29-62b4651/. See HANDOFF-MB00.txt for files and first-board steps.
This completes offline build validation; hardware_tested and production_approved
remain false. The modem supply deviation and initial OEM installation/recovery
procedure still require the arriving hardware.

The independent hardware desk audit is complete with documented exceptions. See
hardware/audits/AUDIT-MB00.txt. Frozen release hashes still match the original
manifest. No hardware boot, actual flash write or production qualification is
claimed.

The first cross-build, run 40923479716, failed because the script's umask 077 was
incompatible with OpenWrt's mandatory 022. This is corrected without bypassing
the prerequisite. The later unfinished 24.10.7 runs 40924364866 and 40927702703
were cancelled when that baseline was found to lack current security fixes.

The current build locks OpenWrt 25.12.6 and its published feed revisions. Run
40930865153, from fd9943582c3bb7b1a5d44c46aba2a4da8a4b6e63, failed at package
installation after compiling the toolchain and packages. The carrier requested
kmod-i2c-dev, which is not a package in this release. Its i2c-dev.ko driver is
already included in kmod-i2c-core. The dependency is corrected to that package;
driver-file and autoload checks remain required. All other direct dependencies
were matched to the pinned package definitions and that run's built APK records.
https://github.com/samd-atlantis/A-14329-RG-Atlantis-Modem/actions/runs/40930865153
An early guard now requires every direct carrier dependency to be selected for
installation after defconfig, before starting the long compilation. That guard
and the corrected cross-build passed for the current candidate above.
Replacement run 40944786722, source e40b98cd779f0fac846e862738054560af8cd671,
was deliberately cancelled after a separate first-boot error-handling defect was
reproduced. OpenWrt sources defaults in a conditional subshell, suppressing shell
errexit. Required operations now explicitly exit on failure, remove any pending
success marker, lock network access and retain the unprovisioned fixture console.
Successful provisioning still requires console authentication; provisioned units'
upgrade path remains unchanged. The current successful build includes this fix.
https://github.com/samd-atlantis/A-14329-RG-Atlantis-Modem/actions/runs/40944786722
Run 40946264631 was also deliberately superseded shortly after starting so the
final controller-link correction could be included: IPv4 leading zeros are
normalized to decimal octets, and subnet suffixes are rejected. Otherwise a
browser could open a different controller than the address displayed in LuCI.
No completed image was produced by either superseded run.

The cross-build checks the actual sysupgrade metadata and carrier device tree
before uploading it. After a successful main-branch build, the separate
MB00 compiled-image checks workflow downloads that exact run's artifact and
compares its filesystem with the exact built package source. Both workflows
must pass. The latter checks installed packages, modules/autoload, executables,
service links, locked root, control defaults and unit-record preservation.
It archives static inspection evidence and never boots or flashes the image.
See SECURITY-BASELINE.txt and firmware-image-checks.yml.

Unprovisioned CI images alone are not customer-ready firmware. They have no unit
credentials, no working setup AP and no hardware acceptance record. The first
board still needs flash/RAM identification, backups, a qualified programming
procedure and the acceptance checks in PROGRAMMING-MB00.txt.
