samd-atlantis/A-14329-RG-Atlantis-Modem/firmware/commissioning/assets/atlantis-bw.png

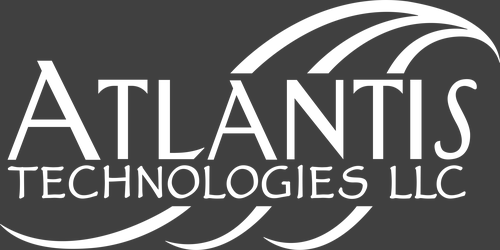
firmware/commissioning/assets/atlantis-bw.png
