samd-atlantis/A-14329-RG-Atlantis-Modem/hardware/easyeda/onboard-esim-test-pads-3d.png

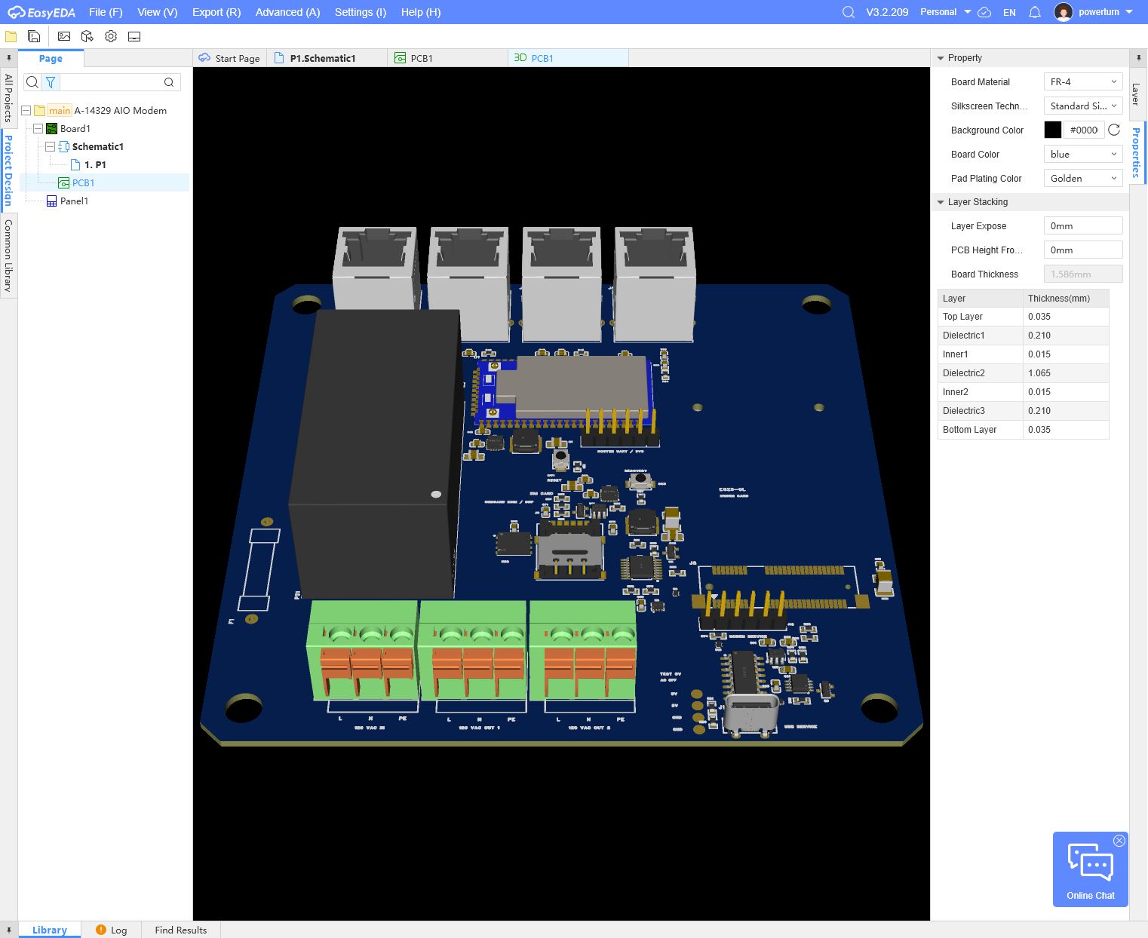
hardware/easyeda/onboard-esim-test-pads-3d.png
