samd-atlantis/A-14329-RG-Atlantis-Modem/hardware/easyeda/test-pads-3d.png

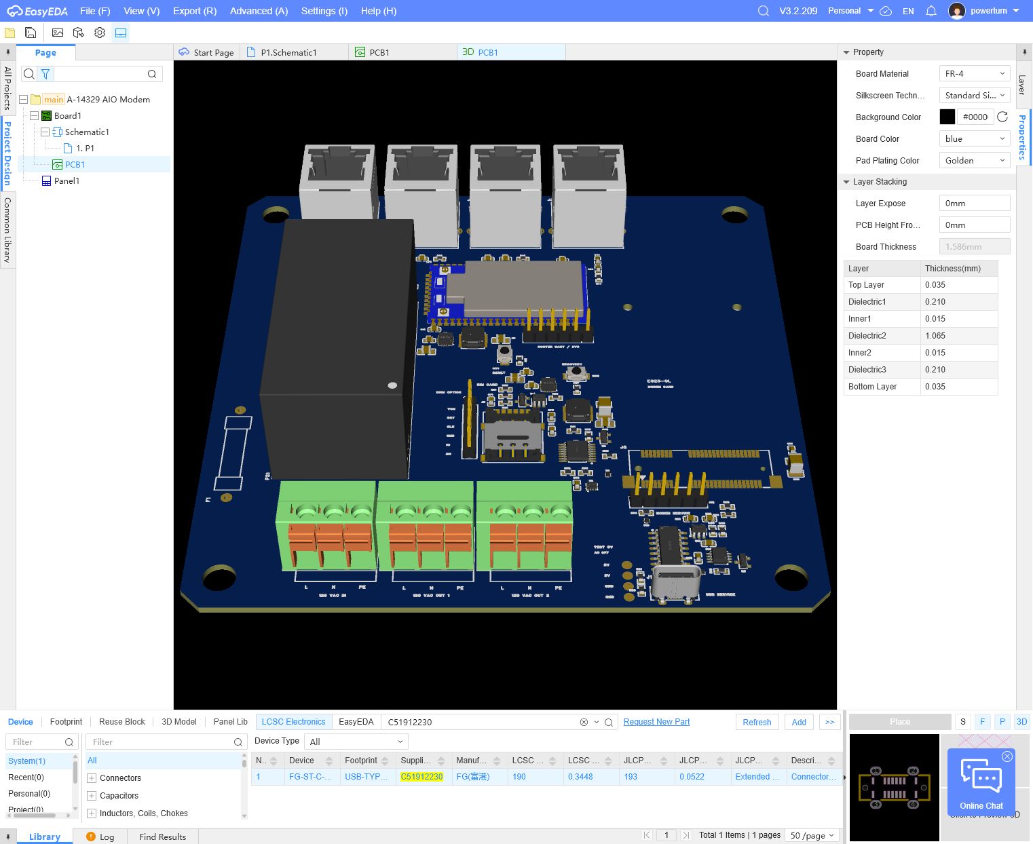
hardware/easyeda/test-pads-3d.png
