samd-atlantis/A-14329-RG-Atlantis-Modem/hardware/revisions/MB00-ECO50/modem-capacitor-review.png

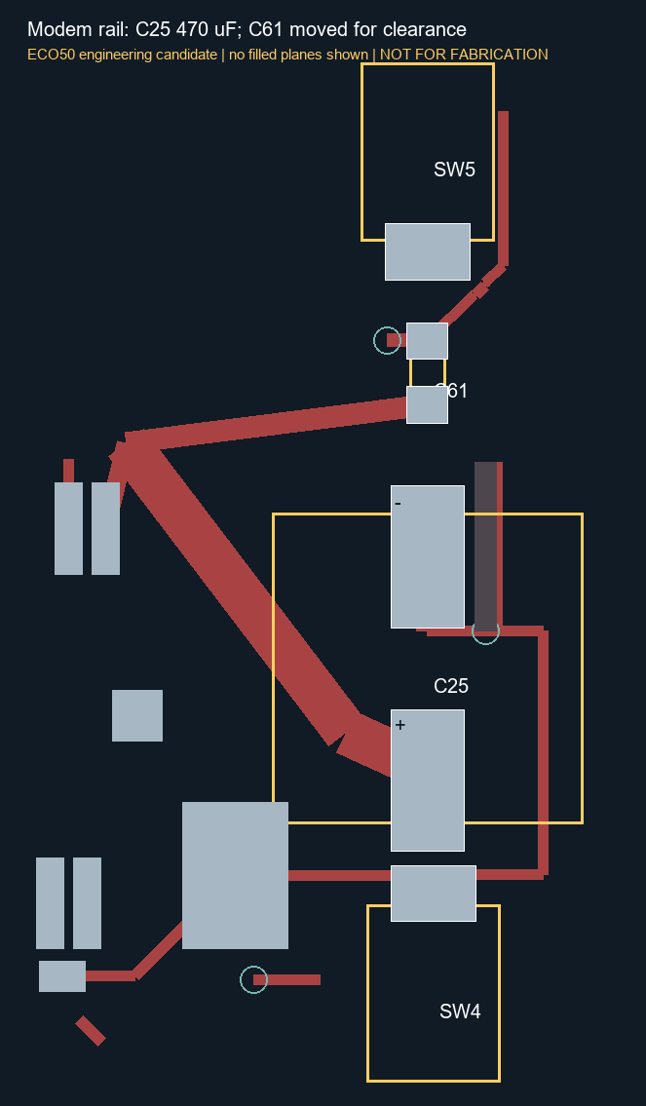
hardware/revisions/MB00-ECO50/modem-capacitor-review.png
