samd-atlantis/A-14329-RG-Atlantis-Modem/hardware/revisions/MB00-ECO50/native-pcb-drc.jpg

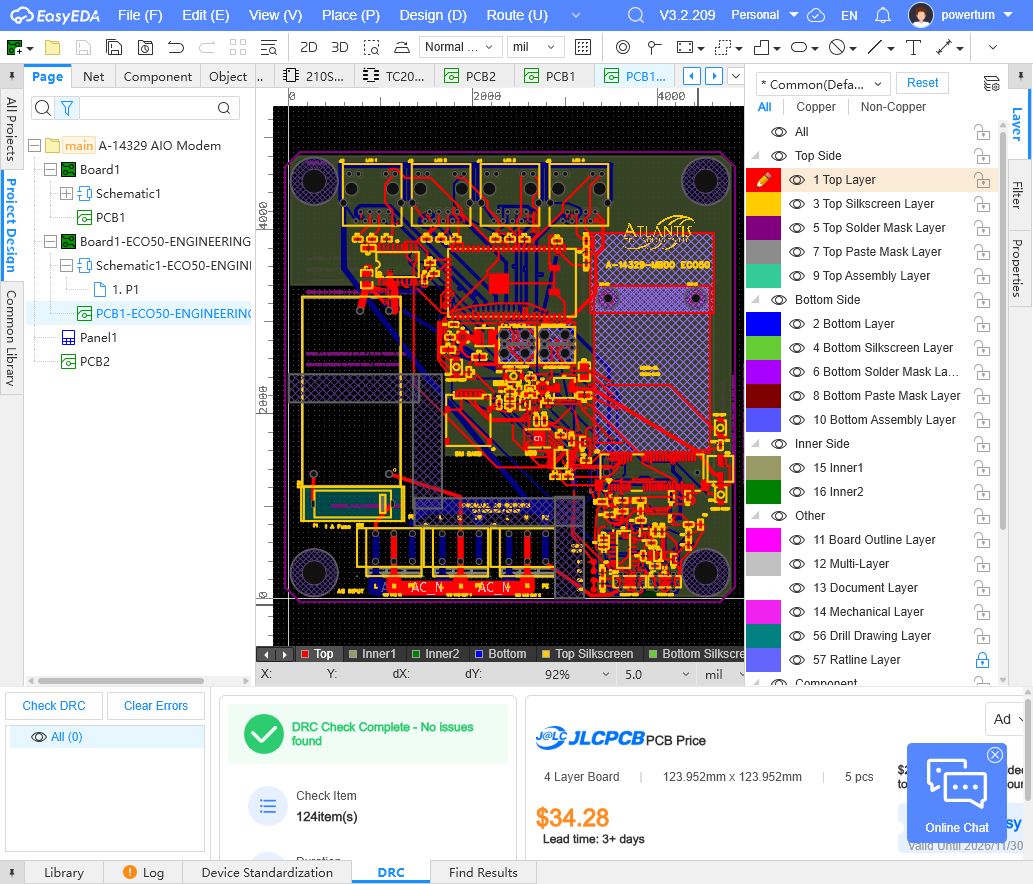
hardware/revisions/MB00-ECO50/native-pcb-drc.jpg
