samd-atlantis/A-14329-RG-Atlantis-Modem/hardware/revisions/MB00-ECO50/references/MA-dimensions.png

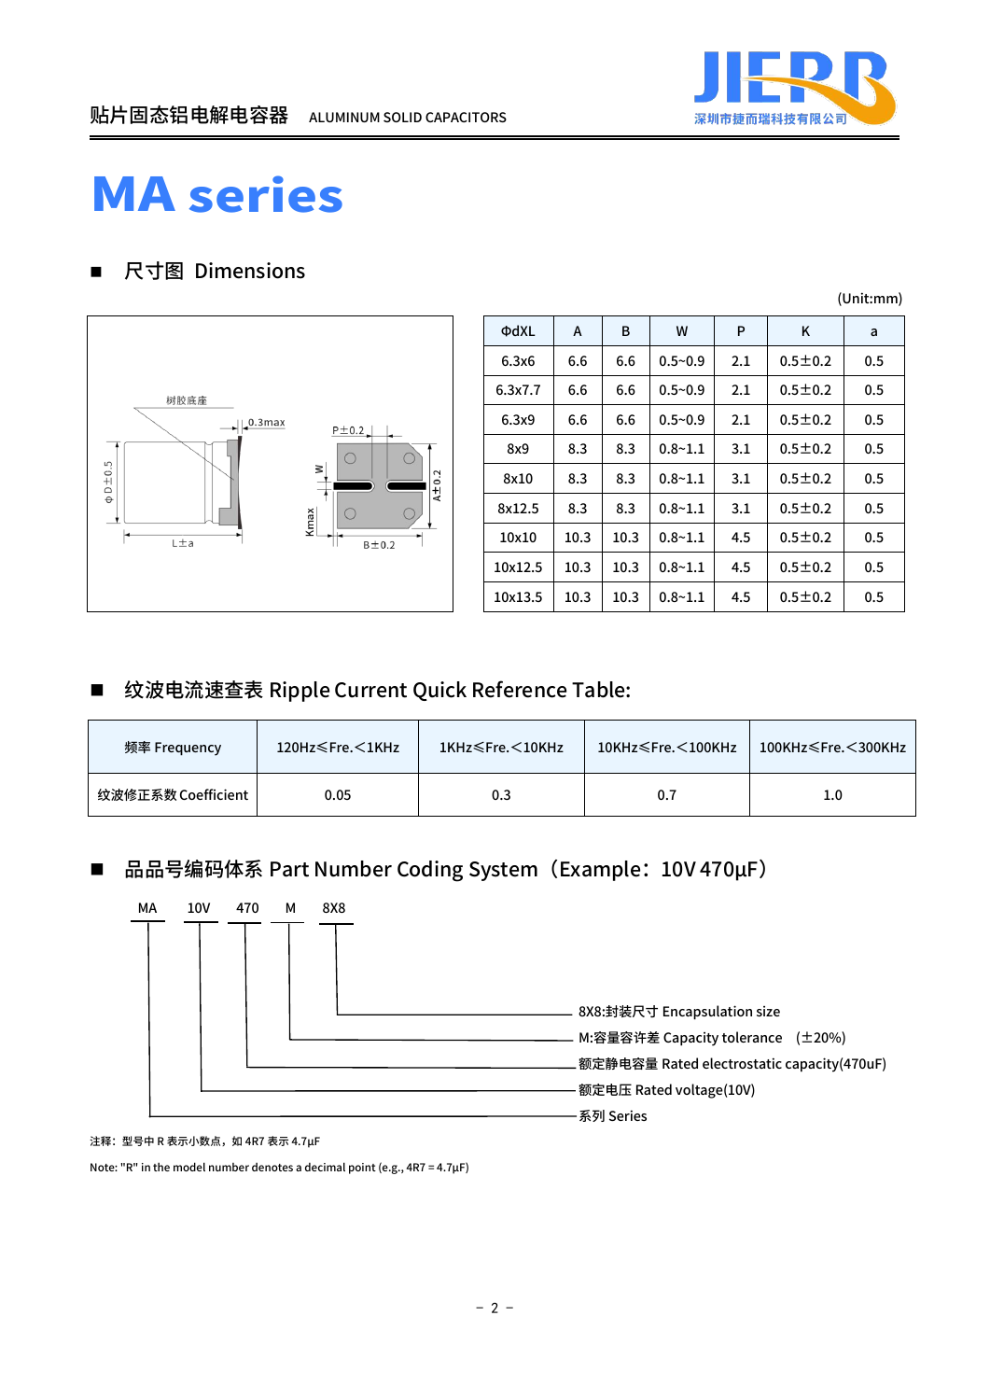
hardware/revisions/MB00-ECO50/references/MA-dimensions.png
