samd-atlantis/A-14329-RG-Atlantis-Modem/hardware/revisions/MB00-ECO50/references/MWSA-02.png

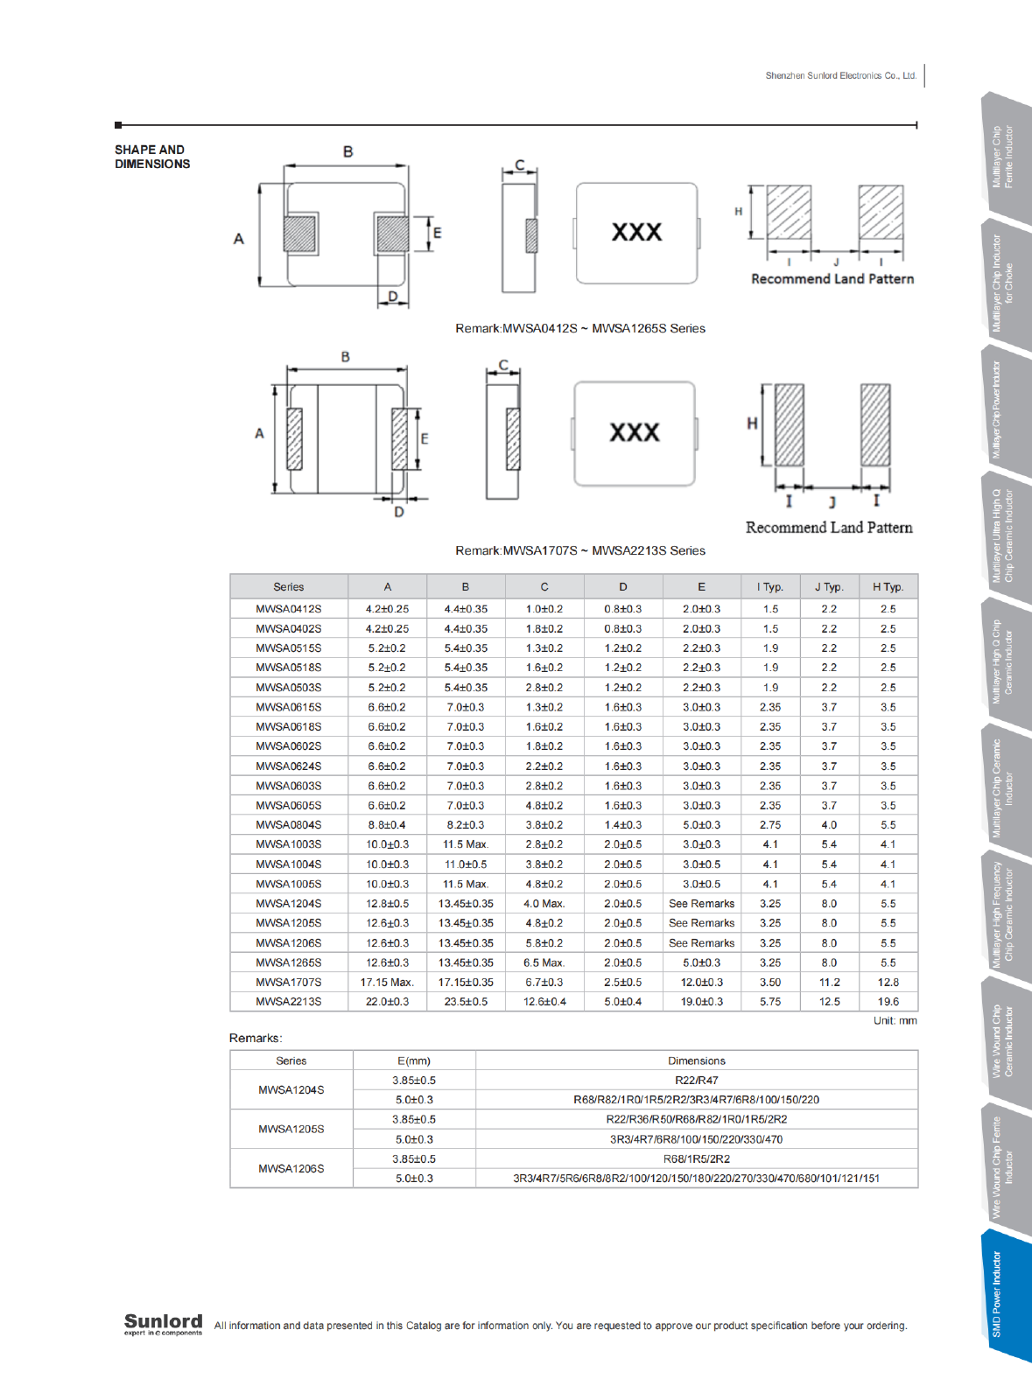
hardware/revisions/MB00-ECO50/references/MWSA-02.png
