samd-atlantis/A-14329-RG-Atlantis-Modem/hardware/revisions/MB00-ECO50/references/MWSA-0503-table.png

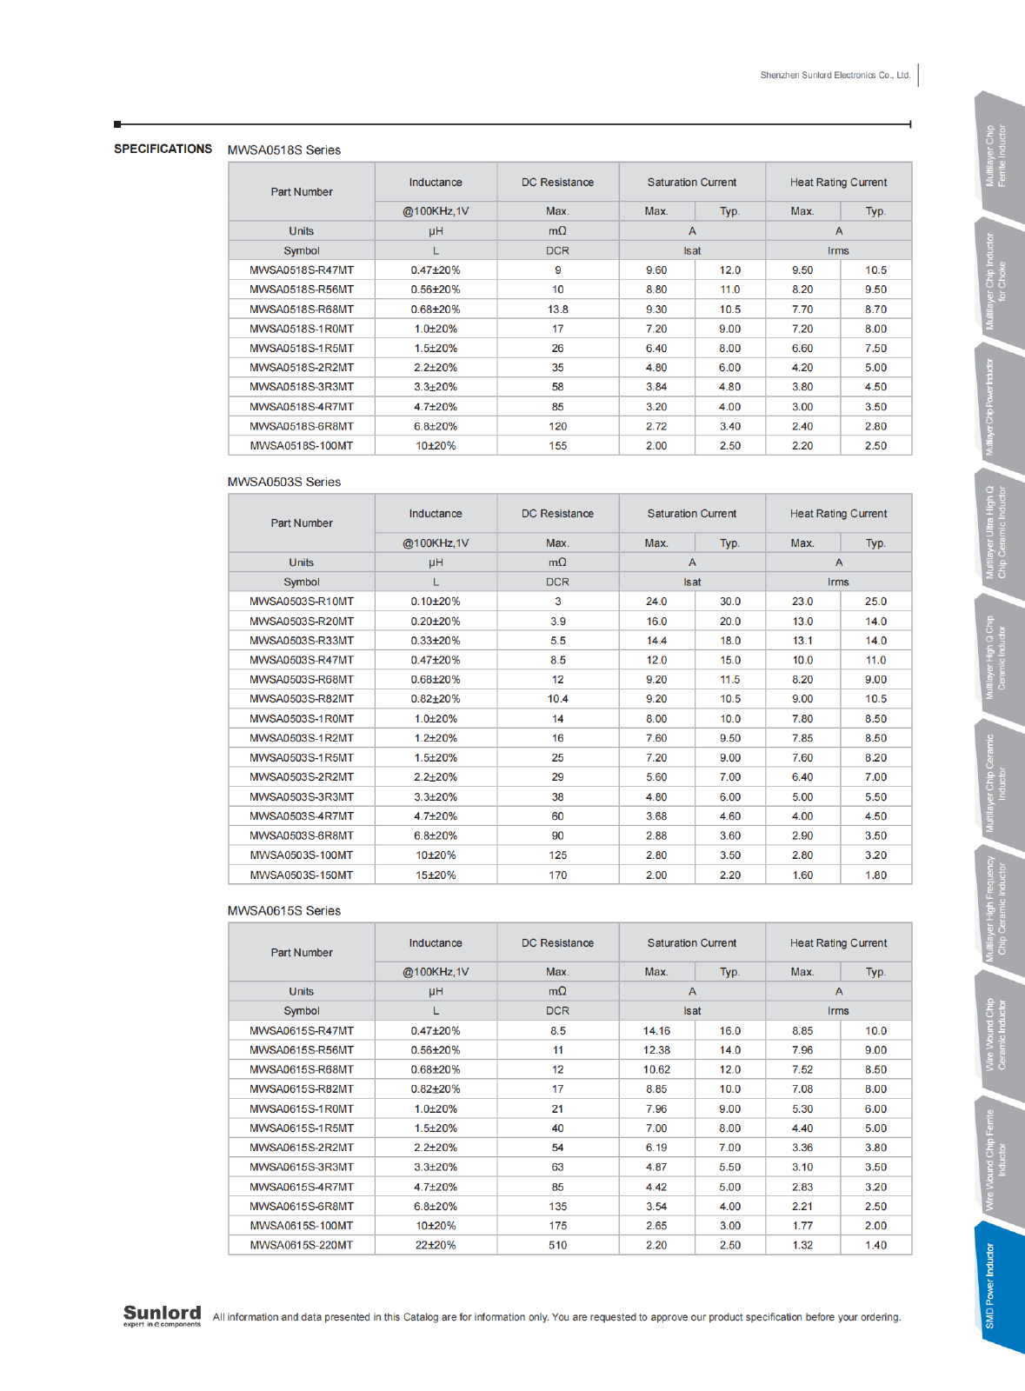
hardware/revisions/MB00-ECO50/references/MWSA-0503-table.png
