samd-atlantis/A-14329-RG-Atlantis-Modem/hardware/easyeda/C51912230.pdf

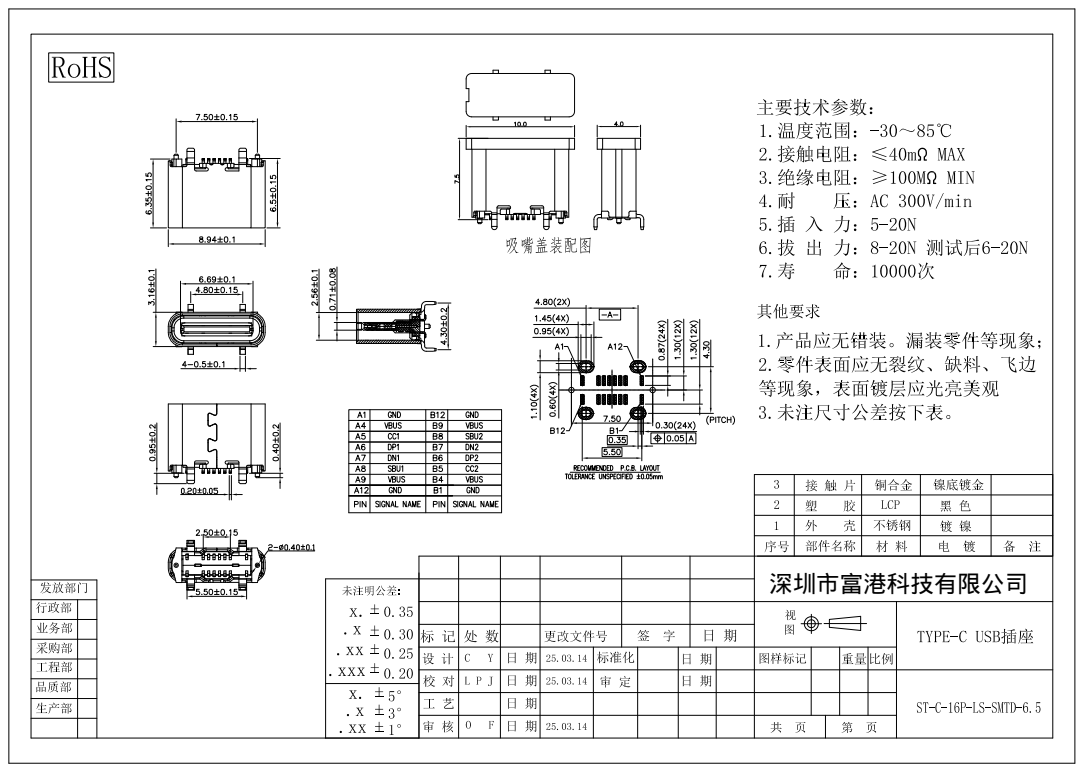
[picture p88: page 1]
深圳市富港科技有限公司
