samd-atlantis/A-14329-RG-Atlantis-Modem/hardware/enclosure/PCJR0505.pdf

## TOP VIEW

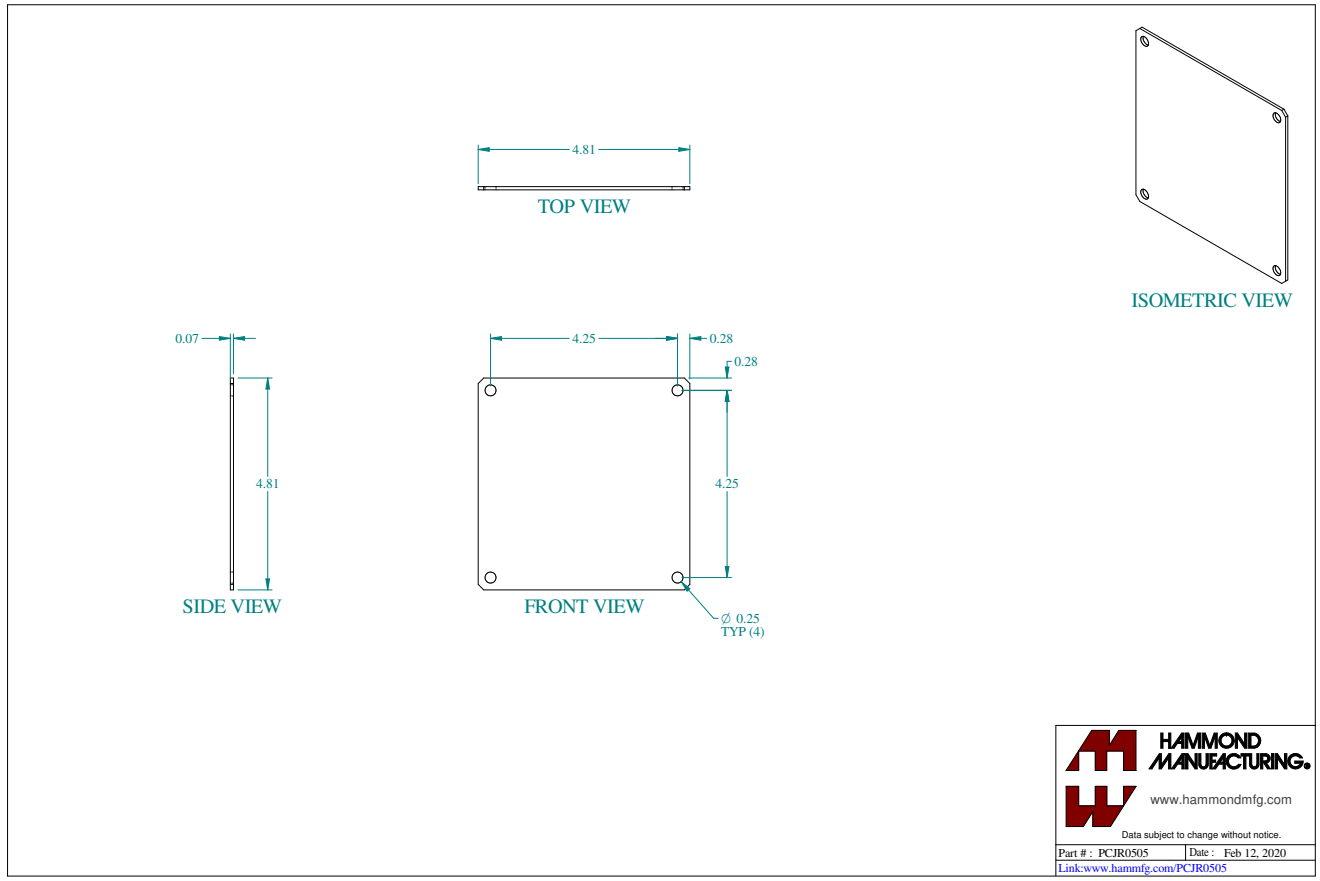
[picture p89: page 1]
Part # : PCJR0505; Date : Feb 12, 2020; FRONT VIEW; SIDE VIEW; ISOMETRIC VIEW; O 0.25 TYP (4)

www.hammondmfg.com

Data subject to change without notice.

Link:www.hammfg.com/PCJR0505
