samd-atlantis/A-14329-RG-Atlantis-Modem/(list of files, drawings)

Other design files:
hardware/audits/mb00-electrical/pcb-pad-nets.json
hardware/audits/mb00-electrical/schematic-pins.json
hardware/easyeda/5v-cap-branch-draft.json
hardware/easyeda/5v-main-trunk-draft.json
hardware/easyeda/5v-router-branch-draft.json
hardware/easyeda/5v-supply-combined-draft.json
hardware/easyeda/a4-added-bom.json
hardware/easyeda/a4-added-pin-map.json
hardware/easyeda/a4-all-docs.json
hardware/easyeda/a4-all-net-map.json
hardware/easyeda/a4-complete-docs.json
hardware/easyeda/a4-pin-audit.json
hardware/easyeda/a4-placement-envelope-audit.json
hardware/easyeda/a4-validation.json
hardware/easyeda/ac-distribution-route-draft.json
hardware/easyeda/bom-a2.json
hardware/easyeda/buck-local-route-draft.json
hardware/easyeda/buck-output-route-draft.json
hardware/easyeda/buck-switch-route-draft.json
hardware/easyeda/chassis-combined-review.json
hardware/easyeda/chassis-combined-unique-review.json
hardware/easyeda/chassis-rj45-bus-draft.json
hardware/easyeda/control-routed-docs.json
hardware/easyeda/control-update32-candidate-docs.json
hardware/easyeda/control-update32-complete-docs.json
hardware/easyeda/control-update32-final-docs.json
hardware/easyeda/control-update32-final-fragment.json
hardware/easyeda/control-update32-review.json
hardware/easyeda/control-update32-with-feed-docs.json
hardware/easyeda/dual-usbc-before-docs.json
hardware/easyeda/dual-usbc-validation.json
hardware/easyeda/enclosure-a4-dimensions.json
hardware/easyeda/escape-proposal-review.json
hardware/easyeda/escape-sequence-fragment.json
hardware/easyeda/escape-sequence-report.json
hardware/easyeda/esim-seed-docs.json
hardware/easyeda/fanout-pin-table.json
hardware/easyeda/final43-validation.json
hardware/easyeda/fuse-holder-seed-docs.json
hardware/easyeda/ground35-final-fragment.json
hardware/easyeda/ground35-proposed-docs.json
hardware/easyeda/ground-endpoints34-review.json
hardware/easyeda/ground-endpoints34-working-docs.json
hardware/easyeda/ground-explicit-bridge-review.json
hardware/easyeda/ground-link-detours32-review.json
hardware/easyeda/ground-local-stitches-review.json
hardware/easyeda/ground-short-bonds-review.json
hardware/easyeda/ground-via-tree-review.json
hardware/easyeda/inner-escape-completion-review.json
hardware/easyeda/inner-escape-L2-completion-review.json
hardware/easyeda/integra-6x6-validation.json
hardware/easyeda/lan3-rx-routing-candidate.json
hardware/easyeda/mechanical46-validation.json
hardware/easyeda/model-holder-final-seed-docs.json
hardware/easyeda/modem-holder-models-validation.json
hardware/easyeda/modem-mechanical-verification.json
hardware/easyeda/modem-mounting-hardware.json
hardware/easyeda/modem-power-branch-2-draft.json
hardware/easyeda/modem-power-branch-41-draft.json
hardware/easyeda/modem-power-trunk-draft.json
hardware/easyeda/modem-supply-combined-draft.json
hardware/easyeda/native33-data-routing-preservation.json
hardware/easyeda/native33-scoped-ripup-interim-docs.json
hardware/easyeda/native37-data-preservation.json
hardware/easyeda/native37-recovery-pin-verification.json
hardware/easyeda/onboard-esim-test-pads-validation.json
hardware/easyeda/pcb-assembly49-docs.json
hardware/easyeda/pcb-eco-a4-docs.json
hardware/easyeda/pcb-final42-docs.json
hardware/easyeda/pcb-final43-docs.json
hardware/easyeda/pcb-fix41-docs.json
hardware/easyeda/pcb-links.json
hardware/easyeda/pcb-mechanical46-docs.json
hardware/easyeda/pcb-small-component-tidy-final-docs.json
hardware/easyeda/pcb-terminals49-docs.json
hardware/easyeda/pin-map-a2.json
hardware/easyeda/plane-template-docs.json
hardware/easyeda/plug-labels-validation.json
hardware/easyeda/plug-labels.json
hardware/easyeda/power-placement-draft.json
hardware/easyeda/production-current-docs.json
hardware/easyeda/production-pcb-pin-audit-a3.json
hardware/easyeda/production-pin-map-a3.json
hardware/easyeda/psu-ground-return-draft.json
hardware/easyeda/remaining-3V3_ROUTER-@2440,2905-@2370,2985-draft.json
hardware/easyeda/remaining-3V3_ROUTER-@2440,2905-R37-draft.json
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
