samd-atlantis/A-14329-RG-Atlantis-Modem/hardware/audits/mb00-physical/mb00-audit-only.kicad_pcb

## KiCad design hardware/audits/mb00-physical/mb00-audit-only.kicad_pcb (2026-10-29)

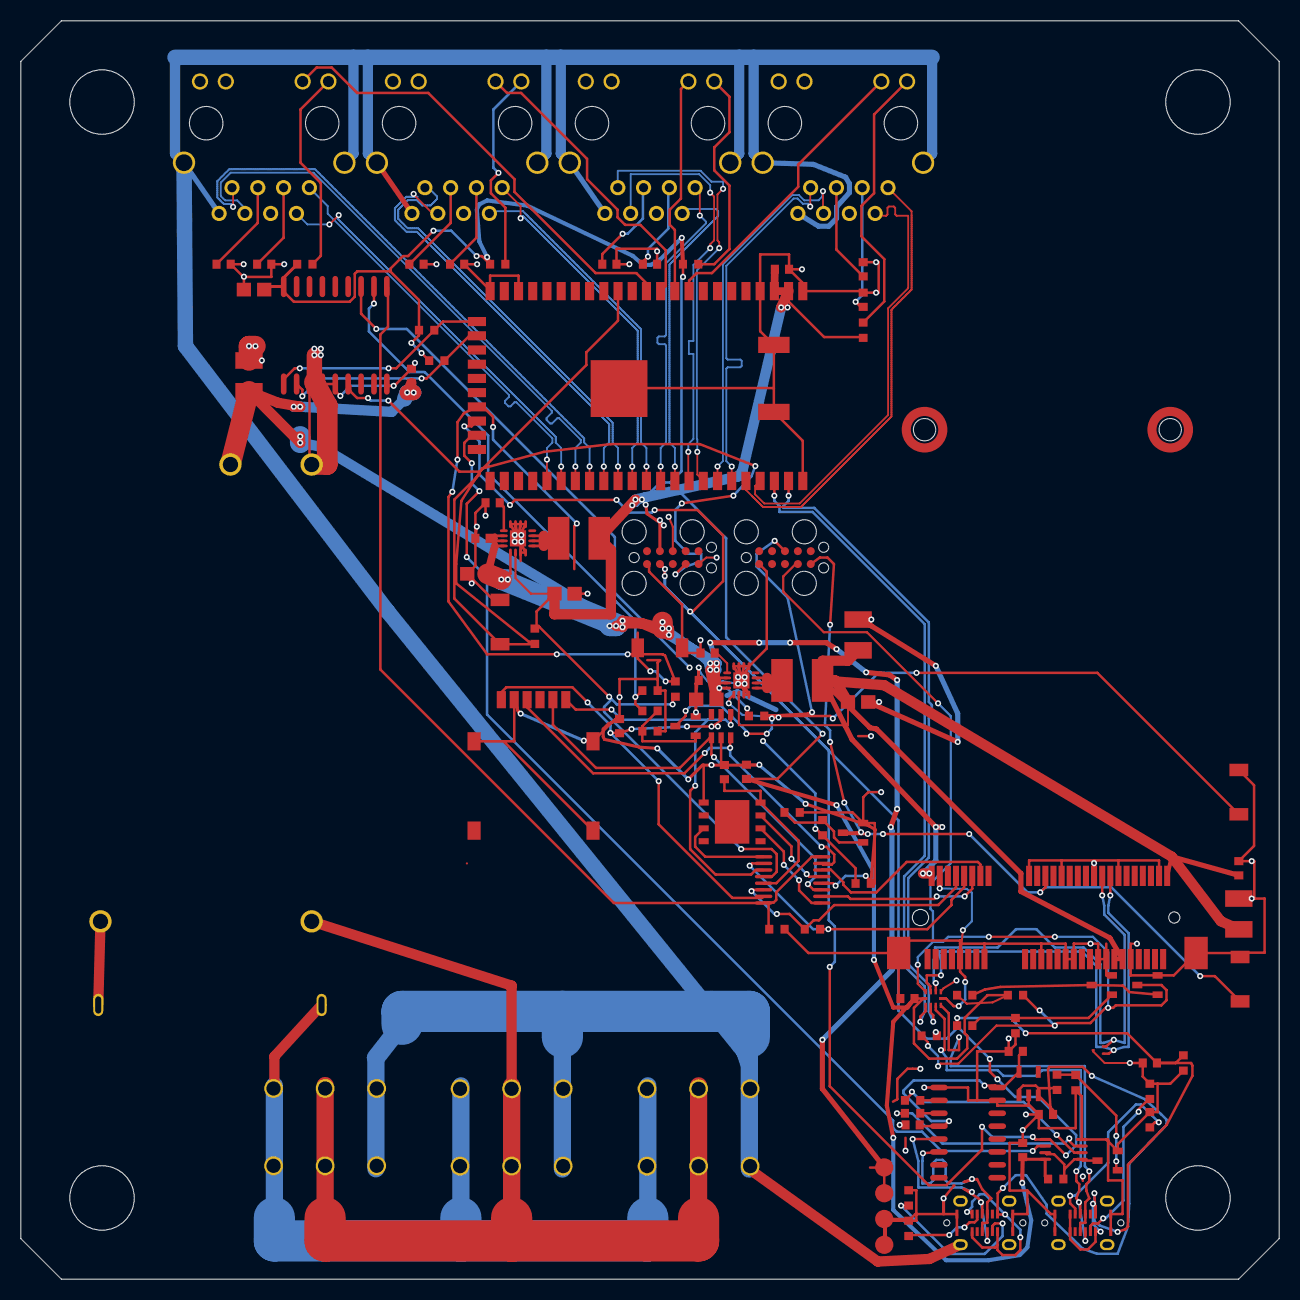
[picture p90: board mb00-audit-only.kicad_pcb from above]

Board: 4 copper layers, 124.0 x 124.0 mm, 138 parts (0 on the bottom side), 93 nets.

Parts:
C1, C2, C10, C11, C12, C13, C20, C21, C22, C23, C24, C25, C30, C31, C41, C42, C43, C44, C51, C52, C53, C54, C60, C61, C70, C71, C72, C90, C91, C92, C93, C94: AUDIT_ONLY
CN1: AUDIT_ONLY
F1: AUDIT_ONLY
J2, J2.e25, J2.e26, J3, J3.e25, J3.e26, J4, J4.e25, J4.e26, J5, J5.e25, J5.e26, J8, J8.e126, J8.e127, J9, J14, J14.e55, J14.e56, J15, J16, J17, J17.e55, J17.e56: AUDIT_ONLY
L1, L2: AUDIT_ONLY
MODEM1: AUDIT_ONLY
PS1: AUDIT_ONLY
Q1, Q2, Q3, Q4, Q5: AUDIT_ONLY
R20, R21, R22, R30, R31, R32, R33, R35, R36, R37, R41, R42, R43, R44, R60, R61, R70, R74, R90, R91, R92, R93, R94, R95, R96, R97, R98, R99, R100, R101, R102, R103: AUDIT_ONLY
SW1, SW3, SW4, SW5: AUDIT_ONLY
TEST_PADS: AUDIT_ONLY
U1, U2, U3, U6, U8, U9, U10, U14, U15, U16, U17, U18, U19, U20: AUDIT_ONLY
ed270000000001f4, ed270000000001f6, ed270000000001f8, ed270000000001fa, ed26000000000931, ed26000000000936: AUDIT_ONLY
tc2050leg_00000b, tc2050leg_00000d, tc2050leg_00000f, tc2050leg_00001a, tc2050leg_00003c, tc2050leg_00003f, tc2050leg_000011, tc2050leg_000014, tc2050leg_000017, tc2050leg_000030, tc2050leg_000032, tc2050leg_000034, tc2050leg_000036, tc2050leg_000039: AUDIT_ONLY

Connections:
3V3_MODEM: C23.1, C24.1, C25.1, C61.1, J8.2, J8.39, J8.41, J8.52, L2.2, U3.14
3V3_ROUTER: C13.1, C30.1, C31.1, C60.1, C70.1, C93.1, L1.2, R30.1, R31.1, R36.1, R37.1, R41.1, R42.1, R43.1, R44.1, R92.1, R102.1, R103.1, TEST_PADS.H1-9, U1.2, U1.3, U2.14, U6.18, U8.10, U10.12, U18.8
5V_ISO: C1.1, C2.1, C10.1, C11.1, C20.1, C21.1, PS1.3, R20.1, TEST_PADS.3, TEST_PADS.4, U2.10, U2.11, U2.12, U2.13, U3.10, U3.11, U3.12
AC_L_FUSED: F1.2, PS1.2
AC_L_IN: CN1.1, F1.1, J15.1, J16.1
AC_N: CN1.2, J15.2, J16.2, PS1.1
CHASSIS_PE: CN1.3, J2.8, J2.13, J2.14, J3.8, J3.13, J3.14, J4.8, J4.13, J4.14, J5.8, J5.13, J5.14, J14.1, J14.2, J14.3, J14.4, J15.3, J16.3, J17.1, J17.2, J17.3, J17.4
CONSOLE_RX: TEST_PADS.H1-8, U1.32, U18.6
CONSOLE_TX: TEST_PADS.H1-2, U1.31, U18.5
GND_ISO: C1.2, C2.2, C10.2, C11.2, C12.2, C13.2, C20.2, C21.2, C22.2, C23.2, C24.2, C25.2, C30.2, C31.2, C41.2, C42.2, C43.2, C44.2, C51.2, C52.2, C53.2, C54.2, C60.2, C61.2, C70.2, C71.2, C72.2, C90.2, C91.2, C92.2, C93.2, C94.2, J8.4, J8.9, J8.15, J8.18, J8.21, J8.26, J8.27, J8.29, J8.34, J8.35, J8.37, J8.40, J8.43, J8.50, J8.MP1, J8.MP2, J9.5, J9.9, J9.10, J9.11, J14.A1, J14.A12, J14.B1, J14.B12, J17.A1, J17.A12, J17.B1, J17.B12, PS1.4, Q1.2, Q2.2, Q3.2, Q4.2, Q5.2, R22.2, R32.2, R33.2, R35.2, R61.2, R74.2, R90.2, R91.2, R93.2, R97.2, R98.2, R99.2, R101.2, SW1.2, SW3.2, SW4.2, SW5.2, TEST_PADS.1, TEST_PADS.2, TEST_PADS.H1-1, TEST_PADS.J12-1, U1.1, U1.4, U1.21, U1.23, U1.56, U1.57, U1.58, U1.59, U2.5, U2.6, U2.7, U2.8, U2.15, U2.16, U2.17, U3.5, U3.6, U3.7, U3.8, U3.15, U3.16, U3.17, U6.3, U6.4, U6.5, U6.9, U8.5, U9.3, U10.4, U14.2, U15.3, U16.1, U16.15, U17.2, U18.4, U19.3, U20.1
I2C_SCL: R30.2, U1.24, U6.1
I2C_SDA: R31.2, U1.25, U6.2
LAN1_GREEN_A: J2.9, R41.2
LAN1_LED_N: J2.10, U1.12
LAN1_RXN: J2.7, U1.41
LAN1_RXP: J2.6, U1.40
LAN1_RX_CT: C41.1, J2.5
LAN1_TXN: J2.2, U1.39
LAN1_TXP: J2.1, U1.38
LAN1_TX_CT: C51.1, J2.3
LAN2_GREEN_A: J3.9, R42.2
LAN2_LED_N: J3.10, U1.11
LAN2_RXN: J3.7, U1.43
LAN2_RXP: J3.6, U1.42
LAN2_RX_CT: C42.1, J3.5
LAN2_TXN: J3.2, U1.45
LAN2_TXP: J3.1, U1.44
LAN2_TX_CT: C52.1, J3.3
LAN3_GREEN_A: J4.9, R43.2
LAN3_LED_N: J4.10, U1.10
LAN3_RXN: J4.7, U1.49
LAN3_RXP: J4.6, U1.48
LAN3_RX_CT: C43.1, J4.5
LAN3_TXN: J4.2, U1.47
LAN3_TXP: J4.1, U1.46
LAN3_TX_CT: C53.1, J4.3
LAN4_GREEN_A: J5.9, R44.2
LAN4_LED_N: J5.10, U1.9
LAN4_RXN: J5.7, U1.51
LAN4_RXP: J5.6, U1.50
LAN4_RX_CT: C44.1, J5.5
LAN4_TXN: J5.2, U1.53
LAN4_TXP: J5.1, U1.52
LAN4_TX_CT: C54.1, J5.3
MODEM_BUCK_EN: Q1.3, R20.2, SW5.1, TEST_PADS.J12-8, U3.13
MODEM_OFF: R21.1, R33.1, U6.11, U8.6
MODEM_OFF_GATE: Q1.1, R21.2, R22.1
MODEM_PERST_N: J8.22, Q2.3, SW4.1, TEST_PADS.J12-5
MODEM_RESET_GATE: Q2.1, R60.2, R61.1
MODEM_RESET_REQ: R35.1, R60.1, U6.12
MODEM_USB_SEL: Q5.3, R74.1, R103.2, TEST_PADS.J12-4, U8.9
MUSB_CC1: J17.A5, R97.1
MUSB_CC2: J17.B5, R98.1
MUSB_DETECT_N: Q4.3, Q5.1, R102.2
MUSB_GATE: Q4.1, R100.2, R101.1
MUSB_VBUS: C94.1, J17.A4, J17.A9, J17.B4, J17.B9, R99.1, R100.1
M_SS: C22.1, U3.9
M_SW: L2.1, U3.1, U3.2, U3.3
ROUTER_GPIO0_N: R37.2, SW3.1, TEST_PADS.H1-5, U1.30
ROUTER_RESET_N: R36.2, SW1.1, TEST_PADS.H1-4, U1.14, U6.6
R_SS: C12.1, U2.9
R_SW: L1.1, U2.1, U2.2, U2.3
SIM_A_CLK: J9.3, U10.3, U14.1
SIM_A_IO: J9.7, U10.11, U14.4
SIM_A_RST: J9.2, U10.7, U14.3
SIM_A_VCC: C71.1, J9.1, U10.15, U14.5
SIM_B_CLK: U10.1, U20.6
SIM_B_IO: U10.9, U20.3
SIM_B_RST: U10.5, U20.7
SIM_B_VCC: C72.1, U10.13, U20.8
SIM_SELECT: R32.1, U6.10, U10.8, U10.16
USB_CONSOLE_DM: J14.A7, J14.B7, U16.6, U19.2
USB_CONSOLE_DP: J14.A6, J14.B6, U16.5, U19.1
USB_C_CC1: J14.A5, R90.1
USB_C_CC2: J14.B5, R91.1
USB_C_VBUS: C90.1, J14.A4, J14.A9, J14.B4, J14.B9, R94.1, U17.1, U17.3
USB_DETECT_GATE: Q3.1, R93.1, R94.2
USB_HOST_DM: U1.55, U8.2
USB_HOST_DP: U1.54, U8.1
USB_MODEM_DM: J8.36, U8.7, U9.2
USB_MODEM_DP: J8.38, U8.8, U9.1
USB_SERVICE_DM: J17.A7, J17.B7, U8.4, U15.2
USB_SERVICE_DP: J17.A6, J17.B6, U8.3, U15.1
USB_UART_3V3: C91.1, C92.1, U16.4, U16.16, U17.5
USB_UART_OE_N: Q3.3, R92.2, U18.1, U18.7
USB_UART_RX: R96.2, U16.3
USB_UART_RX_BUF: R96.1, U18.3
USB_UART_TX: R95.1, U16.2
USB_UART_TX_BUF: R95.2, U18.2
USIM_CLK: J8.12, U10.2
USIM_DATA: J8.10, R70.2, U10.10
USIM_RST: J8.14, U10.6
USIM_VDD: J8.8, R70.1, U10.14
