samd-atlantis/A-14329-RG-Atlantis-Modem/hardware/rev-a/kicad/01_ac_input.kicad_sch

## KiCad design hardware/rev-a/kicad/01_ac_input.kicad_sch (2026-10-29)

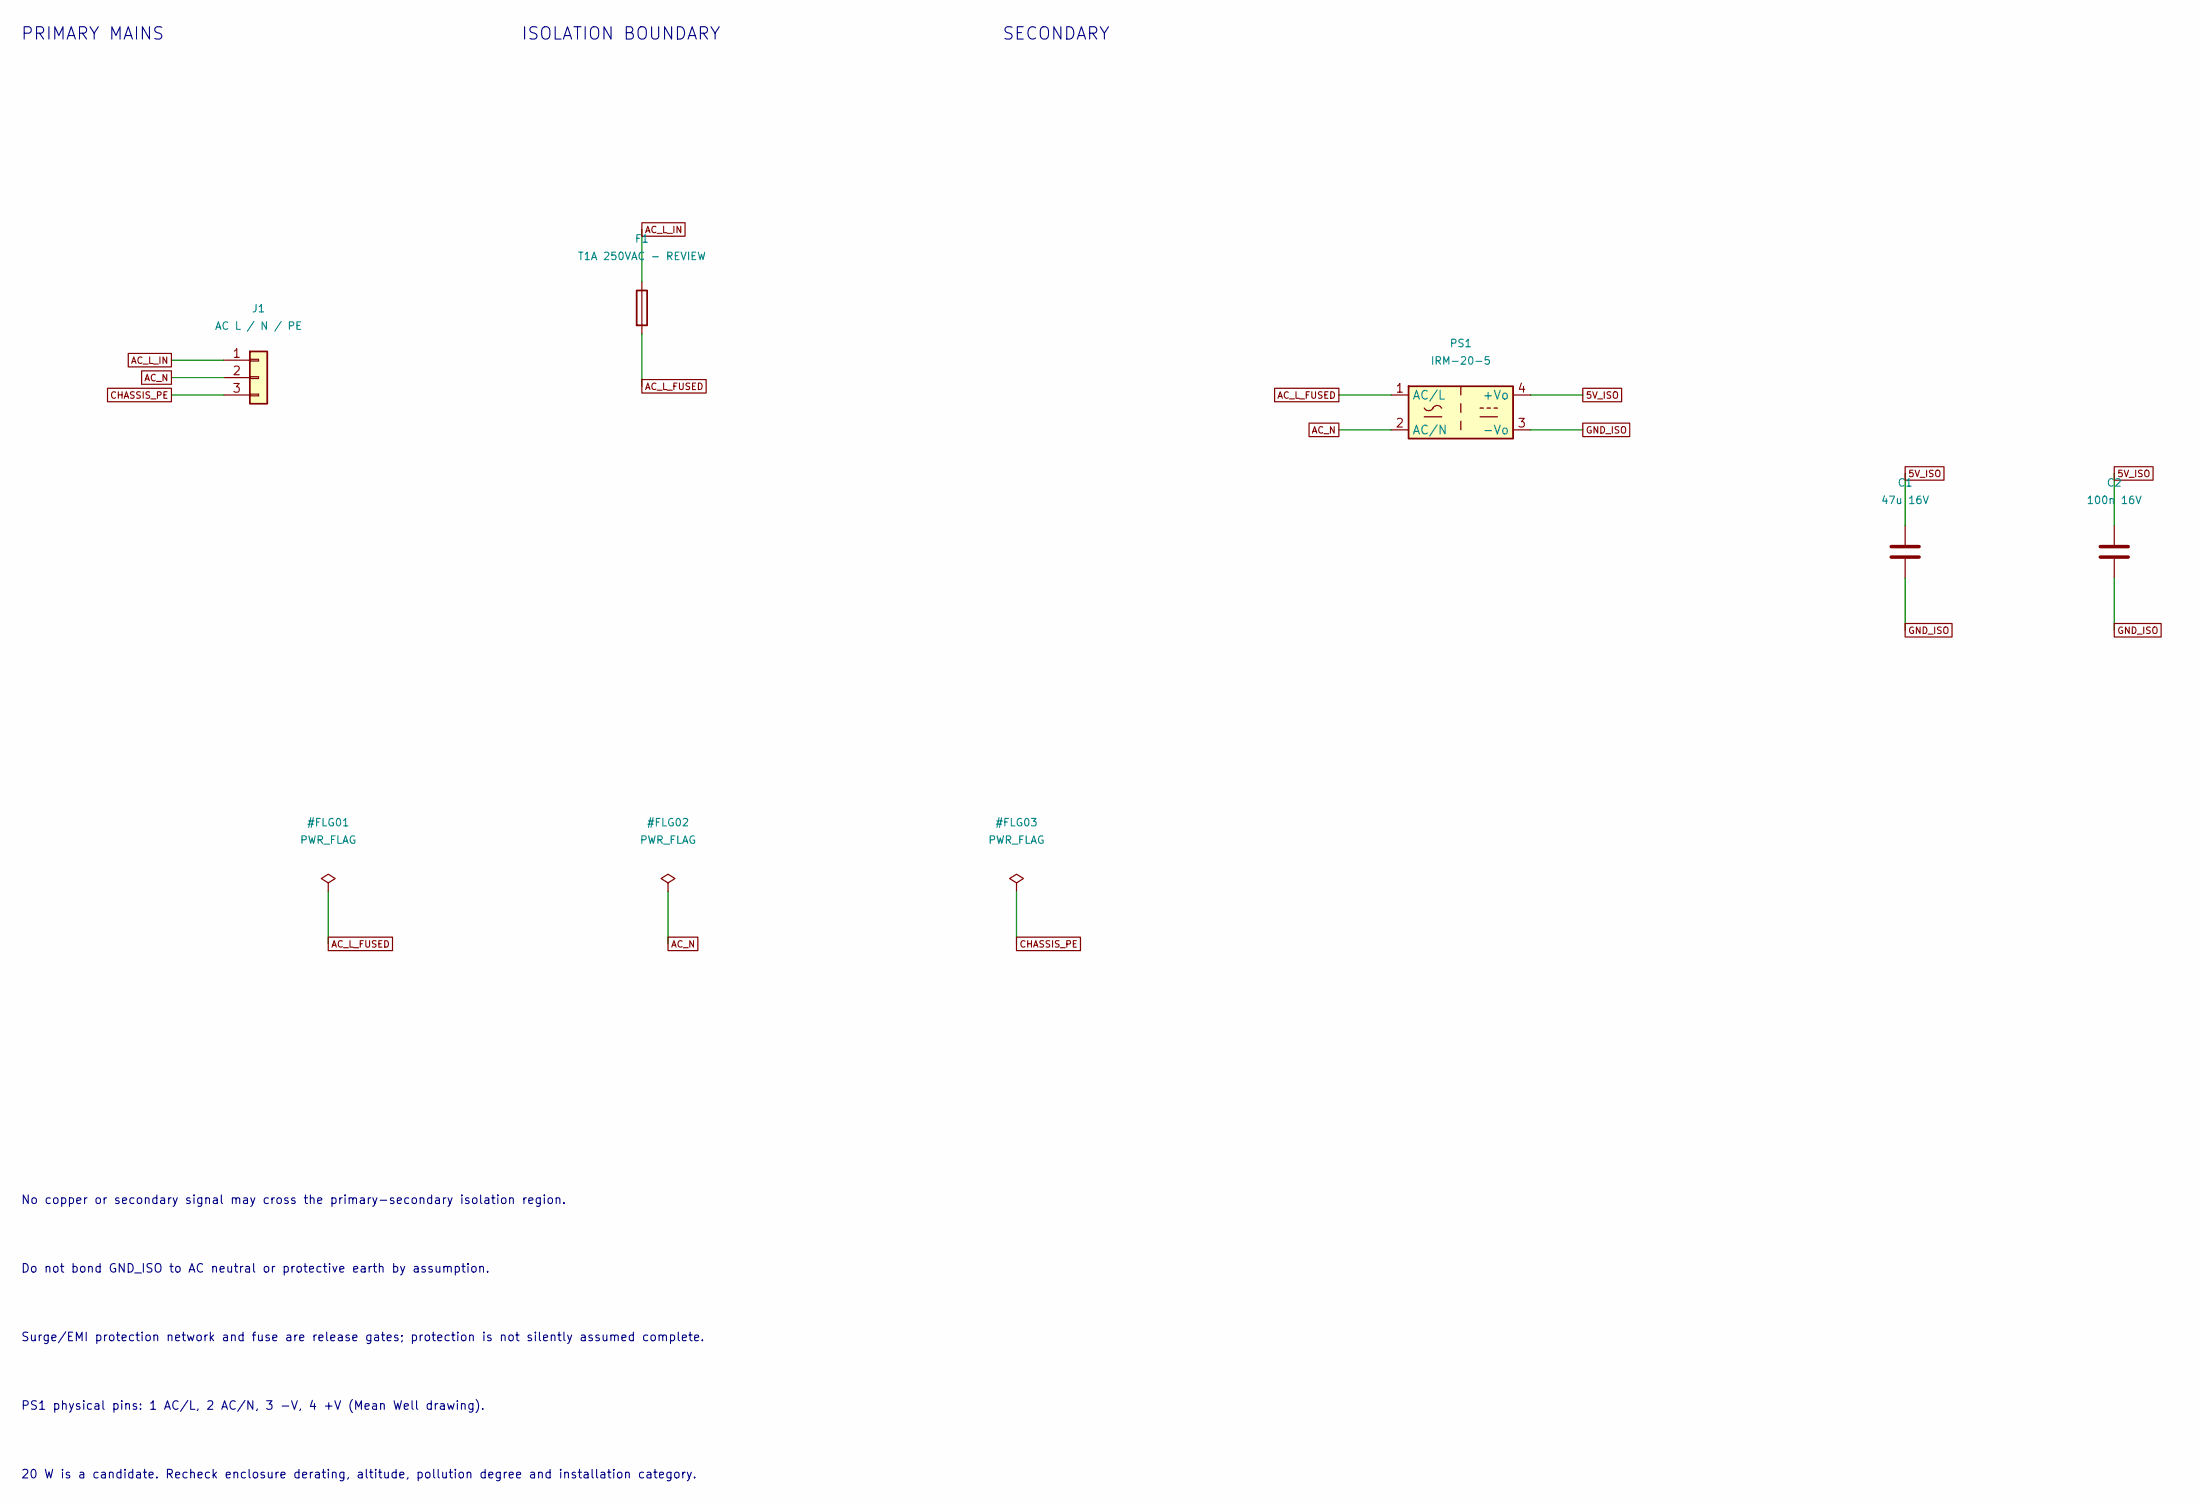
[picture p91: schematic 01_ac_input.kicad_sch]

Parts:
C1: 47u 16V; C_1210_3225Metric; MPN 47u 16V
C2: 100n 16V; C_0603_1608Metric; MPN 100n 16V
F1: T1A 250VAC - REVIEW; MPN T1A 250VAC - REVIEW
J1: AC L / N / PE; MPN AC L / N / PE
PS1: IRM-20-5; Converter_ACDC_MeanWell_IRM-20-xx_THT; MPN IRM-20-5

Connections:
5V_ISO: C1.1, C2.1, PS1.4 (+Vo)
AC_L_FUSED: F1.2, PS1.1 (AC/L)
AC_L_IN: F1.1, J1.1
AC_N: J1.2, PS1.2 (AC/N)
CHASSIS_PE: J1.3
GND_ISO: C1.2, C2.2, PS1.3 (-Vo)

Notes on the sheet:
PRIMARY MAINS ISOLATION BOUNDARY SECONDARY
No copper or secondary signal may cross the primary-secondary isolation region.
Do not bond GND_ISO to AC neutral or protective earth by assumption.
Surge/EMI protection network and fuse are release gates; protection is not silently assumed complete.
PS1 physical pins: 1 AC/L, 2 AC/N, 3 -V, 4 +V (Mean Well drawing).
20 W is a candidate. Recheck enclosure derating, altitude, pollution degree and installation category.
