samd-atlantis/A-14329-RG-Atlantis-Modem/hardware/rev-a/kicad/02_dc_power.kicad_sch

## KiCad design hardware/rev-a/kicad/02_dc_power.kicad_sch (2026-10-29)

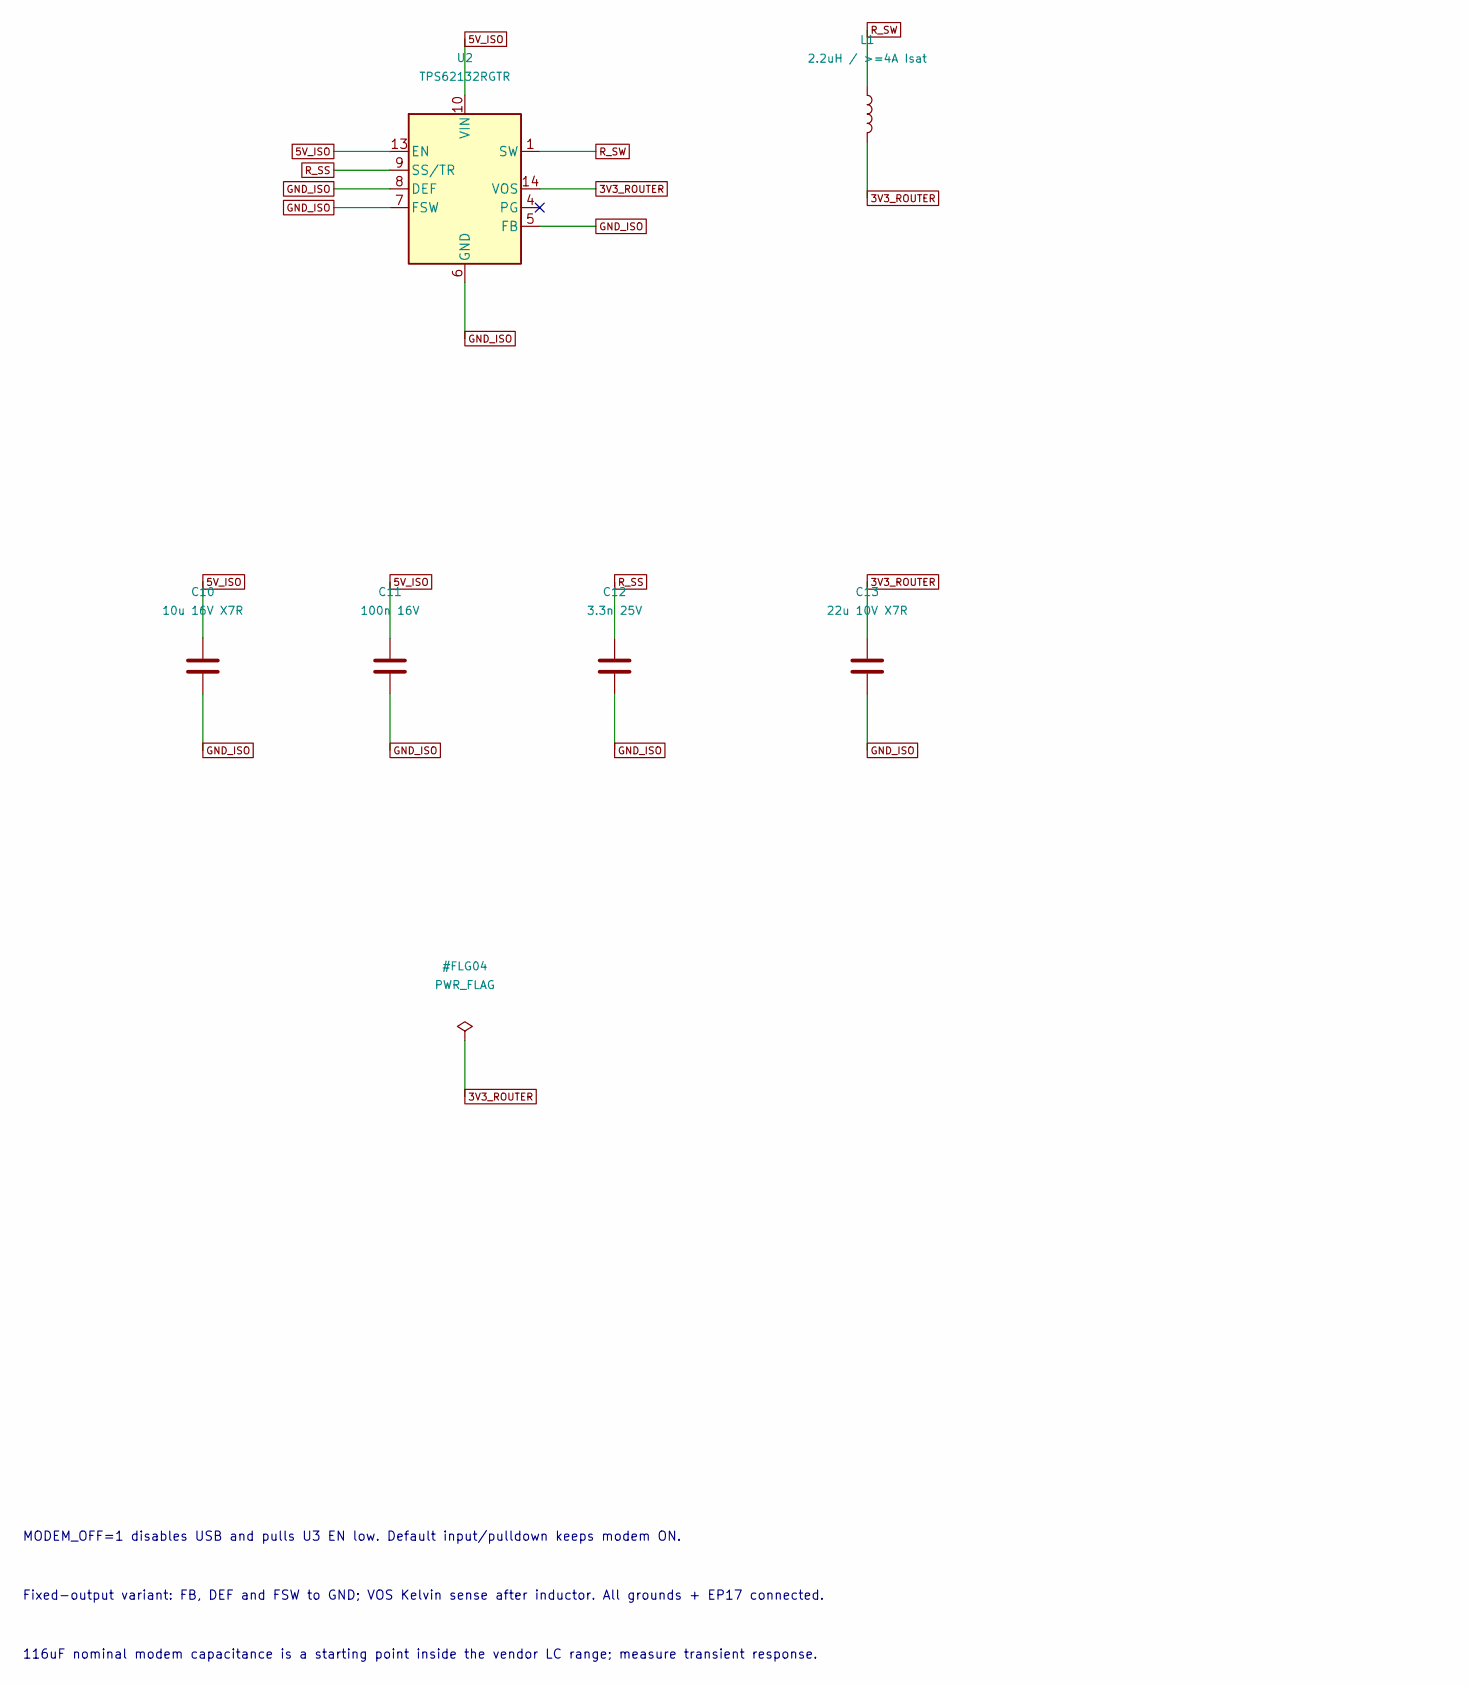
[picture p92: schematic 02_dc_power.kicad_sch, part in row 1, column 1]

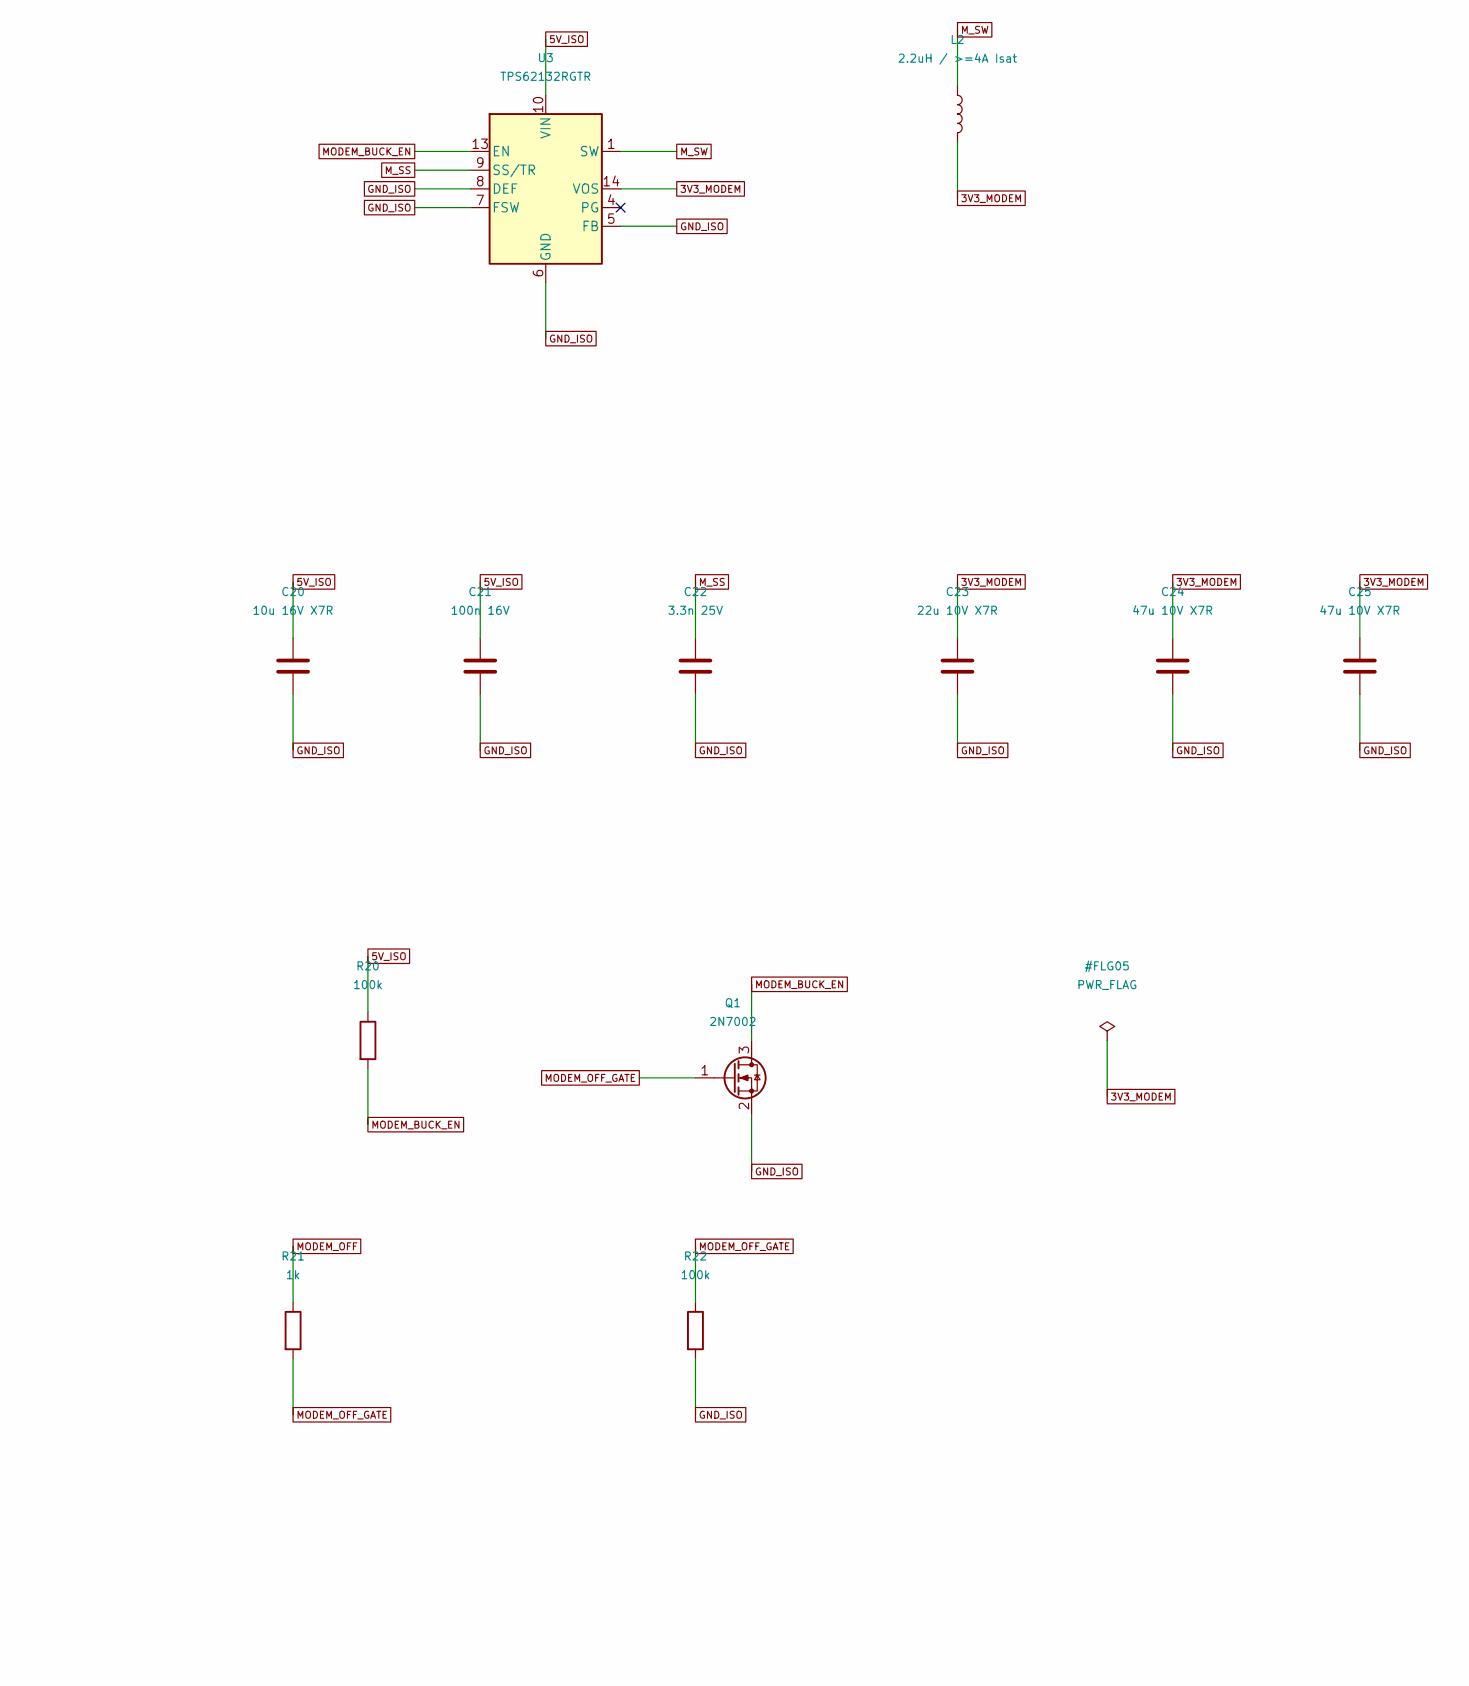
[picture p93: schematic 02_dc_power.kicad_sch, part in row 1, column 2]

Parts:
C10, C20: 10u 16V X7R; C_0805_2012Metric; MPN 10u 16V X7R
C11, C21: 100n 16V; C_0603_1608Metric; MPN 100n 16V
C12, C22: 3.3n 25V; C_0603_1608Metric; MPN 3.3n 25V
C13, C23: 22u 10V X7R; C_0805_2012Metric; MPN 22u 10V X7R
C24, C25: 47u 10V X7R; C_1210_3225Metric; MPN 47u 10V X7R
L1, L2: 2.2uH / >=4A Isat; L_Coilcraft_XxL4020; MPN XFL4020-222MEB
Q1: 2N7002; SOT-23; MPN 2N7002
R20, R22: 100k; R_0603_1608Metric; MPN 100k
R21: 1k; R_0603_1608Metric; MPN 1k
U2, U3: TPS62132RGTR; VQFN-16-1EP_3x3mm_P0.5mm_EP1.68x1.68mm_ThermalVias; MPN TPS62132RGTR

Connections:
3V3_MODEM: C23.1, C24.1, C25.1, L2.2, U3.14 (VOS)
3V3_ROUTER: C13.1, L1.2, U2.14 (VOS)
5V_ISO: C10.1, C11.1, C20.1, C21.1, R20.1, U2.10 (VIN), U2.11 (VIN), U2.12 (VIN), U2.13 (EN), U3.10 (VIN), U3.11 (VIN), U3.12 (VIN)
GND_ISO: C10.2, C11.2, C12.2, C13.2, C20.2, C21.2, C22.2, C23.2, C24.2, C25.2, Q1.2 (S), R22.2, U2.5 (FB), U2.6 (GND), U2.7 (FSW), U2.8 (DEF), U2.15 (GND), U2.16 (GND), U2.17 (GND), U3.5 (FB), U3.6 (GND), U3.7 (FSW), U3.8 (DEF), U3.15 (GND), U3.16 (GND), U3.17 (GND)
MODEM_BUCK_EN: Q1.3 (D), R20.2, U3.13 (EN)
MODEM_OFF: R21.1
MODEM_OFF_GATE: Q1.1 (G), R21.2, R22.1
M_SS: C22.1, U3.9 (SS/TR)
M_SW: L2.1, U3.1 (SW), U3.2 (SW), U3.3 (SW)
R_SS: C12.1, U2.9 (SS/TR)
R_SW: L1.1, U2.1 (SW), U2.2 (SW), U2.3 (SW)

Notes on the sheet:
MODEM_OFF=1 disables USB and pulls U3 EN low. Default input/pulldown keeps modem ON.
Fixed-output variant: FB, DEF and FSW to GND; VOS Kelvin sense after inductor. All grounds + EP17 connected.
116uF nominal modem capacitance is a starting point inside the vendor LC range; measure transient response.
