samd-atlantis/A-14329-RG-Atlantis-Modem/hardware/rev-a/kicad/03_router_control.kicad_sch

## KiCad design hardware/rev-a/kicad/03_router_control.kicad_sch (2026-10-29)

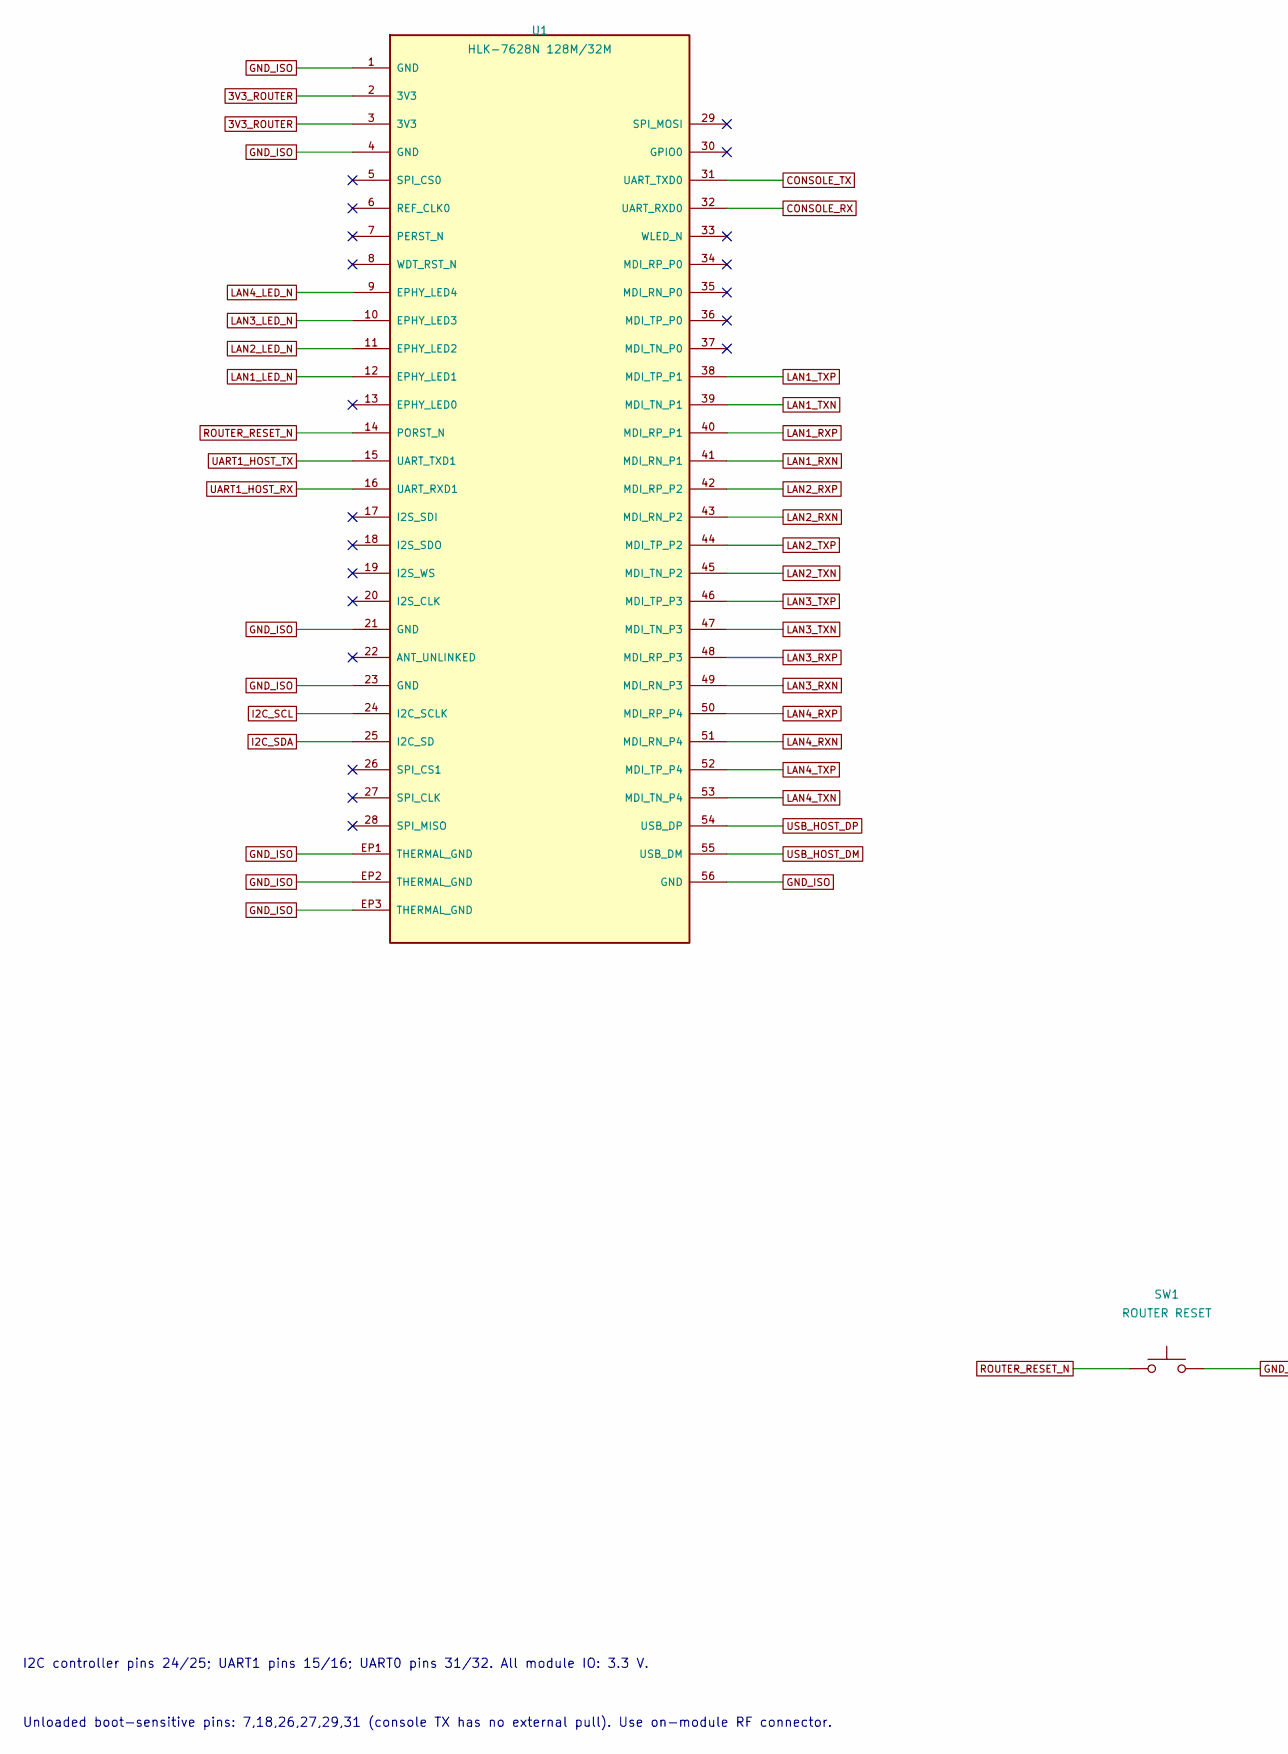
[picture p94: schematic 03_router_control.kicad_sch, part in row 1, column 1]

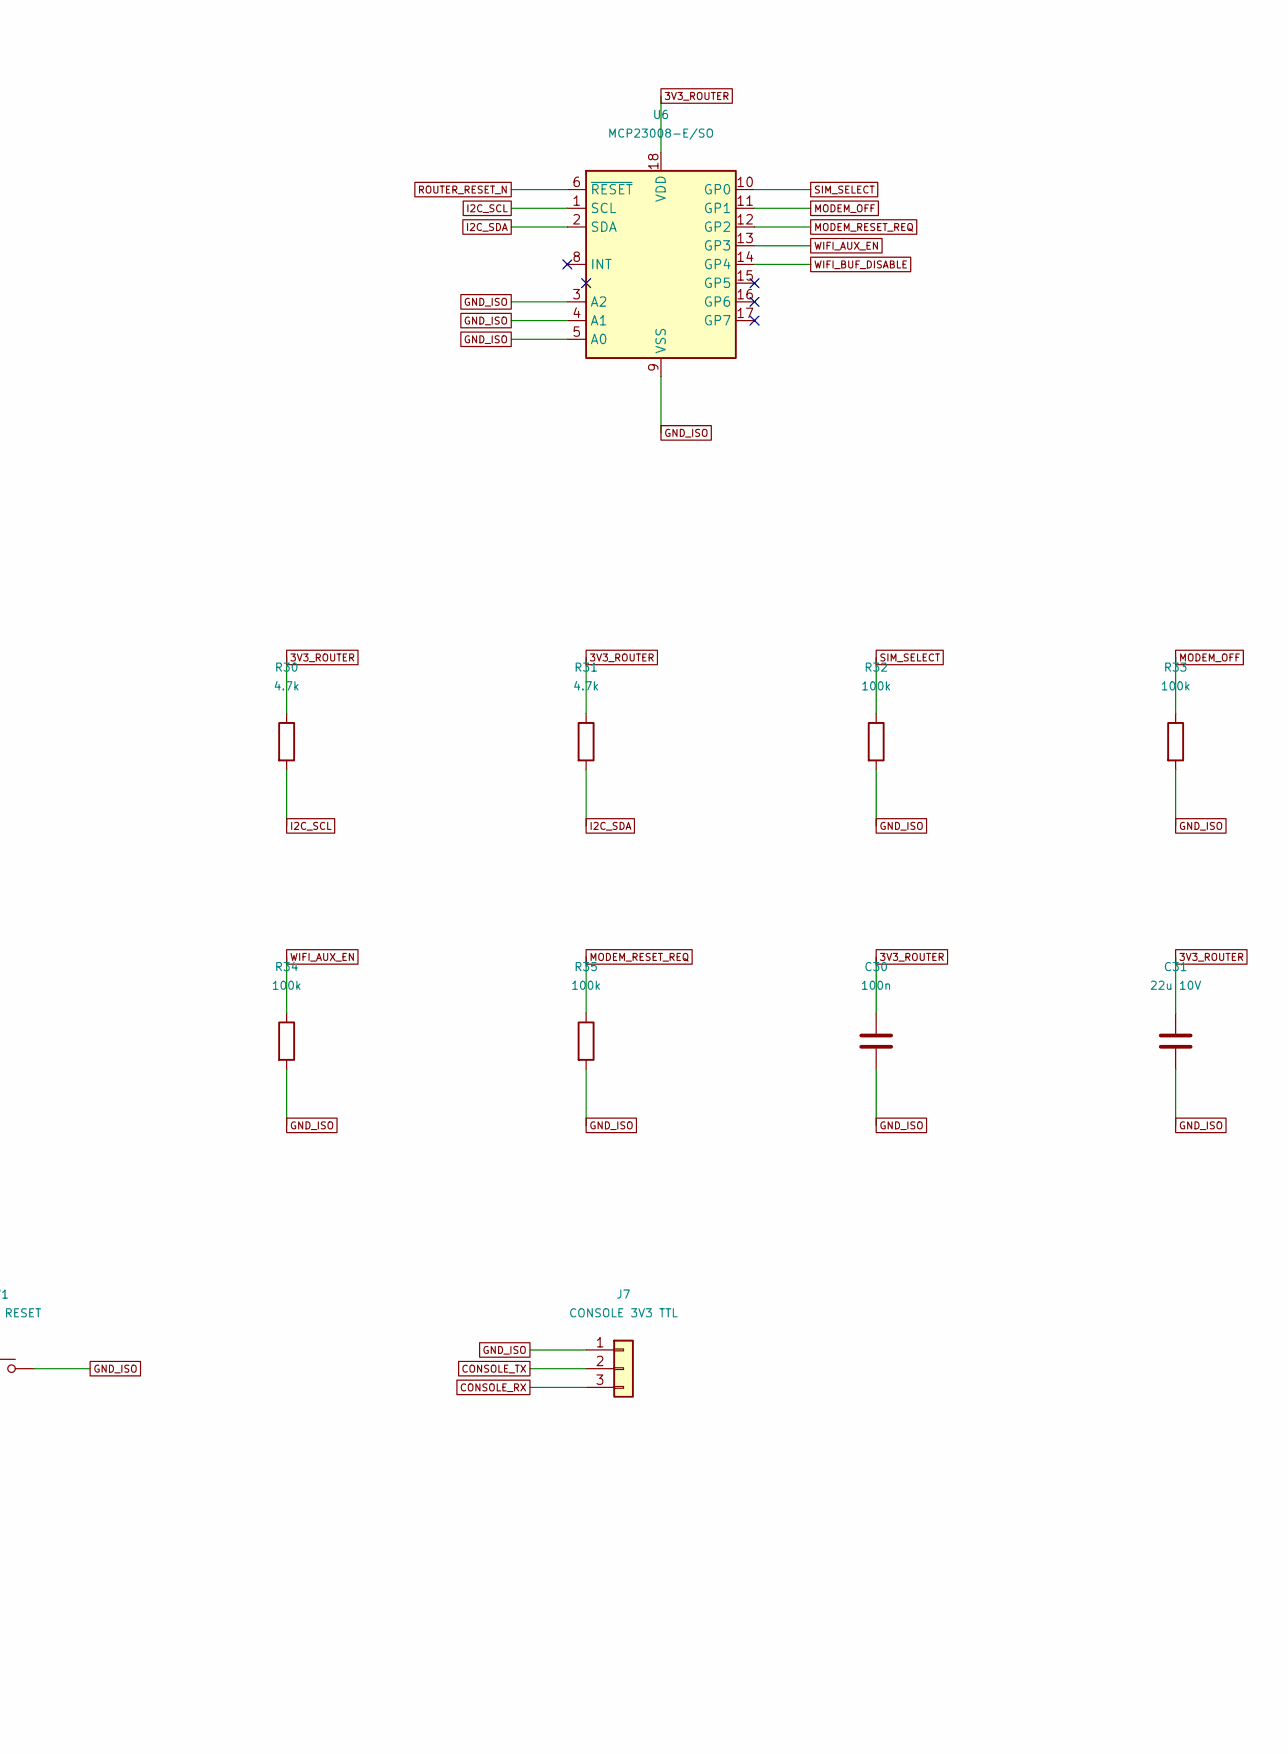
[picture p95: schematic 03_router_control.kicad_sch, part in row 1, column 2]

Parts:
C30: 100n; C_0603_1608Metric; MPN 100n
C31: 22u 10V; C_0805_2012Metric; MPN 22u 10V
J7: CONSOLE 3V3 TTL; PinHeader_1x03_P2.54mm_Vertical; MPN CONSOLE 3V3 TTL
R30, R31: 4.7k; R_0603_1608Metric; MPN 4.7k
R32, R33, R34, R35: 100k; R_0603_1608Metric; MPN 100k
SW1: ROUTER RESET; SW_SPST_TL3342; MPN ROUTER RESET
U1: HLK-7628N 128M/32M; HLK7628N_56; MPN HLK-7628N 128M/32M
U6: MCP23008-E/SO; SOIC-18W_7.5x11.6mm_P1.27mm; MPN MCP23008-E/SO

Connections:
3V3_ROUTER: C30.1, C31.1, R30.1, R31.1, U1.2 (3V3), U1.3 (3V3), U6.18 (VDD)
CONSOLE_RX: J7.3, U1.32 (UART_RXD0)
CONSOLE_TX: J7.2, U1.31 (UART_TXD0)
GND_ISO: C30.2, C31.2, J7.1, R32.2, R33.2, R34.2, R35.2, SW1.2, U1.1 (GND), U1.4 (GND), U1.21 (GND), U1.23 (GND), U1.56 (GND), U1.EP1 (THERMAL_GND), U1.EP2 (THERMAL_GND), U1.EP3 (THERMAL_GND), U6.3 (A2), U6.4 (A1), U6.5 (A0), U6.9 (VSS)
I2C_SCL: R30.2, U1.24 (I2C_SCLK), U6.1 (SCL)
I2C_SDA: R31.2, U1.25 (I2C_SD), U6.2 (SDA)
LAN1_LED_N: U1.12 (EPHY_LED1)
LAN1_RXN: U1.41 (MDI_RN_P1)
LAN1_RXP: U1.40 (MDI_RP_P1)
LAN1_TXN: U1.39 (MDI_TN_P1)
LAN1_TXP: U1.38 (MDI_TP_P1)
LAN2_LED_N: U1.11 (EPHY_LED2)
LAN2_RXN: U1.43 (MDI_RN_P2)
LAN2_RXP: U1.42 (MDI_RP_P2)
LAN2_TXN: U1.45 (MDI_TN_P2)
LAN2_TXP: U1.44 (MDI_TP_P2)
LAN3_LED_N: U1.10 (EPHY_LED3)
LAN3_RXN: U1.49 (MDI_RN_P3)
LAN3_RXP: U1.48 (MDI_RP_P3)
LAN3_TXN: U1.47 (MDI_TN_P3)
LAN3_TXP: U1.46 (MDI_TP_P3)
LAN4_LED_N: U1.9 (EPHY_LED4)
LAN4_RXN: U1.51 (MDI_RN_P4)
LAN4_RXP: U1.50 (MDI_RP_P4)
LAN4_TXN: U1.53 (MDI_TN_P4)
LAN4_TXP: U1.52 (MDI_TP_P4)
MODEM_OFF: R33.1, U6.11 (GP1)
MODEM_RESET_REQ: R35.1, U6.12 (GP2)
ROUTER_RESET_N: SW1.1, U1.14 (PORST_N), U6.6 (~RESET)
SIM_SELECT: R32.1, U6.10 (GP0)
UART1_HOST_RX: U1.16 (UART_RXD1)
UART1_HOST_TX: U1.15 (UART_TXD1)
USB_HOST_DM: U1.55 (USB_DM)
USB_HOST_DP: U1.54 (USB_DP)
WIFI_AUX_EN: R34.1, U6.13 (GP3)
WIFI_BUF_DISABLE: U6.14 (GP4)

Notes on the sheet:
I2C controller pins 24/25; UART1 pins 15/16; UART0 pins 31/32. All module IO: 3.3 V.
Unloaded boot-sensitive pins: 7,18,26,27,29,31 (console TX has no external pull). Use on-module RF connector.
