samd-atlantis/A-14329-RG-Atlantis-Modem/hardware/rev-a/kicad/04_ethernet.kicad_sch

## KiCad design hardware/rev-a/kicad/04_ethernet.kicad_sch (2026-10-29)

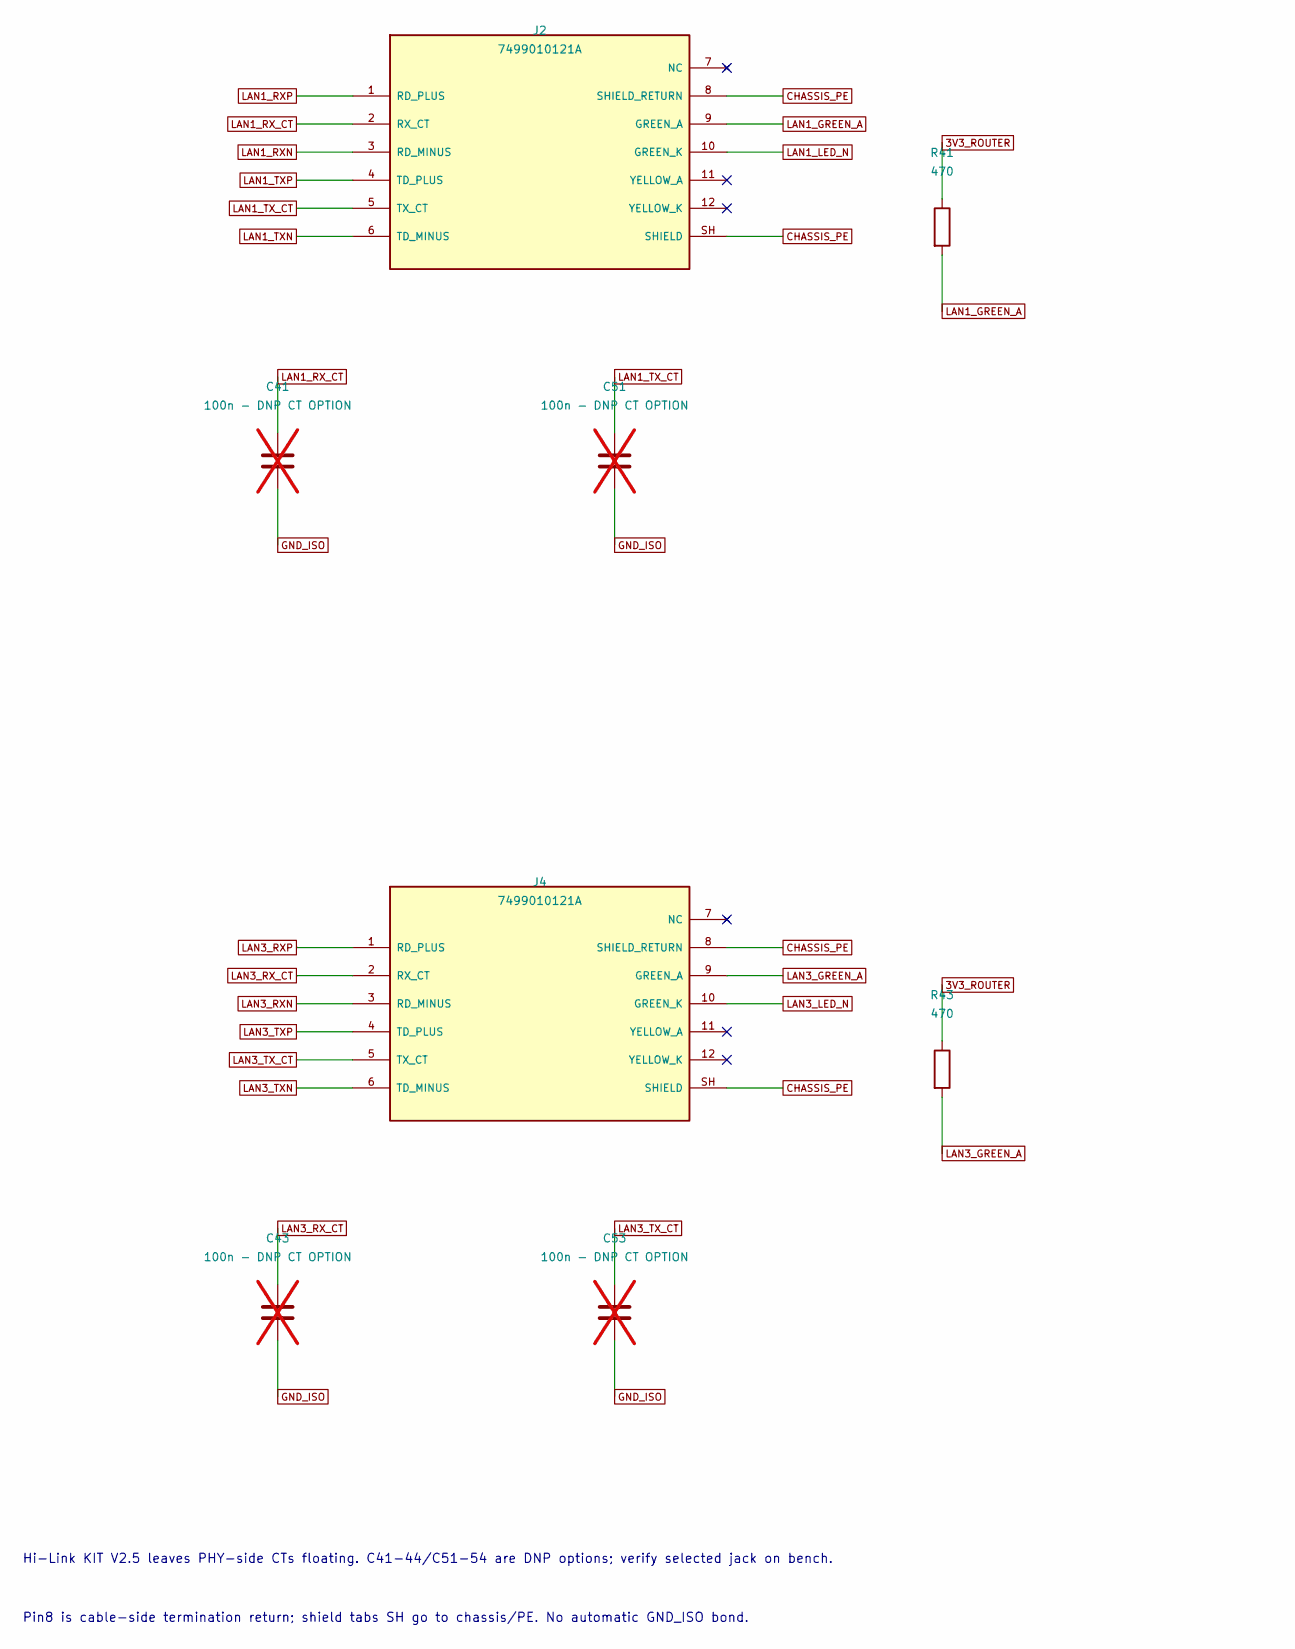
[picture p96: schematic 04_ethernet.kicad_sch, part in row 1, column 1]

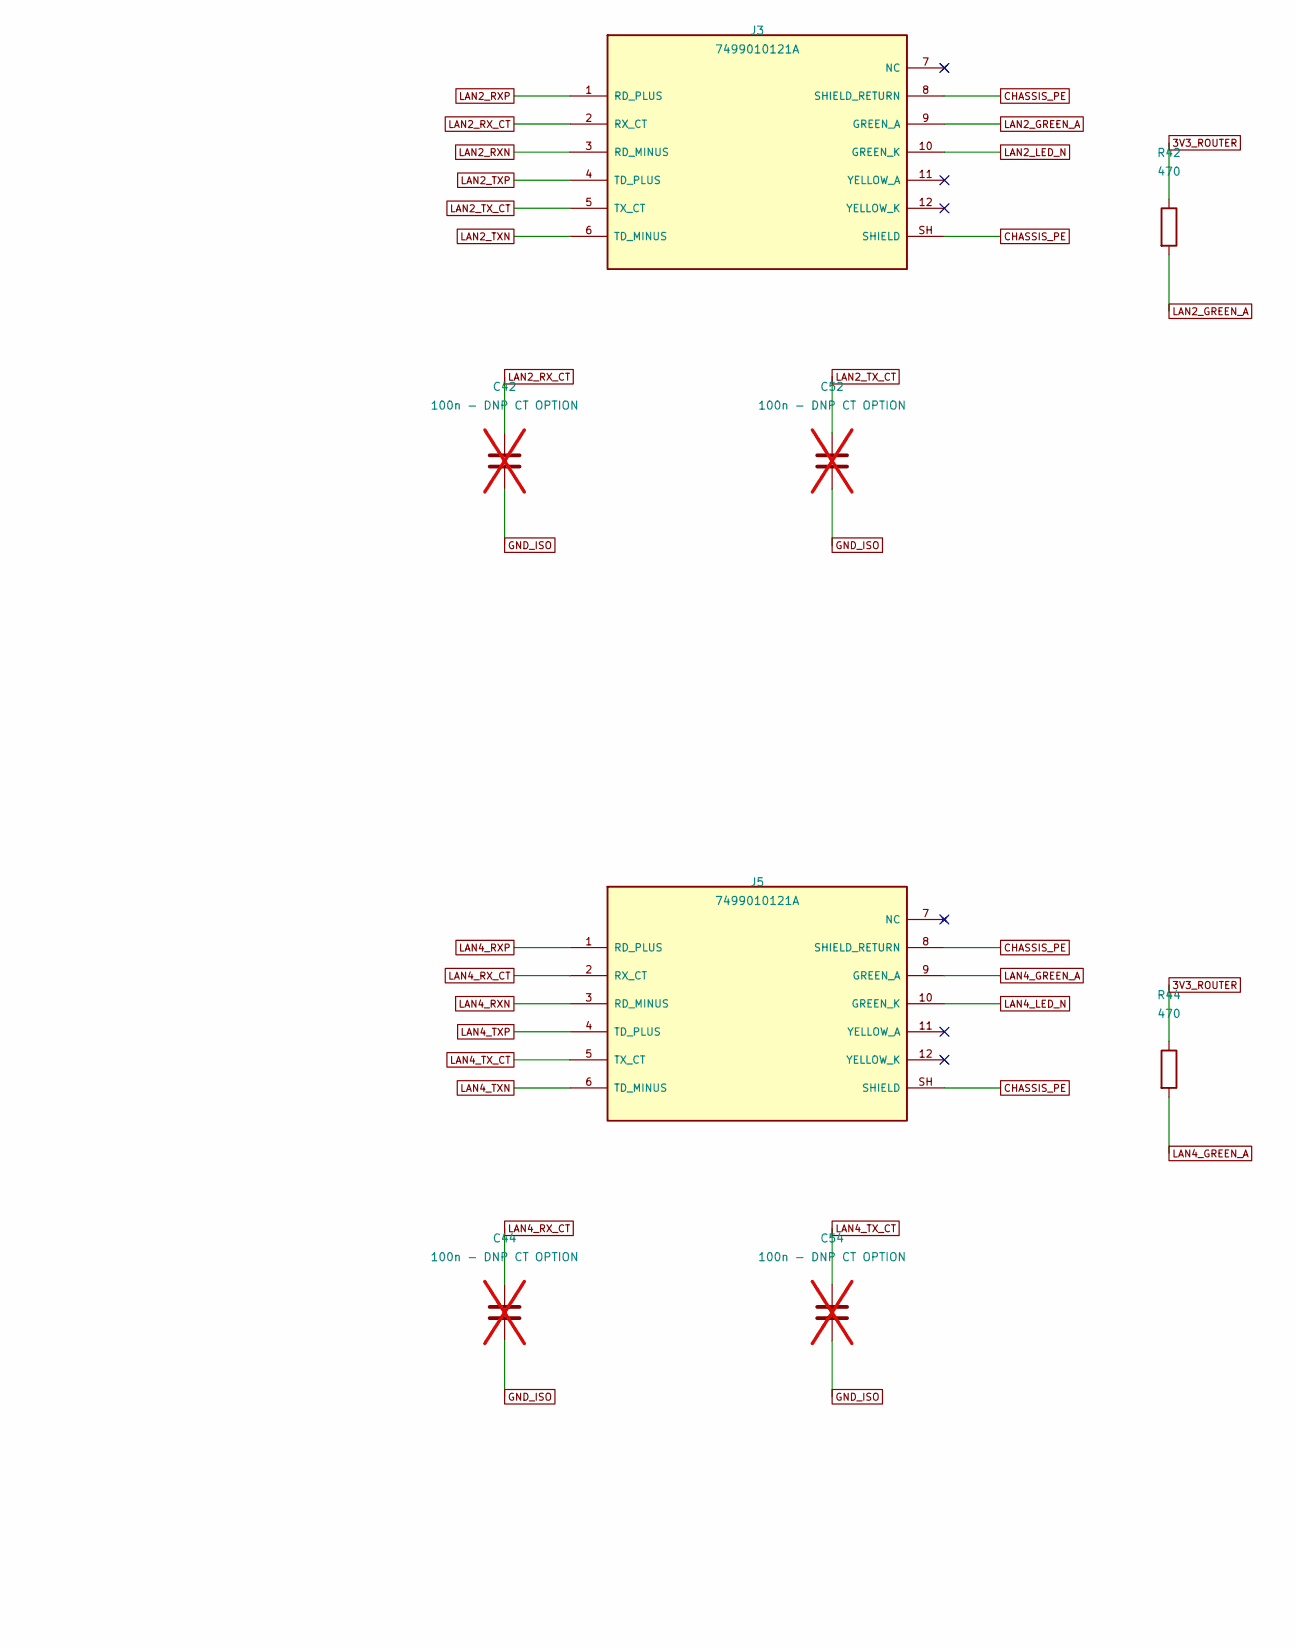
[picture p97: schematic 04_ethernet.kicad_sch, part in row 1, column 2]

Parts:
C41, C42, C43, C44, C51, C52, C53, C54: 100n - DNP CT OPTION; C_0603_1608Metric; MPN 100n - DNP CT OPTION; not fitted
J2, J3, J4, J5: 7499010121A; RJ45_Wuerth_7499010121A_Horizontal; MPN 7499010121A
R41, R42, R43, R44: 470; R_0603_1608Metric; MPN 470

Connections:
3V3_ROUTER: R41.1, R42.1, R43.1, R44.1
CHASSIS_PE: J2.8 (SHIELD_RETURN), J2.SH (SHIELD), J3.8 (SHIELD_RETURN), J3.SH (SHIELD), J4.8 (SHIELD_RETURN), J4.SH (SHIELD), J5.8 (SHIELD_RETURN), J5.SH (SHIELD)
GND_ISO: C41.2, C42.2, C43.2, C44.2, C51.2, C52.2, C53.2, C54.2
LAN1_GREEN_A: J2.9 (GREEN_A), R41.2
LAN1_LED_N: J2.10 (GREEN_K)
LAN1_RXN: J2.3 (RD_MINUS)
LAN1_RXP: J2.1 (RD_PLUS)
LAN1_RX_CT: C41.1, J2.2 (RX_CT)
LAN1_TXN: J2.6 (TD_MINUS)
LAN1_TXP: J2.4 (TD_PLUS)
LAN1_TX_CT: C51.1, J2.5 (TX_CT)
LAN2_GREEN_A: J3.9 (GREEN_A), R42.2
LAN2_LED_N: J3.10 (GREEN_K)
LAN2_RXN: J3.3 (RD_MINUS)
LAN2_RXP: J3.1 (RD_PLUS)
LAN2_RX_CT: C42.1, J3.2 (RX_CT)
LAN2_TXN: J3.6 (TD_MINUS)
LAN2_TXP: J3.4 (TD_PLUS)
LAN2_TX_CT: C52.1, J3.5 (TX_CT)
LAN3_GREEN_A: J4.9 (GREEN_A), R43.2
LAN3_LED_N: J4.10 (GREEN_K)
LAN3_RXN: J4.3 (RD_MINUS)
LAN3_RXP: J4.1 (RD_PLUS)
LAN3_RX_CT: C43.1, J4.2 (RX_CT)
LAN3_TXN: J4.6 (TD_MINUS)
LAN3_TXP: J4.4 (TD_PLUS)
LAN3_TX_CT: C53.1, J4.5 (TX_CT)
LAN4_GREEN_A: J5.9 (GREEN_A), R44.2
LAN4_LED_N: J5.10 (GREEN_K)
LAN4_RXN: J5.3 (RD_MINUS)
LAN4_RXP: J5.1 (RD_PLUS)
LAN4_RX_CT: C44.1, J5.2 (RX_CT)
LAN4_TXN: J5.6 (TD_MINUS)
LAN4_TXP: J5.4 (TD_PLUS)
LAN4_TX_CT: C54.1, J5.5 (TX_CT)

Notes on the sheet:
Hi-Link KIT V2.5 leaves PHY-side CTs floating. C41-44/C51-54 are DNP options; verify selected jack on bench.
Pin8 is cable-side termination return; shield tabs SH go to chassis/PE. No automatic GND_ISO bond.
