samd-atlantis/A-14329-RG-Atlantis-Modem/hardware/rev-a/kicad/05_cellular_usb.kicad_sch

## KiCad design hardware/rev-a/kicad/05_cellular_usb.kicad_sch (2026-10-29)

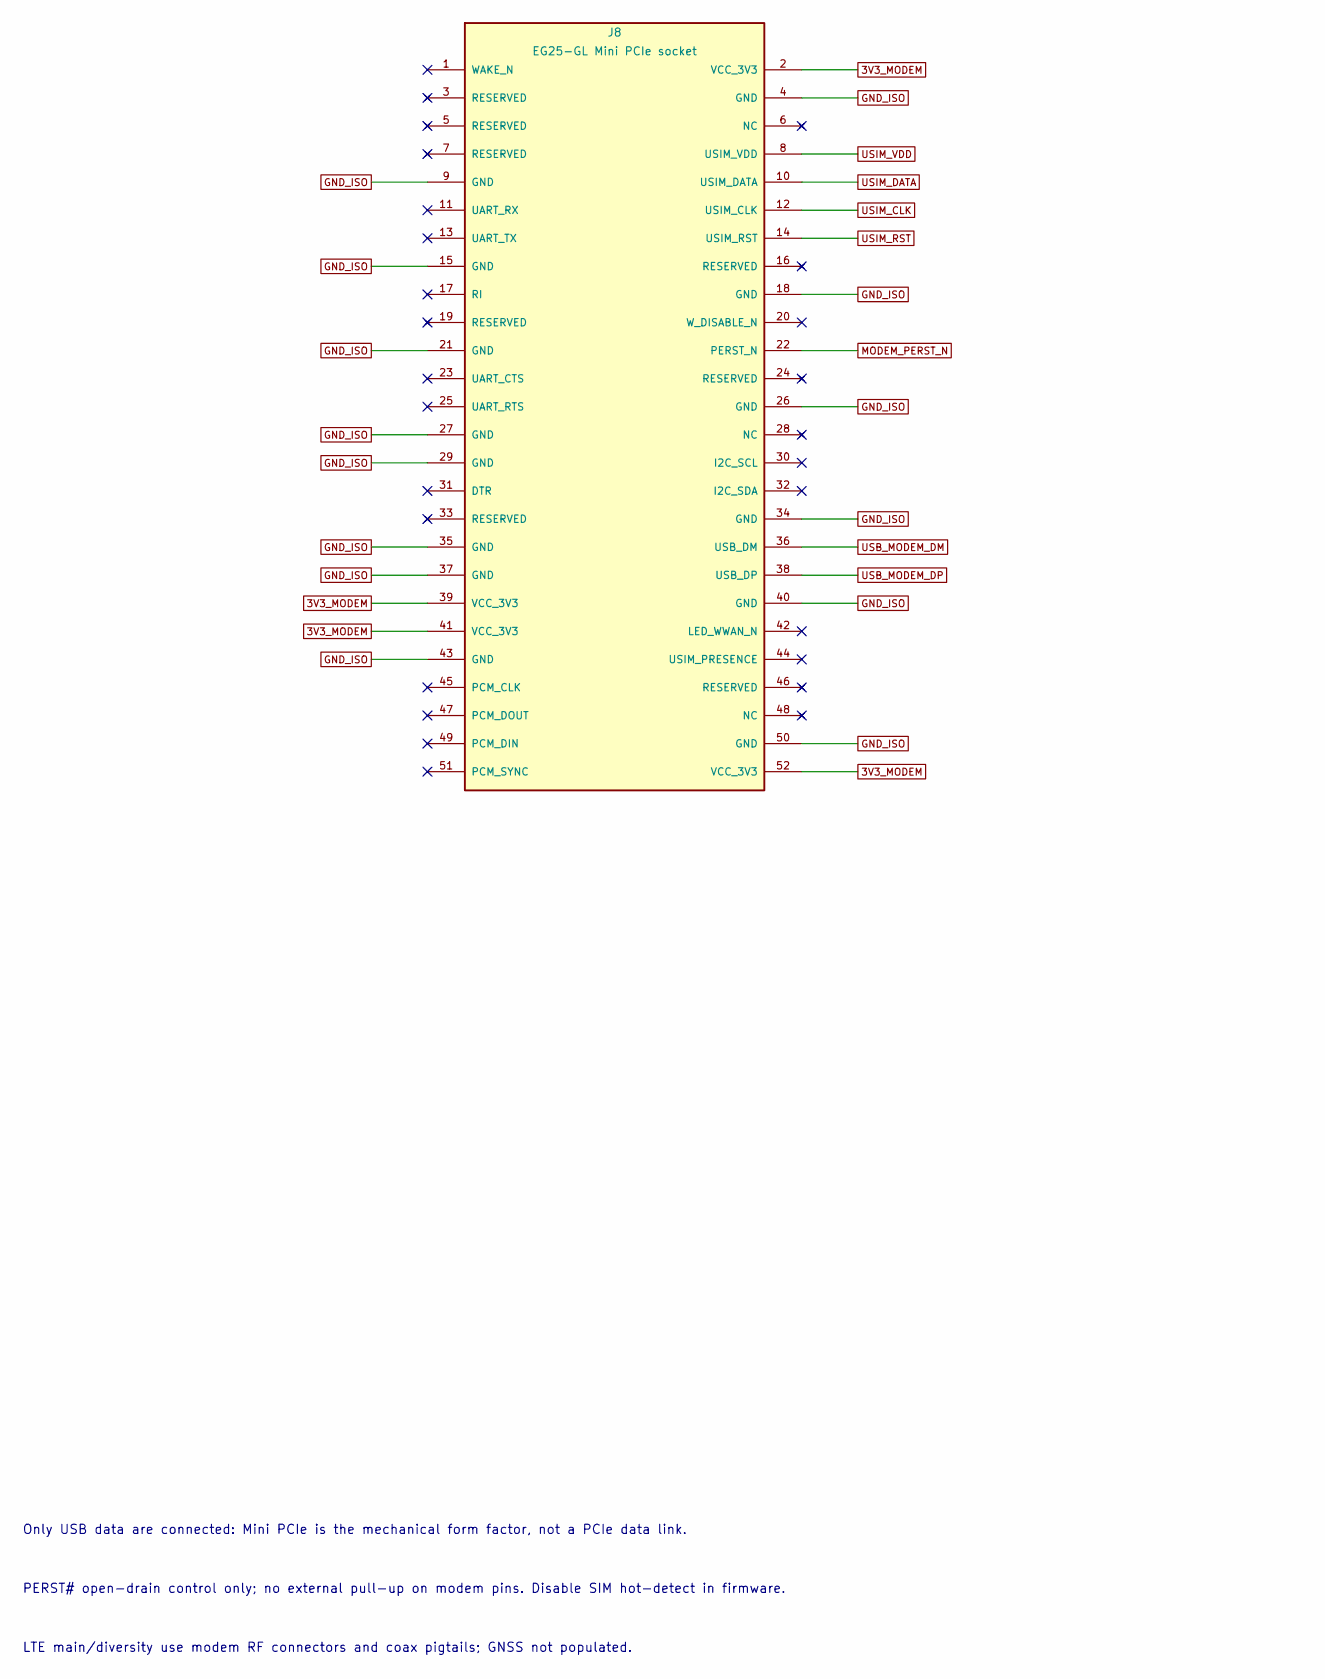
[picture p98: schematic 05_cellular_usb.kicad_sch, part in row 1, column 1]

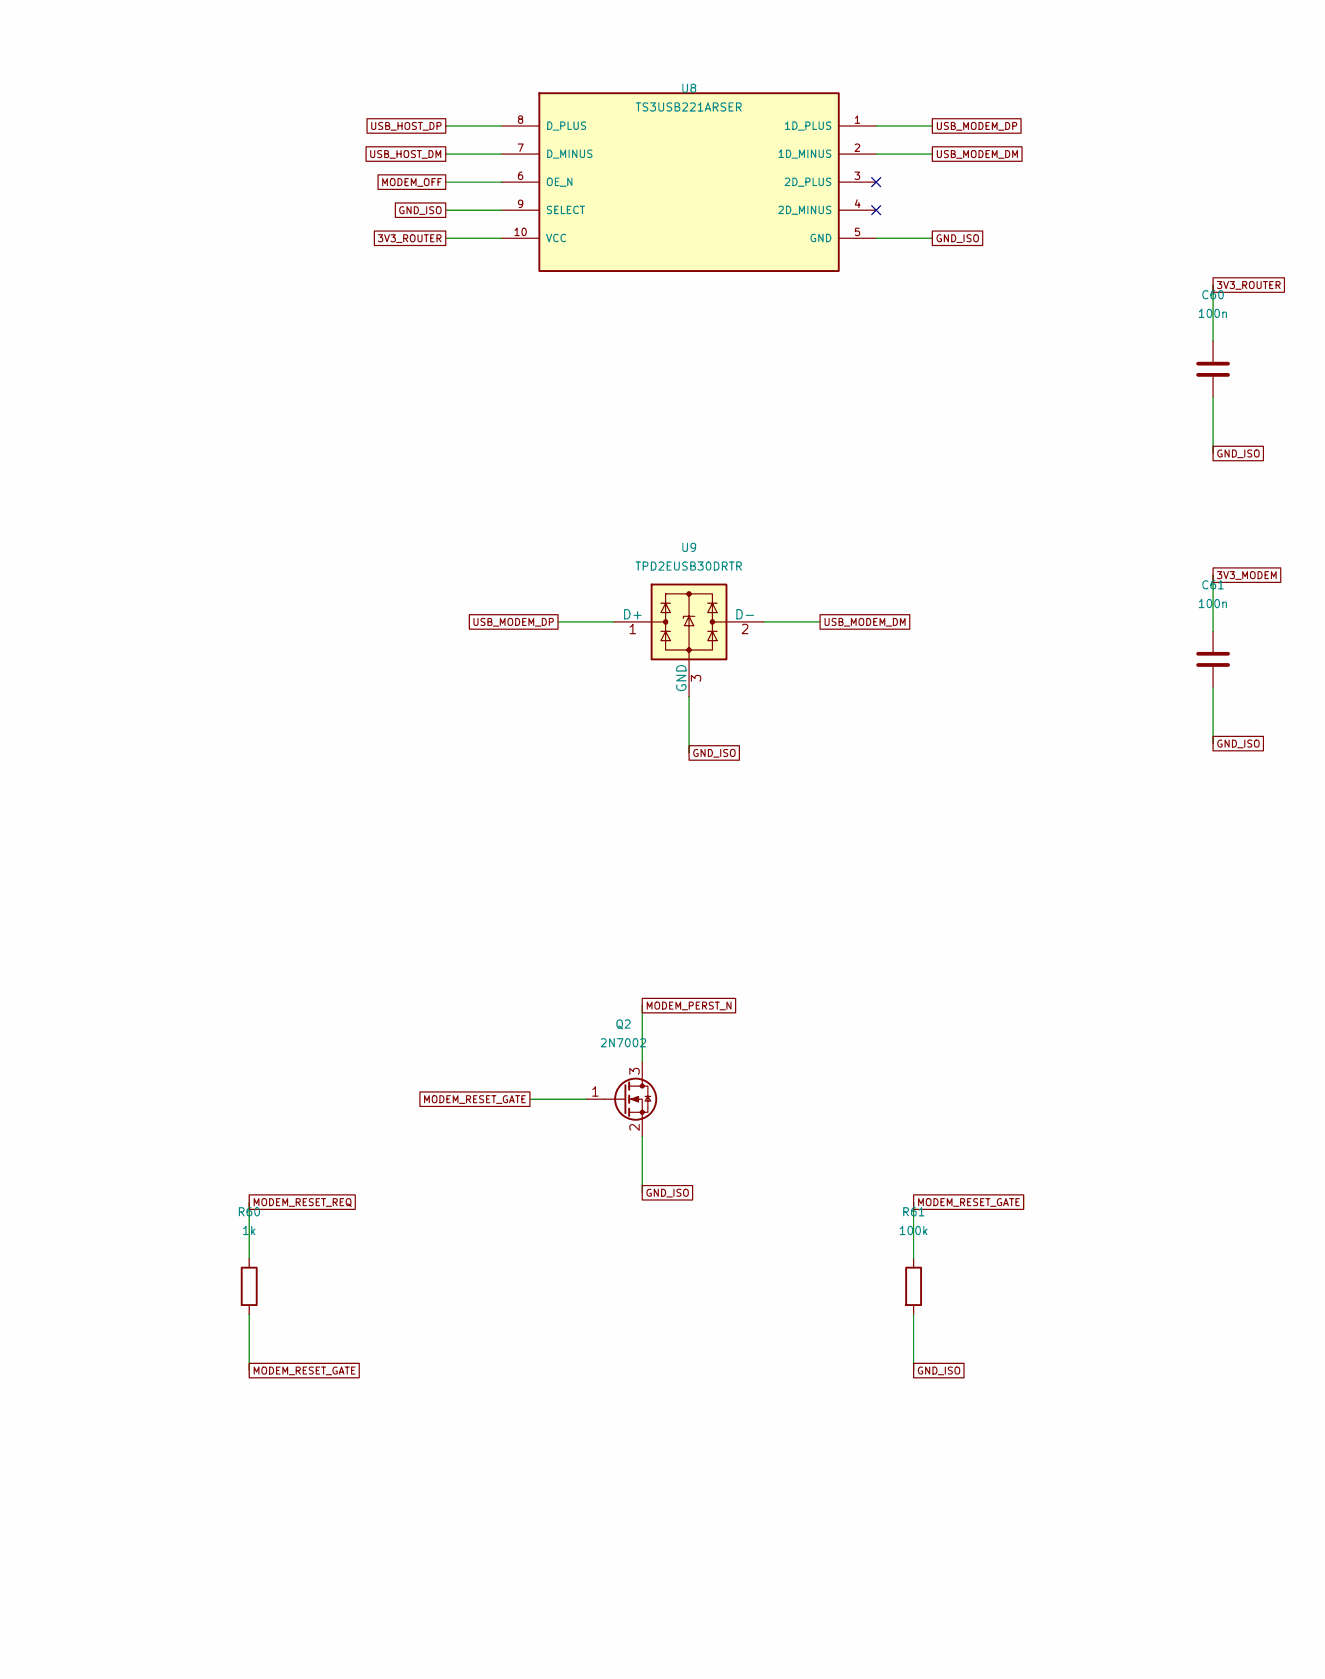
[picture p99: schematic 05_cellular_usb.kicad_sch, part in row 1, column 2]

Parts:
C60, C61: 100n; C_0603_1608Metric; MPN 100n
J8: EG25-GL Mini PCIe socket; MPN EG25-GL Mini PCIe socket
Q2: 2N7002; SOT-23; MPN 2N7002
R60: 1k; R_0603_1608Metric; MPN 1k
R61: 100k; R_0603_1608Metric; MPN 100k
U8: TS3USB221ARSER; MPN TS3USB221ARSER
U9: TPD2EUSB30DRTR; Texas_DRT-3; MPN TPD2EUSB30DRTR

Connections:
3V3_MODEM: C61.1, J8.2 (VCC_3V3), J8.39 (VCC_3V3), J8.41 (VCC_3V3), J8.52 (VCC_3V3)
3V3_ROUTER: C60.1, U8.10 (VCC)
GND_ISO: C60.2, C61.2, J8.4 (GND), J8.9 (GND), J8.15 (GND), J8.18 (GND), J8.21 (GND), J8.26 (GND), J8.27 (GND), J8.29 (GND), J8.34 (GND), J8.35 (GND), J8.37 (GND), J8.40 (GND), J8.43 (GND), J8.50 (GND), Q2.2 (S), R61.2, U8.5 (GND), U8.9 (SELECT), U9.3 (GND)
MODEM_OFF: U8.6 (OE_N)
MODEM_PERST_N: J8.22 (PERST_N), Q2.3 (D)
MODEM_RESET_GATE: Q2.1 (G), R60.2, R61.1
MODEM_RESET_REQ: R60.1
USB_HOST_DM: U8.7 (D_MINUS)
USB_HOST_DP: U8.8 (D_PLUS)
USB_MODEM_DM: J8.36 (USB_DM), U8.2 (1D_MINUS), U9.2 (D-)
USB_MODEM_DP: J8.38 (USB_DP), U8.1 (1D_PLUS), U9.1 (D+)
USIM_CLK: J8.12 (USIM_CLK)
USIM_DATA: J8.10 (USIM_DATA)
USIM_RST: J8.14 (USIM_RST)
USIM_VDD: J8.8 (USIM_VDD)

Notes on the sheet:
Only USB data are connected: Mini PCIe is the mechanical form factor, not a PCIe data link.
PERST# open-drain control only; no external pull-up on modem pins. Disable SIM hot-detect in firmware.
LTE main/diversity use modem RF connectors and coax pigtails; GNSS not populated.
