samd-atlantis/A-14329-RG-Atlantis-Modem/hardware/rev-a/kicad/06_sim_selection.kicad_sch

## KiCad design hardware/rev-a/kicad/06_sim_selection.kicad_sch (2026-10-29)

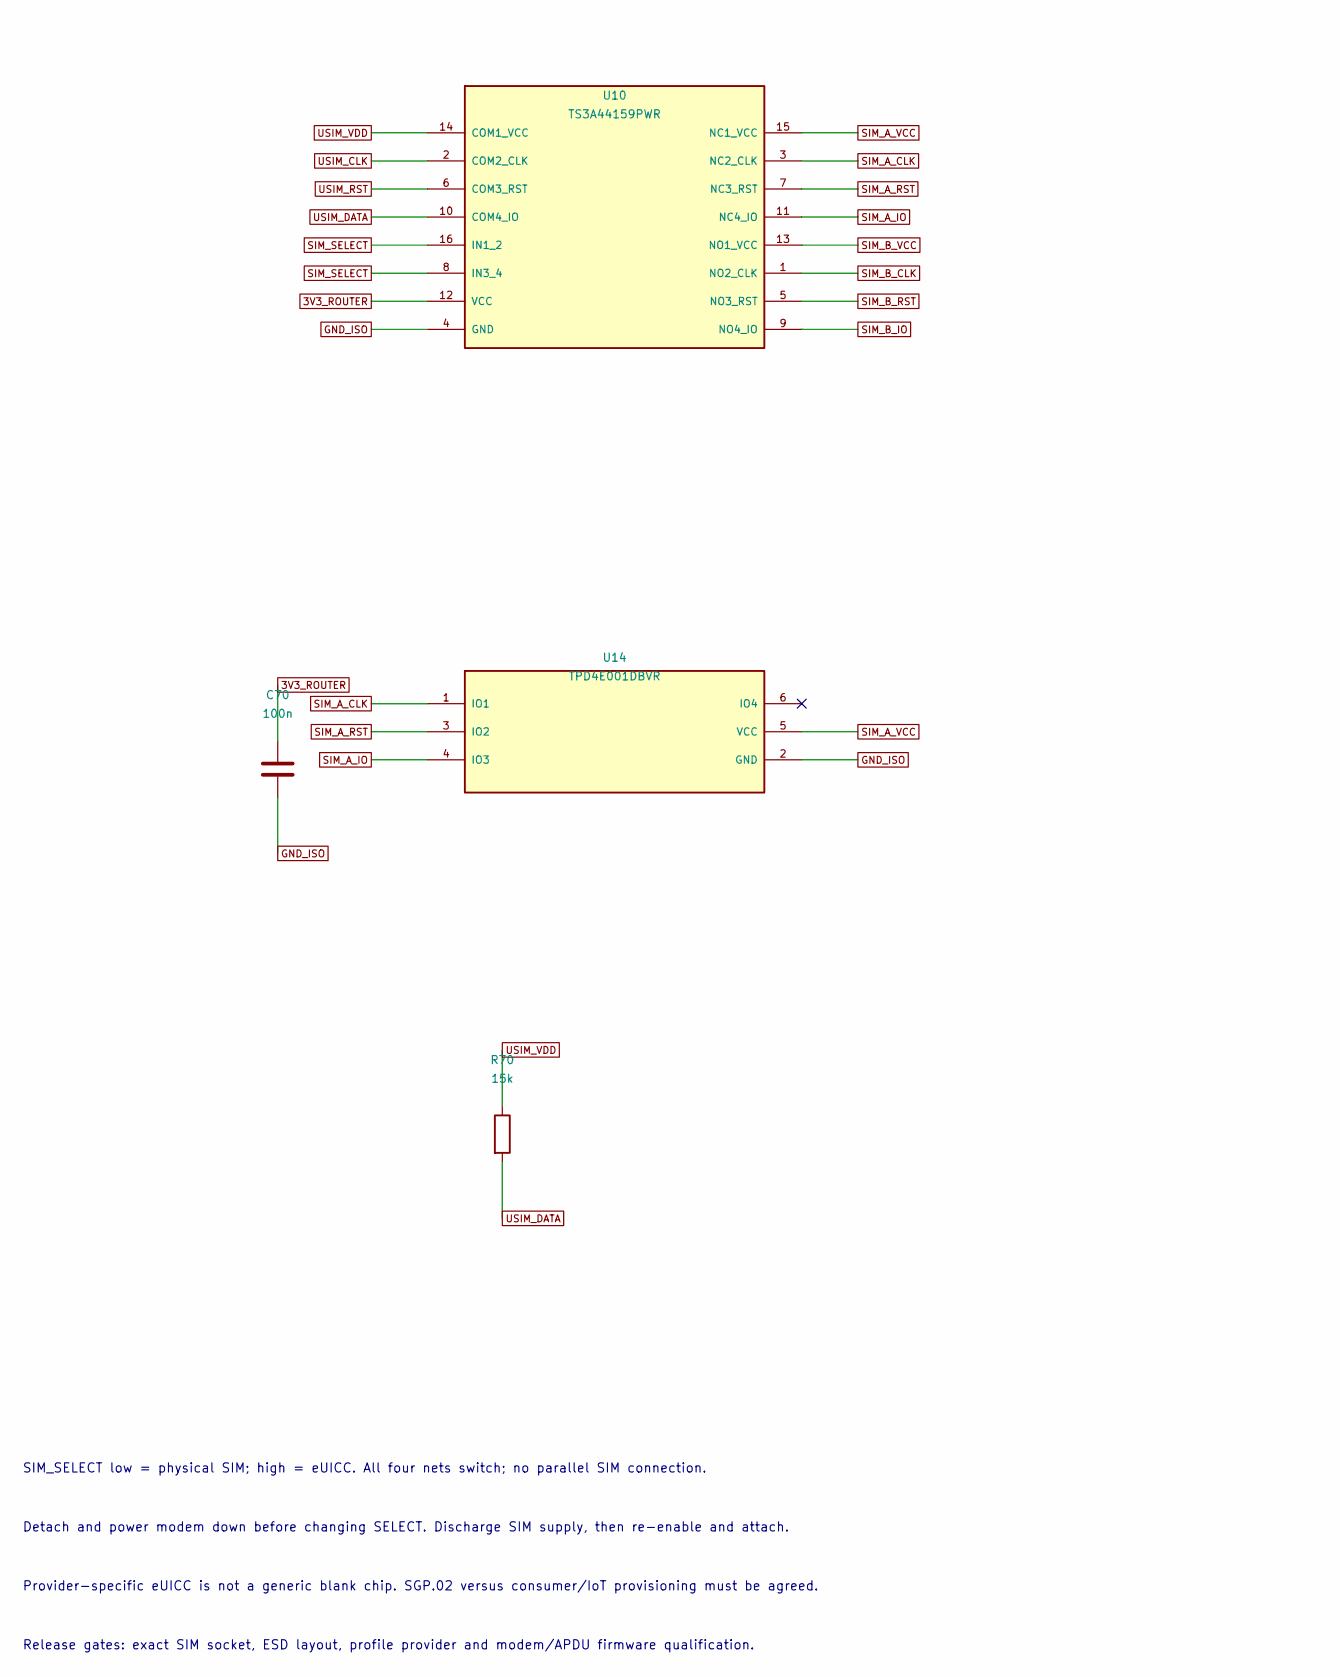
[picture p100: schematic 06_sim_selection.kicad_sch, part in row 1, column 1]

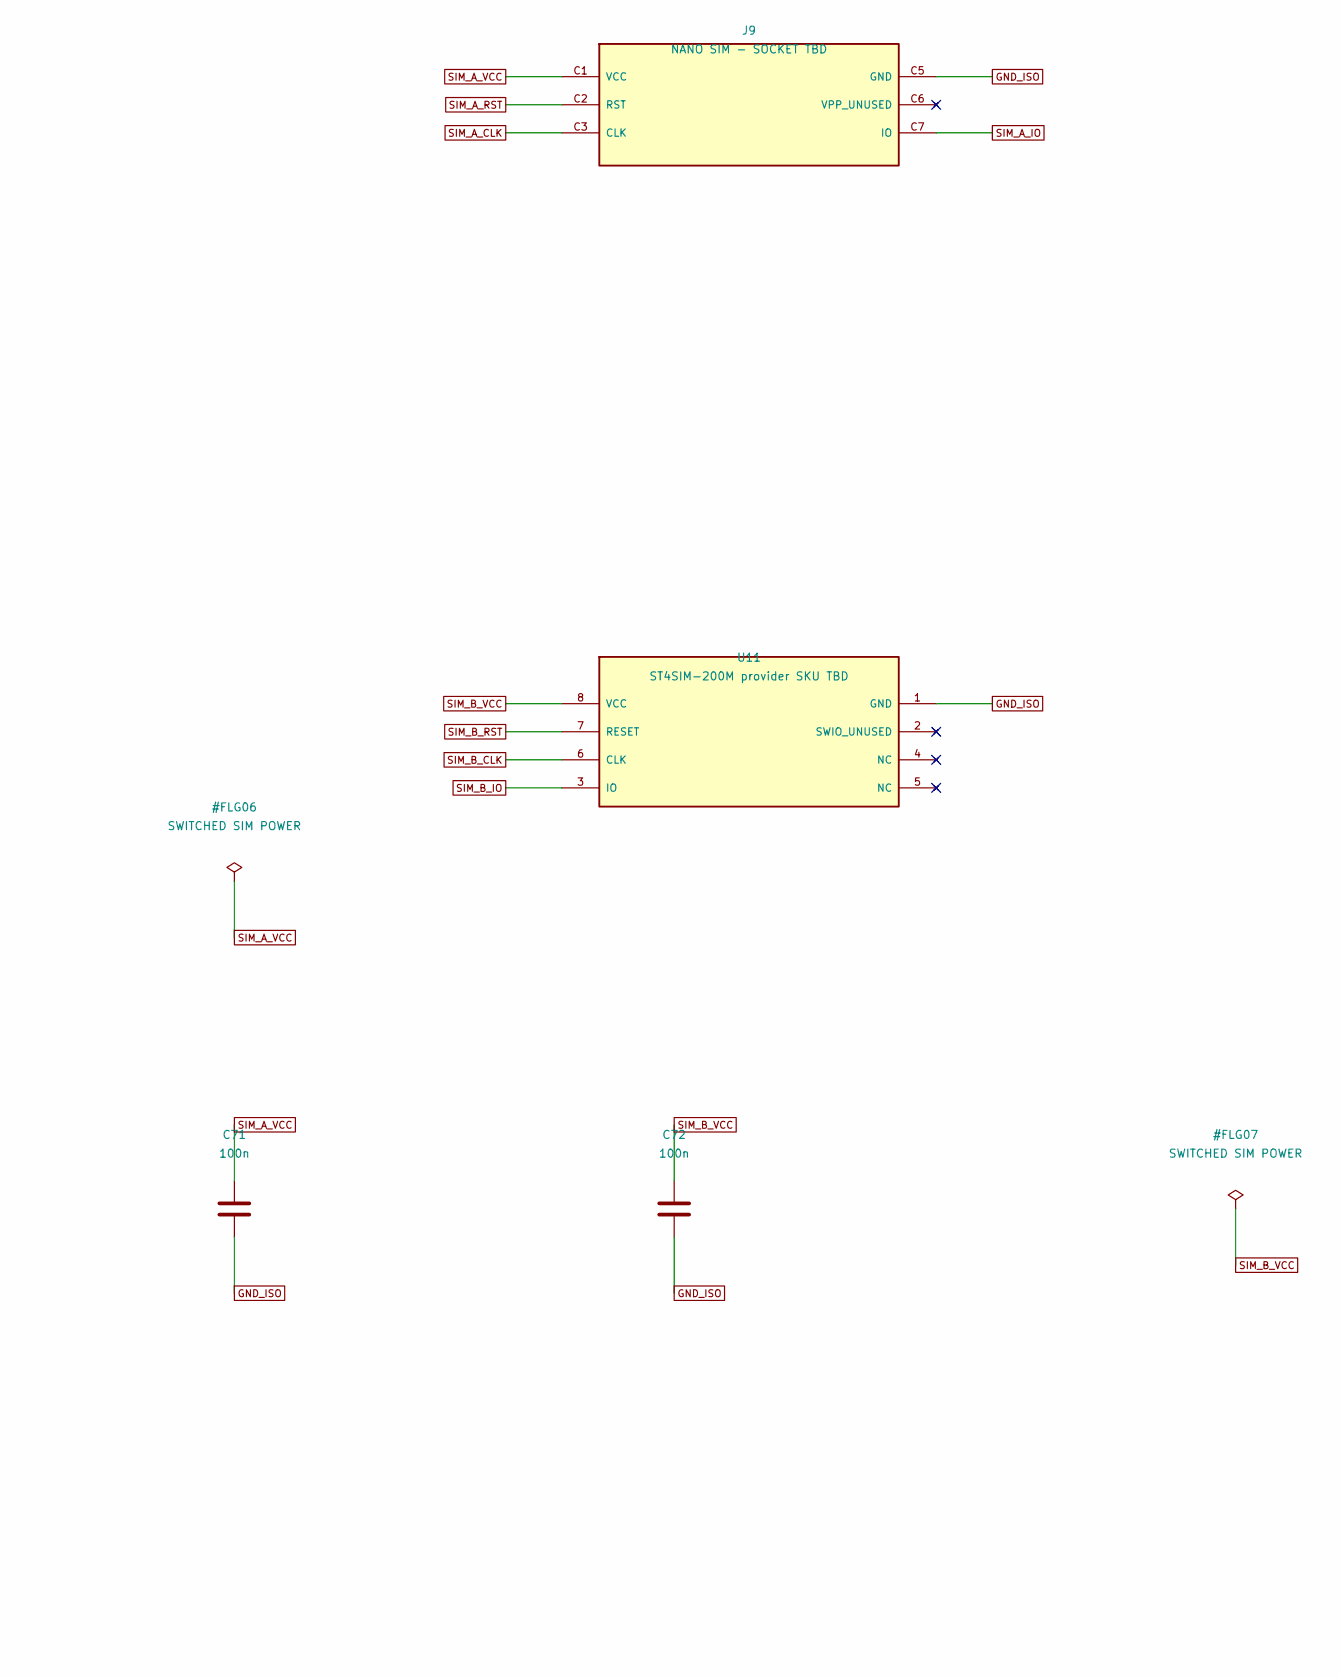
[picture p101: schematic 06_sim_selection.kicad_sch, part in row 1, column 2]

Parts:
C70, C71, C72: 100n; C_0603_1608Metric; MPN 100n
J9: NANO SIM - SOCKET TBD; MPN NANO SIM - SOCKET TBD
R70: 15k; R_0603_1608Metric; MPN 15k
U10: TS3A44159PWR; TSSOP-16_4.4x5mm_P0.65mm; MPN TS3A44159PWR
U11: ST4SIM-200M provider SKU TBD; MPN ST4SIM-200M provider SKU TBD
U14: TPD4E001DBVR; SOT-23-6; MPN TPD4E001DBVR

Connections:
3V3_ROUTER: C70.1, U10.12 (VCC)
GND_ISO: C70.2, C71.2, C72.2, J9.C5 (GND), U10.4 (GND), U11.1 (GND), U14.2 (GND)
SIM_A_CLK: J9.C3 (CLK), U10.3 (NC2_CLK), U14.1 (IO1)
SIM_A_IO: J9.C7 (IO), U10.11 (NC4_IO), U14.4 (IO3)
SIM_A_RST: J9.C2 (RST), U10.7 (NC3_RST), U14.3 (IO2)
SIM_A_VCC: C71.1, J9.C1 (VCC), U10.15 (NC1_VCC), U14.5 (VCC)
SIM_B_CLK: U10.1 (NO2_CLK), U11.6 (CLK)
SIM_B_IO: U10.9 (NO4_IO), U11.3 (IO)
SIM_B_RST: U10.5 (NO3_RST), U11.7 (RESET)
SIM_B_VCC: C72.1, U10.13 (NO1_VCC), U11.8 (VCC)
SIM_SELECT: U10.8 (IN3_4), U10.16 (IN1_2)
USIM_CLK: U10.2 (COM2_CLK)
USIM_DATA: R70.2, U10.10 (COM4_IO)
USIM_RST: U10.6 (COM3_RST)
USIM_VDD: R70.1, U10.14 (COM1_VCC)

Notes on the sheet:
SIM_SELECT low = physical SIM; high = eUICC. All four nets switch; no parallel SIM connection.
Detach and power modem down before changing SELECT. Discharge SIM supply, then re-enable and attach.
Provider-specific eUICC is not a generic blank chip. SGP.02 versus consumer/IoT provisioning must be agreed.
Release gates: exact SIM socket, ESD layout, profile provider and modem/APDU firmware qualification.
