samd-atlantis/A-14329-RG-Atlantis-Modem/hardware/rev-a/kicad/07_wifi_ble.kicad_sch

## KiCad design hardware/rev-a/kicad/07_wifi_ble.kicad_sch (2026-10-29)

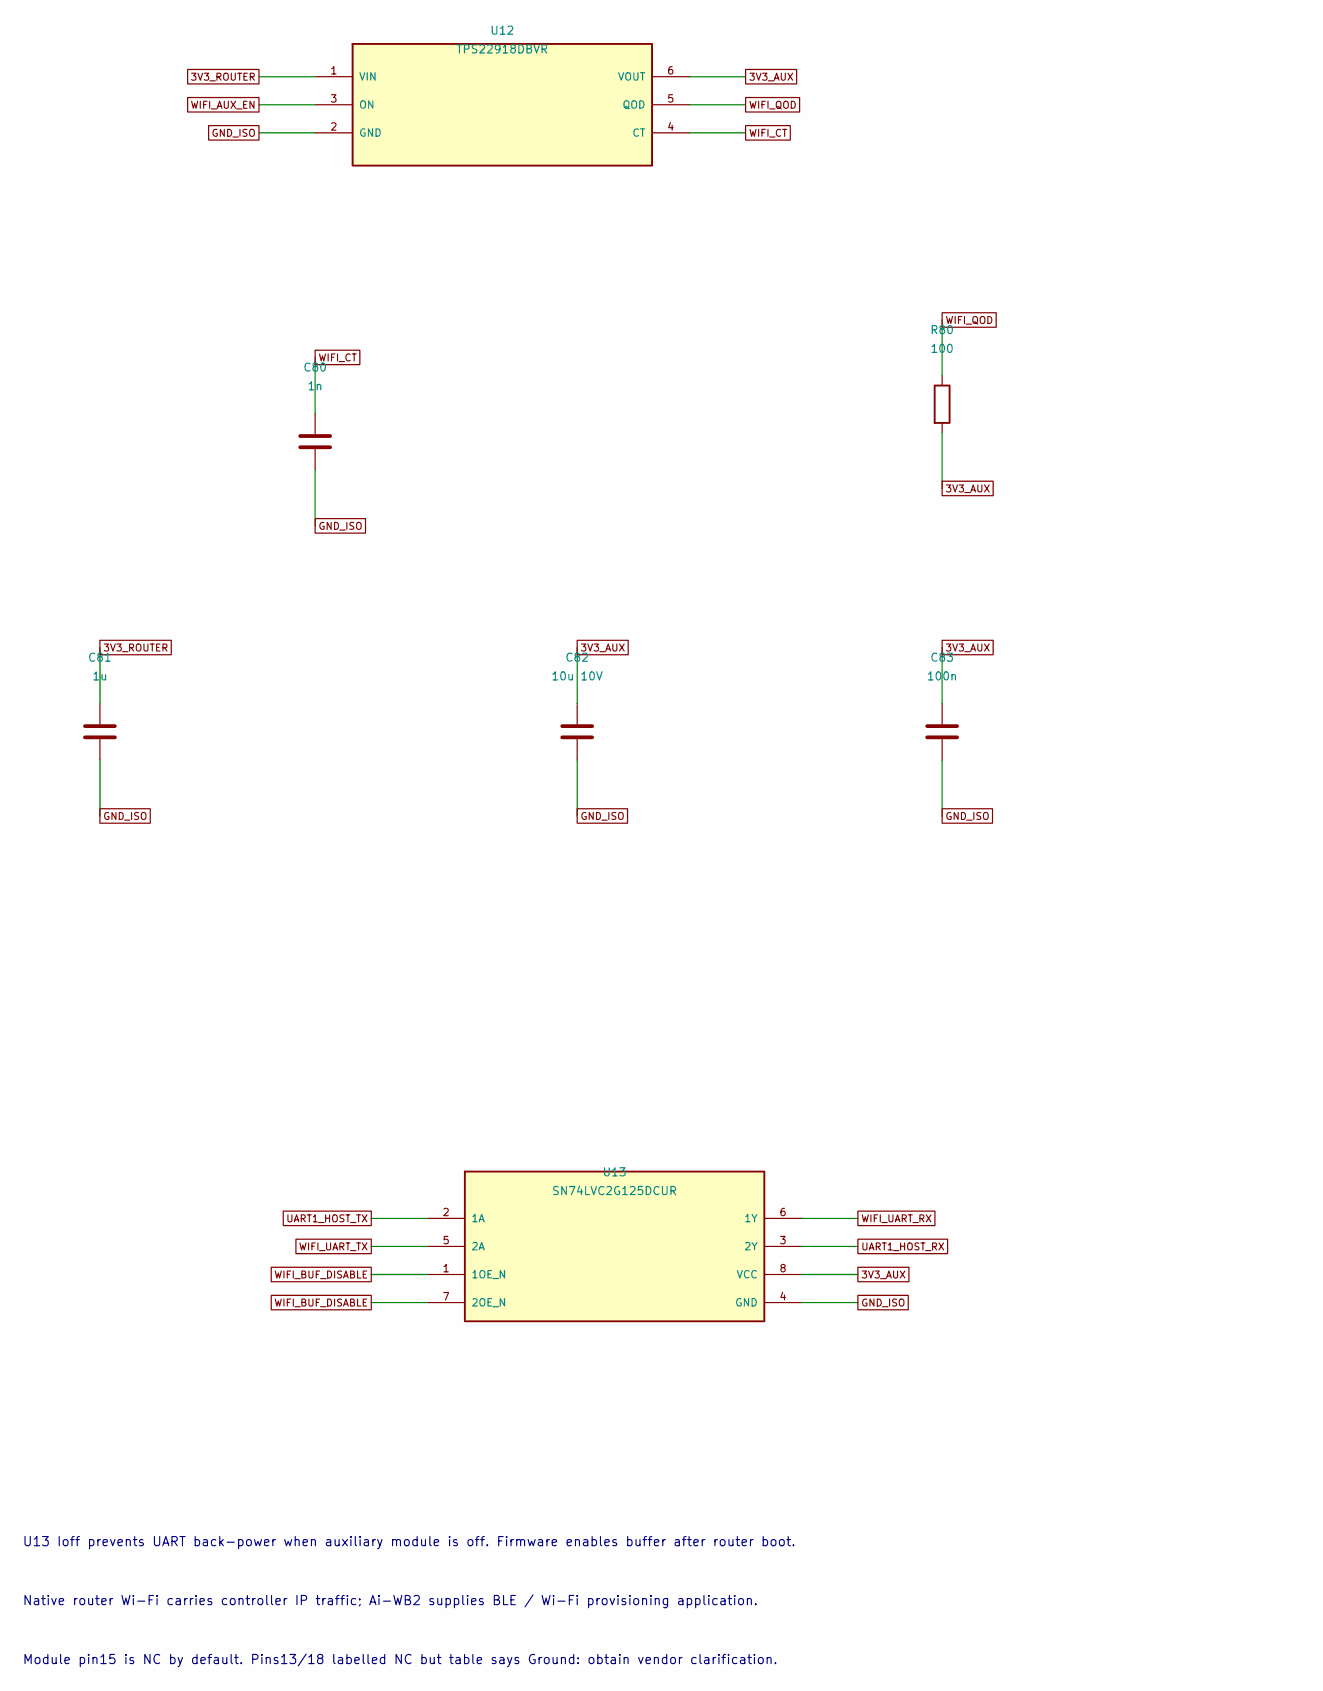
[picture p102: schematic 07_wifi_ble.kicad_sch, part in row 1, column 1]

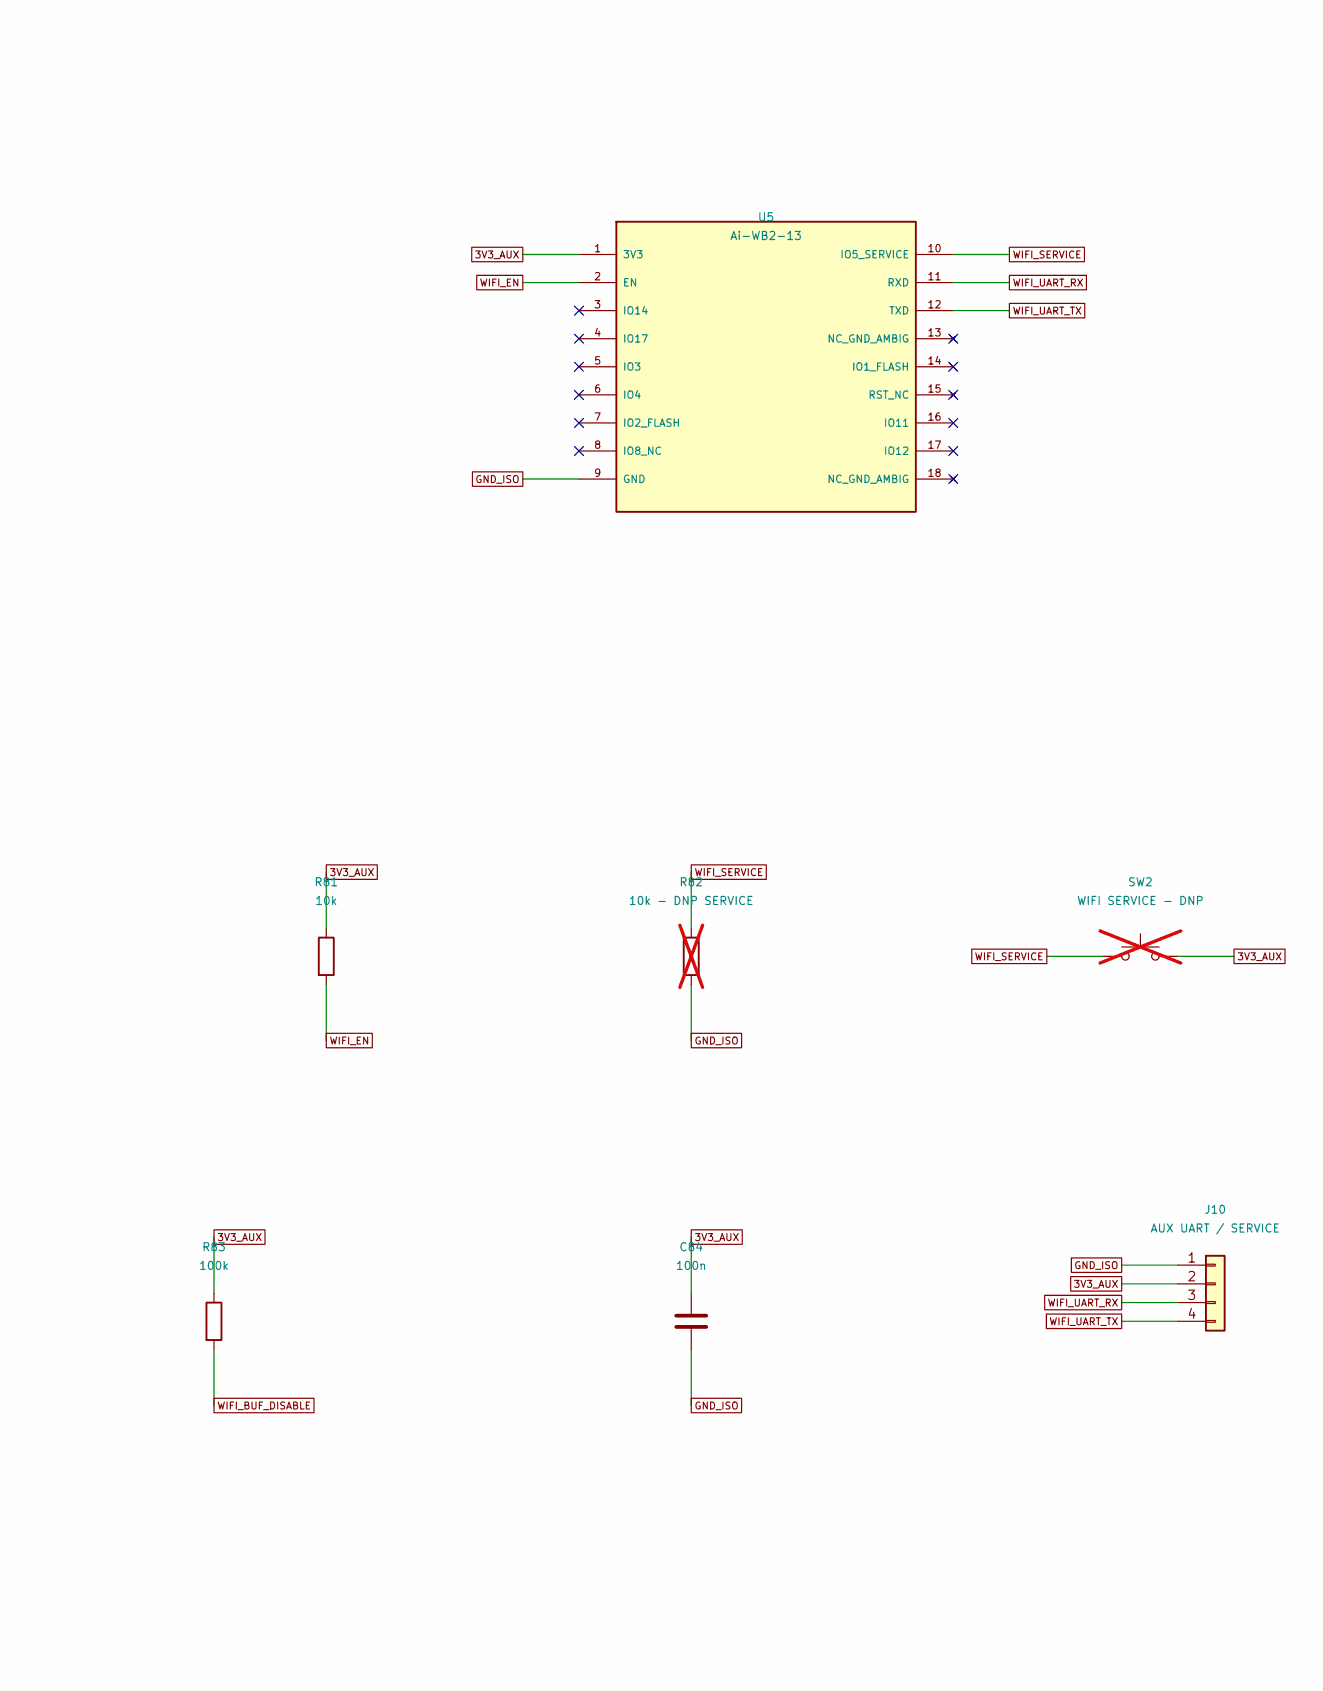
[picture p103: schematic 07_wifi_ble.kicad_sch, part in row 1, column 2]

Parts:
C80: 1n; C_0603_1608Metric; MPN 1n
C81: 1u; C_0603_1608Metric; MPN 1u
C82: 10u 10V; C_0805_2012Metric; MPN 10u 10V
C83, C84: 100n; C_0603_1608Metric; MPN 100n
J10: AUX UART / SERVICE; PinHeader_1x04_P2.54mm_Vertical; MPN AUX UART / SERVICE
R80: 100; R_0603_1608Metric; MPN 100
R81: 10k; R_0603_1608Metric; MPN 10k
R82: 10k - DNP SERVICE; R_0603_1608Metric; MPN 10k - DNP SERVICE; not fitted
R83: 100k; R_0603_1608Metric; MPN 100k
SW2: WIFI SERVICE - DNP; SW_SPST_TL3342; MPN WIFI SERVICE - DNP; not fitted
U5: Ai-WB2-13; AiWB2_13; MPN Ai-WB2-13
U12: TPS22918DBVR; SOT-23-6; MPN TPS22918DBVR
U13: SN74LVC2G125DCUR; VSSOP-8_2.3x2mm_P0.5mm; MPN SN74LVC2G125DCUR

Connections:
3V3_AUX: C82.1, C83.1, C84.1, J10.2, R80.2, R81.1, R83.1, SW2.2, U5.1 (3V3), U12.6 (VOUT), U13.8 (VCC)
3V3_ROUTER: C81.1, U12.1 (VIN)
GND_ISO: C80.2, C81.2, C82.2, C83.2, C84.2, J10.1, R82.2, U5.9 (GND), U12.2 (GND), U13.4 (GND)
UART1_HOST_RX: U13.3 (2Y)
UART1_HOST_TX: U13.2 (1A)
WIFI_AUX_EN: U12.3 (ON)
WIFI_BUF_DISABLE: R83.2, U13.1 (1OE_N), U13.7 (2OE_N)
WIFI_CT: C80.1, U12.4 (CT)
WIFI_EN: R81.2, U5.2 (EN)
WIFI_QOD: R80.1, U12.5 (QOD)
WIFI_SERVICE: R82.1, SW2.1, U5.10 (IO5_SERVICE)
WIFI_UART_RX: J10.3, U5.11 (RXD), U13.6 (1Y)
WIFI_UART_TX: J10.4, U5.12 (TXD), U13.5 (2A)

Notes on the sheet:
U13 Ioff prevents UART back-power when auxiliary module is off. Firmware enables buffer after router boot.
Native router Wi-Fi carries controller IP traffic; Ai-WB2 supplies BLE / Wi-Fi provisioning application.
Module pin15 is NC by default. Pins13/18 labelled NC but table says Ground: obtain vendor clarification.
