samd-atlantis/A-14329-RG-Atlantis-Modem/firmware/tests/test_firstboot.py

"""Run first-boot shell logic with fake UCI/system services; no router required."""
import os
import ipaddress
import re
from pathlib import Path
import shutil
import subprocess
import tempfile
import unittest

ROOT = Path(__file__).resolve().parents[1]
BASH = shutil.which('bash') or r'C:/Program Files/Git/bin/bash.exe'


class FirstBootTest(unittest.TestCase):
    sourced_by_boot = False

    def setUp(self):
        self.tmp = tempfile.TemporaryDirectory(dir=ROOT)
        self.dir = Path(self.tmp.name)
        posix = self.dir.as_posix()
        if os.name == 'nt':
            posix = '/' + posix[0].lower() + posix[2:]
        self.env = os.environ.copy()
        self.env.update(TEST_DIR=posix, PROVISIONED='0', SERIAL='BENCH-0001',
                        SSID='Atlantis-AUTO', KEY='0123456789abcdef01234567',
                        HASH='$6$testsalt$' + 'a'*86, FAIL_CONFIG='0', WAN_ZONE='wan',
                        FAIL_JSON='0', FAIL_GATEWAY_COMMIT='0')
        (self.dir/'unit.json').write_text('{}')
        (self.dir/'wifi-mac').write_text('00:11:22:33:a1:b2\n')
        (self.dir/'shadow').write_text('root:*:0:0:99999:7:::\ndaemon:*:0:0:99999:7:::\n')
        source = (ROOT/'package/atech-gateway/files/etc/uci-defaults/99-atech-gateway').read_text()
        source = source.replace('/etc/gateway/unit.json', posix+'/unit.json')
        source = source.replace('/etc/shadow', posix+'/shadow')
        source = source.replace('/sys/class/ieee80211/phy0/macaddress', posix+'/wifi-mac')
        mocks = '''
uci() {
 case "$*" in
  '-q get gateway.main.provisioned') echo "$PROVISIONED";;
  'show firewall') echo 'firewall.@zone[1]=zone';;
  '-q get firewall.@zone[1].name') echo "$WAN_ZONE";;
  '-q show wireless') printf 'wireless.radio0=wifi-device\nwireless.radio1=wifi-device\n';;
  *)
   echo "uci $*" >> "$TEST_DIR/log"
   if [ "$FAIL_CONFIG" = 1 ] && [ "$*" = 'set uhttpd.main.redirect_https=1' ]; then return 1; fi
   case "$*" in
    'set gateway.main.provisioned=1') echo 1 > "$TEST_DIR/staged_gateway";;
    '-q revert gateway') rm -f "$TEST_DIR/staged_gateway";;
    '-q delete gateway.main.provisioned') echo 0 > "$TEST_DIR/staged_gateway";;
    'commit gateway')
     [ "$FAIL_GATEWAY_COMMIT" != 1 ] || return 1
     if [ -f "$TEST_DIR/staged_gateway" ]; then mv "$TEST_DIR/staged_gateway" "$TEST_DIR/committed_gateway"; fi
     ;;
    '-q commit gateway')
     if [ -f "$TEST_DIR/staged_gateway" ]; then mv "$TEST_DIR/staged_gateway" "$TEST_DIR/committed_gateway"; fi
     ;;
   esac
   return 0
   ;;
 esac
}
jsonfilter() {
 [ "$FAIL_JSON" != 1 ] || return 1
 case "$4" in
  '@.serial') echo "$SERIAL";;
  '@.ssid') echo "$SSID";;
  '@.wifi_password') echo "$KEY";;
  '@.root_hash') echo "$HASH";;
 esac
}
passwd() { echo "passwd $*" >> "$TEST_DIR/log"; }
logger() { echo "logger $*" >> "$TEST_DIR/log"; }
wifi() { echo "wifi $*" >> "$TEST_DIR/log"; }
'''
        self.script = self.dir/'firstboot.sh'
        self.script.write_text(source.replace('set -eu', 'set -eu\n'+mocks), newline='\n')

    def tearDown(self):
        self.tmp.cleanup()

    def run_script(self):
        command = [BASH, str(self.script)]
        if self.sourced_by_boot:
            # OpenWrt /etc/init.d/boot sources each defaults file in exactly
            # this AND-list context, which suppresses shell errexit behavior.
            command = [BASH, '-c', '( . "$1" ) && echo APPLIED', 'boot', str(self.script)]
        proc = subprocess.run(command, env=self.env,
                              text=True, capture_output=True)
        path = self.dir/'log'
        return proc, path.read_text() if path.exists() else ''

    def assert_failed_closed(self, proc, log):
        self.assertNotEqual(proc.returncode, 0)
        self.assertIn('passwd -l root', log)
        self.assertIn('set wireless.radio0.disabled=1', log)
        self.assertIn('set wireless.radio1.disabled=1', log)
        self.assertIn('wifi down', log)
        self.assertIn('-q set system.@system[0].ttylogin=0', log)
        self.assertNotIn('gateway.main.provisioned=1', log)

    def test_success_sets_credentials_and_lan_only_defaults(self):
        proc, log = self.run_script()
        self.assertEqual(proc.returncode, 0, proc.stderr)
        self.assertIn('set network.cellular.auto=0', log)
        self.assertIn('set dropbear.@dropbear[0].Interface=lan', log)
        self.assertIn('set system.@system[0].ttylogin=1', log)
        self.assertNotIn('ttylogin=0', log)
        self.assertIn('set firewall.@zone[1].input=REJECT', log)
        self.assertIn('set gateway.main.provisioned=1', log)
        self.assertIn('set wireless.default_radio0.ssid=Atlantis-A1B2', log)
        self.assertIn('set wireless.default_radio0.macaddr=00:11:22:33:A1:B2', log)
        self.assertIn('set network.lan.ipaddr=10.0.100.7', log)
        self.assertIn('set network.lan.netmask=255.255.254.0', log)
        start = int(re.search(r'uci set dhcp.lan.start=(\d+)', log)[1])
        limit = int(re.search(r'uci set dhcp.lan.limit=(\d+)', log)[1])
        network = ipaddress.ip_network('10.0.100.7/255.255.254.0', strict=False)
        config = (ROOT/'package/atech-gateway/files/etc/config/gateway').read_text()
        addresses = re.findall(r"option address '([^']+)'", config)
        self.assertEqual(addresses, ['10.0.100.' + str(i) for i in range(101, 105)])
        self.assertEqual(config.count("option scheme 'http'"), 4)
        pool = {network.network_address + i for i in range(start, start + limit)}
        self.assertEqual((str(min(pool)), str(max(pool))), ('10.0.100.150', '10.0.100.199'))
        self.assertTrue(all(ipaddress.ip_address(ip) in network and ipaddress.ip_address(ip) not in pool for ip in addresses))
        self.assertIn('root:'+self.env['HASH']+':', (self.dir/'shadow').read_text())
        self.assertNotIn('wifi down', log)

    def test_missing_unit_locks_root_and_disables_every_radio(self):
        (self.dir/'unit.json').unlink()
        proc, log = self.run_script()
        self.assert_failed_closed(proc, log)
        # The secret-free validation image retains the upstream local fixture
        # console; this is not network access and is never customer firmware.
        self.assertNotIn('ttylogin=1', log)

    def test_bad_hash_does_not_configure_wifi(self):
        self.env['HASH']='$6$not-a-valid-hash'
        proc, log = self.run_script()
        self.assert_failed_closed(proc, log)
        self.assertNotIn('disabled=0', log)

    def test_bad_ssid_does_not_configure_wifi(self):
        self.env['SSID']='shared-default'
        self.assert_failed_closed(*self.run_script())

    def test_concrete_label_ssid_must_match_actual_radio_mac(self):
        self.env['SSID'] = 'Atlantis-FFFF'
        self.assert_failed_closed(*self.run_script())

    def test_concrete_matching_ssid_is_accepted(self):
        self.env['SSID'] = 'Atlantis-A1B2'
        proc, log = self.run_script()
        self.assertEqual(proc.returncode, 0, proc.stderr)
        self.assertIn('set wireless.default_radio0.ssid=Atlantis-A1B2', log)

    def test_missing_radio_mac_locks_setup(self):
        (self.dir/'wifi-mac').unlink()
        self.assert_failed_closed(*self.run_script())

    def test_invalid_zero_or_multicast_radio_mac_locks_setup(self):
        for mac in ('', '00:00:00:00:00:00', 'FF:FF:FF:FF:FF:FF',
                    '01:11:22:33:a1:b2', 'not-a-mac', '00:11:22:33:zz:zz',
                    '00:11:22:33:a1:b2\nextra'):
            with self.subTest(mac=mac):
                path = self.dir/'log'
                if path.exists():
                    path.unlink()
                (self.dir/'wifi-mac').write_text(mac)
                self.assert_failed_closed(*self.run_script())

    def test_short_wifi_key_does_not_enable_access(self):
        self.env['KEY'] = 'abcd'
        self.assert_failed_closed(*self.run_script())

    def test_failed_json_read_does_not_enable_access(self):
        self.env['FAIL_JSON'] = '1'
        self.assert_failed_closed(*self.run_script())

    def test_missing_wan_zone_does_not_enable_wifi(self):
        self.env['WAN_ZONE']='lan'
        proc, log = self.run_script()
        self.assert_failed_closed(proc, log)
        self.assertNotIn('disabled=0', log)

    def test_mid_setup_failure_locks_root_and_overrides_wifi_enable(self):
        self.env['FAIL_CONFIG']='1'
        proc, log = self.run_script()
        self.assert_failed_closed(proc, log)
        self.assertGreater(log.rindex('set wireless.radio0.disabled=1'),
                           log.index('set wireless.radio0.disabled=0'))
        self.assertGreater(log.index('ttylogin=0'), log.index('ttylogin=1'))
        self.assertIn('root:*:', (self.dir/'shadow').read_text())

    def test_failed_final_commit_cannot_be_published_by_boot_global_commit(self):
        self.env['FAIL_GATEWAY_COMMIT'] = '1'
        proc, log = self.run_script()
        self.assertNotEqual(proc.returncode, 0)
        self.assertNotIn('APPLIED', proc.stdout)
        # The success marker was staged, then reverted and deleted on failure.
        self.assertIn('gateway.main.provisioned=1', log)
        self.assertGreater(log.index('-q revert gateway'), log.index('gateway.main.provisioned=1'))
        self.assertIn('-q delete gateway.main.provisioned', log)
        self.assertIn('wifi down', log)
        self.assertGreater(log.index('ttylogin=0'), log.index('ttylogin=1'))
        self.assertGreater(log.rindex('passwd -l root'), log.index('gateway.main.provisioned=1'))
        for filename in ('staged_gateway', 'committed_gateway'):
            path = self.dir / filename
            self.assertFalse(path.exists() and path.read_text().strip() == '1')

    def test_sysupgrade_does_not_overwrite_site_config(self):
        self.env['PROVISIONED']='1'
        (self.dir/'unit.json').unlink()
        proc, log = self.run_script()
        self.assertEqual(proc.returncode, 0, proc.stderr)
        self.assertEqual(log, '')


class FirstBootSourcedTest(FirstBootTest):
    sourced_by_boot = True


if __name__ == '__main__':
    unittest.main()
