samd-atlantis/A-14329-RG-Atlantis-Modem/(commit log)

2026-10-29 Complete native ground-pour and terminal fit audit evidence
2026-10-29 Verify packaged firmware contents and document first-board recovery evidence
2026-10-29 Clarify first-power-up sequence and total input current limit
2026-10-29 Fix OpenWrt I2C dependency and verify runtime package selection
2026-10-30 Add disabled WireGuard support and local Atlantis customer portal
2026-10-30 Record WireGuard firmware and portal validation runs
2026-10-30 Put permanent connect.atlantisllc.com unit URLs on enclosure labels
2026-11-01 Prepare ECO50 placement fixes and modem power test configuration
2026-11-01 Save native-reviewed ECO50 board and schematic with zero PCB DRC findings
